clChenLiang/keyboard-trackpad-cross-axis-redesign/outputs/cross-axis-slider-v12-usability-audit/references/exploded-reference.jpg

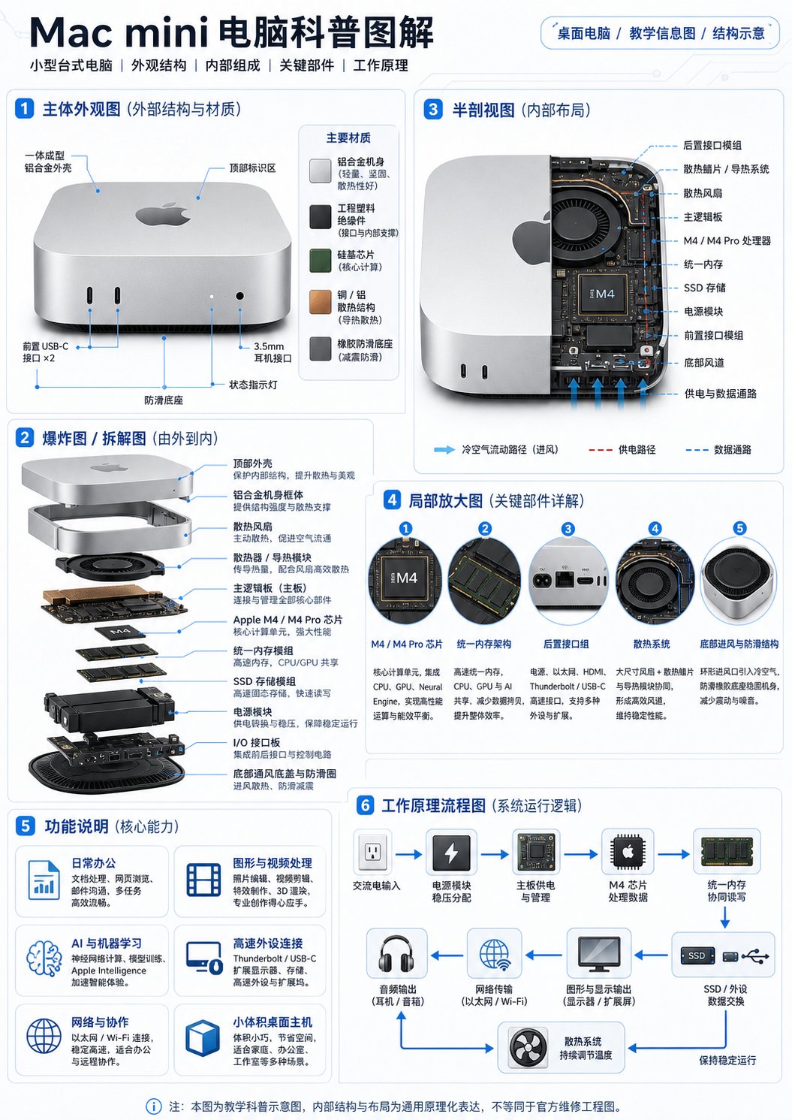
outputs/cross-axis-slider-v12-usability-audit/references/exploded-reference.jpg
