clChenLiang/keyboard-trackpad-cross-axis-redesign/docs/superpowers/specs/2026-07-15-v8-collision-free-linkage-design.md

# V8 全行程避碰联动设计

## 目标

保留 V7 已确认的低抬手端位和双侧对称驱动，消除 0%–100% 行程中的实体硬碰撞。旧版本文件保持不变，新模型写入 `cross-axis-slider-concept-v8-collision-free`。

## 结构决定

- 保留键盘 `+30 Y / -15 Z`、妙控板 `-115 Y / -43 Z` 的直线端位，以及由相对位移严格推导的 `+10.929488°` 滑槽。
- 每侧只保留一块蓝色长槽板和一个滚轮。红色驱动杆、蓝色槽板、妙控板固定导轨、键盘固定导轨由内到外分层，实体厚度之间至少保留 0.8 mm 横向净空。
- 交叉轴只从红色驱动杆延伸到蓝色槽板，不再向托盘内侧伸出；滚轮位于槽口内，轴肩不侵入托盘。
- 妙控板和键盘各自采用双滚轮直线导向；滚轮在真实镂空槽内运动，支座放在有效行程以外。
- 双侧压缩弹簧仍沿键盘运动轴布置，终态由实体限位芯确定。弹簧属于柔性件，碰撞验收只豁免其与自身座/芯的设计接触。
- 两个连续托盘保持独立，底板继续使用 308 × 280 mm 四窗口镂空形式。

## 验收

- 201 点运动学采样：槽中心线误差接近数值零、滚轮始终留在槽有效长度内、弹簧单调压缩。
- 21 点实体布尔碰撞采样：底板—运动件、固定件—运动件、键盘运动组—妙控板运动组均无正体积相交；仅允许清单中的轴—连接件和弹簧—座/芯装配关系。
- 输出键盘、50% 中间、妙控板三份 STEP，并在 CAD Explorer 中提供链接。
