clChenLiang/keyboard-trackpad-cross-axis-redesign/docs/superpowers/specs/2026-07-17-v13-under-100-slider-design.md

# V13 百元版交叉滑块联动支架设计规范

日期：2026-07-17  
状态：待用户书面规范确认  
新版本目录：`outputs/cross-axis-slider-v13-under-100/`

## 1. 目标与边界

V13 是独立新方案，不修改或覆盖 V12。单台成本口径为实际消耗的打印材料与五金，
不包含购买整卷耗材、运费、打印机折旧和失败重打，目标不超过人民币 100 元。

保留以下用户需求：

- 键盘托与妙控板托为两个独立、完整连续平面。
- 键盘位于下层主位，妙控板靠右对齐并停放在其上方或后方。
- 左手按下并向前下方推动键盘托，妙控板托进入右手区域并轻微下降。
- 松手自动回位。
- 左右双侧对称支承，不使用侧护罩、桌夹或掌托。
- 交叉点必须是真实滑动副，不允许用伸缩刚性杆掩盖运动矛盾。

V13 允许降低工业级寿命与恒力手感，但不得牺牲基本可动性、端位可靠性和输入表面完整性。

## 2. 降本决策

V13 删除：

- 604ZZ 导向轴承 8 个。
- AMPG 精密肩轴 12 根及其对应的 12 组垫片、螺母。
- MISUMI CFS0.2 恒力弹簧 2 只及卷筒、挡帽、端片固定结构。
- 与上述零件专用的导向偏心套和轴向堆叠空间。

V13 保留：

- MR84ZZ 交叉滚轮 4 个，每侧 2 个。
- 左右对称的红色键盘运动件与蓝色妙控板运动件。
- 蓝色长槽内两个滚轮接触相对槽壁的真实滑动交点。
- 可调端位和独立回位件。

## 3. 机构架构

### 3.1 直线导向

原 604ZZ 滚轮斜槽改为宽面打印滑块导向。每个托盘在左右两侧各设置一个长导向鞋，
导向鞋与固定侧框的浅 U 形导轨配合。单侧轨道负责定位，另一侧增加 0.6–1.0 mm
横向随动余量，继续采用“左侧基准、右侧随动”策略，避免双侧过约束。

导向鞋是独立可更换打印件。工作面粘贴 0.10–0.20 mm PTFE/UHMW 耐磨胶带；胶带
损坏时只更换导向鞋或胶带，不更换托盘滑架。导向鞋采用至少 12 mm 长的面接触，
不使用细长打印销承担直线导向载荷。

### 3.2 交叉滑动交点

每侧保留两个 MR84ZZ，安装在红色键盘滑架上，并置于蓝色妙控板滑架的长槽内。
两个滚轮分别接触长槽的相对壁，以承担正反向载荷并限制间隙。

轴承安装改为一体打印加强轴座：轴座根部外径不小于 8 mm，短轴颈只穿过 3 mm
宽的 MR84ZZ 内圈。使用普通 M3 低头螺钉和小垫片防止轴承轴向脱出。打印轴颈
不承担 12–20 mm 的细长悬臂载荷。

左侧第二个滚轮保留小范围偏心或椭圆调节座，用于消除明显间隙；右侧长槽适当放宽，
不进行双壁强预紧。

### 3.3 自动回位

每侧使用一根普通拉伸弹簧，沿键盘导向轨迹布置。固定端连接侧框，移动端连接键盘
滑架。弹簧在键盘默认端位保持最小预拉伸，确保松手后无空程回位。

拉簧目标参数：

- 两侧合计默认端回位力 3–5 N。
- 满行程两侧合计回位力不超过 8 N。
- 有效伸长覆盖键盘完整行程并保留至少 20% 行程余量。
- 两只弹簧来自同一规格和批次。

最终型号在参数化运动与力学窗口计算后确定；首个概念 STEP 只显示真实弹簧安装点与
包络，不把暂定商品型号写死为已验证件。

### 3.4 端位

取消轴承撞槽端的限位方式。默认端和按压端均由可更换 TPU 95A 缓冲块接触打印止挡。
缓冲块采用卡入式结构，不增加金属紧固件。两端均保留至少 2 mm 的交叉滚轮槽端余量。

## 4. 打印结构

- PETG-HF：底座、左右固定侧框、两托盘、四个运动滑架和可更换导向鞋。
- TPU 95A：设备垫、底脚和端位缓冲块。
- 底座继续开放式镂空，目标 PETG 总消耗 450–550 g。
- TPU 总消耗不超过 20 g。
- 托盘保持连续输入面，不在键盘或妙控板支承区域开材料孔。
- 所有运动副都位于托盘侧边，不跨越输入表面。

## 5. 目标五金清单与成本上限

| 项目 | 数量 | 目标小计 |
|---|---:|---:|
| MR84ZZ | 4 | ¥12–20 |
| 普通 M3 低头螺钉和小垫片 | 4 组 | ¥3–6 |
| 普通拉伸弹簧 | 2 | ¥8–15 |
| 托盘、侧框连接用 M3/M4 螺钉螺母 | 1 套 | ¥9–12 |
| PTFE/UHMW 耐磨胶带 | 实际用量 | ¥3–5 |
| PETG-HF | 450–550 g | ¥29–36 |
| TPU 95A | 不超过 20 g | ¥2–5 |
| **目标合计** |  | **¥66–99** |

采购门槛：MR84ZZ 单价超过 5 元或拉簧一对超过 15 元时，不得直接扩大总预算，必须
改用同尺寸替代供应商或进一步减材。

## 6. 参数化与输出

采用 STEP-first 的 build123d/Python，建立以下核心参数：

- 键盘与妙控板各自的 Y/Z 行程。
- 交叉长槽长度、宽度、方向与两个滚轮间距。
- 左右导向轨迹、右侧随动间隙和导向鞋长度。
- 拉簧固定点、移动点、预拉伸和全程长度。
- 两端 TPU 止挡位置与槽端安全余量。

第一阶段输出独立的 `keyboard_mode.step`、`mid_mode.step`、`trackpad_mode.step` 和
`master_assembly.step`。STEP 中按固定结构、键盘运动组、妙控板运动组、交叉滚轮、
回位件和缓冲件分别标记，便于 CAD Explorer 单独选择。

## 7. 验证门槛

概念 STEP 至少通过：

1. 401 个运动采样点的交叉长槽闭合关系。
2. 左右轨迹一致性和右侧随动余量检查。
3. 全行程无刚性零件碰撞。
4. 两端滚轮距离长槽端部至少 2 mm。
5. 拉簧长度、预拉力、最大拉力和行程余量计算。
6. 手部区域无侧护罩、连杆或弹簧侵入。
7. CAD 体积换算后的 PETG、TPU 用量和百元 BOM 复核。

在首件实物完成前，不宣称长期寿命、摩擦系数或最终手感已经验证。首件需要检查启动
摩擦、左右同步、导向鞋磨耗、回位连续性，并至少完成 100 次慢速循环。

## 8. 已接受的取舍

- 普通拉簧的力会随行程上升，不具备恒力弹簧的均匀手感。
- 打印导向鞋的摩擦和寿命不如滚珠轴承，需要定期更换耐磨胶带。
- 百元目标优先于工业标准件、免维护寿命和极低摩擦。
- 交叉滑动交点仍保留滚珠轴承，因为它是联动可靠性最敏感的位置。
