clChenLiang/keyboard-trackpad-cross-axis-redesign/outputs/cross-axis-slider-v12-usability-audit/CAD_BRIEF.md

# V12 CAD 交付摘要

- 坐标：X 左右，+Y 朝显示器，+Z 向上，单位 mm。
- 键盘托行程：`+30 Y / -17 Z`；妙控板托行程：`-115 Y / -40 Z`。
- 妙控板工作位托盘 Z=28；装上设备后，其操作面比默认键盘操作面高约 5 mm。
- 两托盘均保留 279.7 × 115.7 连续平面；妙控板靠右。
- 运动拓扑：左右固定直线槽＋左右交叉长槽。左侧定轨，右侧槽额外加宽 1.00 mm 作为随动侧，避免重复刚性约束。
- 回位：左右各一只 MISUMI CFS0.2，原装卷筒套入侧架 Ø7.8 一体轴柱，原装端片固定到侧框。
- 限位：两根 Ø3 导杆上的 TPU C 环承担端位；滚轮不撞槽端。
- 托盘筋宽 11；20 N 一阶梁筛查中心挠度 0.948 mm。
- STEP：`keyboard_mode.step`、`mid_mode.step`、`trackpad_mode.step`、`master_assembly.step`。
- 设备净空参考：`device_clearance_reference.step`；主查看文件仍隐藏设备包络。
- 滚轮查看：`roller_detail_assembled.step`、`roller_detail_exploded.step`。
- 制造文件：`printables/` 下分件 STEP/STL 与 6 张单材料 3MF。

已记录但未隐藏的包络偏差：当前完整金属紧固件总宽约 347.6，超过 310 mm 原目标；当前总高约 97.5，超过 85 mm 原目标。继续压低会令交叉槽、导向滚轮和固定框发生实体相交，因此本版优先保证真实闭合与低手部抬升。上述偏差仍需用户接受或在下一代重新布置 X 向层级。

强度结果是一阶筛查，不是 FEA。10,000 次寿命、45°C 蠕变、按压力和回位时间仍必须由首件实测。
