clChenLiang/keyboard-trackpad-cross-axis-redesign/outputs/cross-axis-slider-v12-usability-audit/FIRST_ARTICLE_CHECKLIST.md

# V12 首件打印与实体验收

数字验证已覆盖 401 个运动采样点和 101 个精确碰撞姿态，但首件循环仍是投入使用前的必做项。
实测数值统一填写到 `FIRST_ARTICLE_RESULTS.csv`，不要只勾选而不记录数据。

## 打印前

- [ ] 先打印 `printables/calibration_coupon.*`，确认 604ZZ、MR84ZZ、偏心套和 M4 热熔螺母配合。
- [ ] 在切片软件中确认六张 3MF 保持多对象结构；不要自动合并相交物体。
- [ ] PETG-HF 与 TPU 95A 分开打印；按 `PRINT_SETTINGS.md` 设置壁数、填充和支撑。
- [ ] 到货型号为 MISUMI CFS0.2；确认 0.2 的单位为 kgf，并记录两只弹簧实测力值。

## 空载装配

- [ ] 左右框固定后六脚同时着地，侧框无肉眼可见内八/外八。
- [ ] 12 个轴承外圈均能转动，螺母只夹紧内圈。
- [ ] 左侧交叉滚轮轻触长槽相对壁；右侧为随动侧，允许小间隙但不得敲击或夹死。
- [ ] 两根 Ø3 × 122 限位导杆到底；每只 CFS0.2 初始展开不少于 45 mm，原装端片和 TPU 挡帽已安装。
- [ ] 左右托盘连接均已刚性锁紧；右侧只通过加宽导槽随动，没有 TPU 轴向垫片。

## 空载循环

- [ ] 慢速完成 20 次全行程，左右端同步。
- [ ] 中间任意位置松手，能连续返回键盘端位。
- [ ] 两端由 TPU 环限位；轴承不撞槽端。
- [ ] 无钢带擦碰、跳卷、轴承拖滑、异响或明显偏磨。

## 带载循环

- [ ] 放入实际键盘与妙控板后完成 100 次慢速全行程。
- [ ] 实测启动力不超过 8 N（首件绝对上限 12 N），保持力目标 6–8 N；超出时先检查右侧过度预紧与 CFS 批次。
- [ ] 从 25%、50%、75% 行程分别松手，均能自动回到键盘端；记录空载回位时间，目标 0.4–0.7 s。
- [ ] 妙控板终态能到右手区，键盘托不妨碍手部抬升。
- [ ] 100 次后复查 M3 螺母、M4 螺钉、热熔螺母和 TPU 环，无松动或位移。
- [ ] 检查两侧所有可触及动态夹缝；任一处必须在全行程保持不大于 4 mm 或不小于 25 mm。无法满足时先增加固定侧护罩，再重新完成循环与碰撞验收。

任一项失败即停止使用，记录失败姿态、左右侧、接触位置和弹簧批次后再修改 CAD；不要靠增大偏心预紧掩盖几何干涉。

## 耐久与环境释放门槛

- [ ] 20 N 中央静载后测量托盘挠度；目标不超过 1.0 mm。
- [ ] 8 N 偏心按压时无卡滞。
- [ ] 12 N 斜向推力下底座滑移不超过 1.0 mm。
- [ ] 45°C 放置 24 h 后复测端点与按压力。
- [ ] 完成 10,000 次循环，期间每 1,000 次记录松动、磨损和端点重复性。
