clChenLiang/keyboard-trackpad-cross-axis-redesign/outputs/cross-axis-slider-v12-usability-audit/PROCUREMENT.md

# 外购件核对

## 恒力弹簧

- 型号：MISUMI `CFS0.2`，数量 2。
- 额定力：0.2 kgf = 1.961 N/侧；注意型号数字不是牛顿值。
- 最大行程：500 mm；本机构有效展开行程约 125 mm，另有 45 mm 初始展开量。
- 标称耐久：35,000 次；载荷公差 0/+15%。
- 小规格外形：D26、D1 8.2、W10、端片孔 d3.2、端片长18。
- 原装 PE 卷筒和带孔端片都必须保留；不要另购 608 轴承或打印替代卷轮。

官方产品页：<https://uk.misumi-ec.com/vona2/detail/110302307050/?HissuCode=CFS0.2>

官方目录：<https://us.misumi-ec.com/pdf/fa/2019/2019_US_2526.pdf>

## 到货检查

1. 包装型号必须为 `CFS0.2`，不是 `CFS2.0`。
2. 两只弹簧分别用推拉力计抽测；记录稳定段力值与批次。
3. 卷筒孔应能在 Ø7.8 试轴上自由转动，无明显径向摆动。
4. 原装端片 Ø3.2 孔不得扩孔；使用 M3 × 8 与热熔螺母固定。
5. 若任一尺寸或力值与上述不符，停止装配并重新计算回位窗口。

## 滚轮与肩轴

- 交叉槽滚轮：`MR84ZZ`，4 × 8 × 3 mm，数量 4。
- 固定导槽滚轮：`604ZZ`，4 × 12 × 4 mm，数量 8。
- MISUMI AMPG 超低头肩轴，肩部 Ø4、M3 × 0.5 × 4 螺纹、头部 Ø6 × 1.30 mm：
  - `STR402M4X20HUL`，20 mm 肩长，数量 4；
  - `STR402M4X16HUL`，16 mm 肩长，数量 4；
  - `STR402M4X12HUL`，12 mm 肩长，数量 4。

官方尺寸页：<https://us.c.misumi-ec.com/book/1AM1_USA_02/pdf/0143.pdf>

604ZZ：<https://uk.misumi-ec.com/vona2/detail/221000058378/?HissuCode=604ZZ>

MR84ZZ：<https://uk.misumi-ec.com/vona2/detail/221000528976/?HissuCode=MR84ZZ>
