clChenLiang/keyboard-trackpad-cross-axis-redesign/outputs/cross-axis-slider-v12-usability-audit/RELEASE_STATUS.md

# V12 发布状态

状态：**数字设计候选通过；尚未批准作为日常使用成品。**

## 已通过

- 401 点运动学与双边并行/随动检查。
- 101 点完整 BREP 碰撞和近间隙扫描，0 碰撞。
- 打印容差预算后的机构/设备最小净空均不小于 1.0 mm。
- 五金堆栈、连接界面、单实体、H2D 排盘、STL 封闭性和一阶强度筛查。

## 仍需实物关闭

- 校准片、热熔螺母和轴承/偏心套的真实配合。
- 20/100 次首件循环，启动力、保持力和自动回位时间。
- 20 N 挠度、8 N 偏心输入、12 N 底座防滑和 45°C/24 h。
- 10,000 次寿命与紧固件松动检查。
- 两侧交叉槽/连杆目前外露。投入日常使用前必须通过夹手风险实测；可触及动态间隙需做到不大于 4 mm 或不小于 25 mm，未满足时必须增加不随动的侧护罩，不能仅贴警示标签。

在上述项目完成并记录到 `FIRST_ARTICLE_RESULTS.csv` 前，本版只作为工程首件打印候选。
