clChenLiang/keyboard-trackpad-cross-axis-redesign/outputs/rack-pinion-swing-tray-main-v3/CAD_BRIEF.md

# 键盘托／妙控板托切换主体 V3 — 连接与检修物理化

本目录是独立 V3，不修改或覆盖 V1/V2。单位为 mm；X 左右、+Y 朝显示器、+Z 向上。

## 本轮模型

- 基线：完整连续键盘托、160.8 × 115.7 mm 妙控板目标托、齿条—26T 小齿轮—竖轴—偏心悬臂、四点平行斜导向及 V2 已验证的运动关系。
- 四个滑块：各增加一个可单独选中的托底连接耳；键盘托侧增加四个真实匹配孔和可单独选中的衬套，全部采用 M4 名义通孔并随键盘托作同一刚体平移。
- 四组固定导轨：各增加一组可单独选中的双安装脚和底座孔位接口；安装脚落在底座顶面，孔位以 M4 名义通孔表达。
- 固定圆筒：原一体式顶封板已开通为 Ø33 mm 检修口；增加可拆上盖、轴孔及两处前上方紧固孔接口。爆炸剖视中上盖上移，拆盖后检修路径真实贯通。
- 齿条：增加可单独选中的刚性过渡板，将齿条背脊与键盘托底面真实桥接。

## 参数与定位

- M4 名义通孔：4.5 mm。
- 连接耳厚度：4.0 mm；每个耳板一个通孔。
- 托盘衬套：外径 7.0 mm、托盘配孔 7.2 mm、内孔 4.5 mm；四件均为独立标签。
- 导轨安装脚：沿导轨行程两端布置，落地 Z = 底座顶面；每组两个通孔。
- 圆筒上盖：外径 38 mm、厚 3 mm；中心轴孔与两处 M3 名义孔接口。两紧固柱位于半径 14 mm、75°/105°，避开摆臂全行程。
- 所有运动件的位置只由归一化姿态 `t ∈ [0,1]` 派生，不引入新的运动自由度。

## 输出

- `keyboard_mode.step`
- `mid_mode.step`
- `trackpad_mode.step`
- `cylinder_section_exploded.step`

## 回归门槛

- 至少 11 个姿态检查新增件标签、正体积、刚体随动和关键不干涉。
- 保持 V2 四滑块、四导轨、完整键盘托、妙控板托、齿条、齿轮、竖轴、悬臂和圆筒标签。
- 四个 STEP 可重新读取并保留新增可选标签。

## 明确不做

不引入 A–P 卷筒方案；不定版弹簧、公差、强度/疲劳、BOM、STL/3MF、打印排盘、ZIP 或专利。
