clChenLiang/keyboard-trackpad-cross-axis-redesign/docs/superpowers/specs/2026-07-15-v9-force-closed-cross-slider-design.md

# V9 真实受力闭合交叉滑槽设计

## 目标

新建 `cross-axis-slider-concept-v9-force-closed`，保留 V1–V8。V9 必须满足真实力流：按压键盘托盘后，力通过连续键盘侧架、交叉轴和滚轮作用于连续妙控板槽架，并由妙控板导向副约束为目标运动。

## 拓扑选择

比较三种方案：

1. 固定摇臂加两条径向槽：在当前尺寸内数值搜索得到的最差输出传力投影约 0.14，低于直槽方案。
2. 齿条、同步带或钢索：传力方向更好，但偏离交叉滑槽语义且零件数增加。
3. 双侧直槽滚轮耦合：输出传力投影约 0.166，虽然行程放大导致输入力较大，但它是当前尺寸和少零件约束下最直接、最符合草图的方案。

采用方案 3。3.66 倍行程放大对应至少 3.66 倍理想输入力，这是虚功决定的物理代价，不把它包装成轻触机构。

## 真实刚体与运动副

- 每侧红色键盘侧架为连续实体：托盘连接桥、三角驱动臂、交叉轴根部、两根键盘导向轴根部、弹簧活动座互相重叠连接。
- 每侧蓝色妙控板侧架为连续实体：托盘连接桥、长槽板、两根妙控板导向轴根部互相重叠连接。
- 交叉滚轮外径等于名义槽宽，STEP 中表现为无穿透接触；轴与滚轮内孔同样名义接触。
- 两个托盘各由双滚轮直线导向抑制俯仰，滚轮轴必须与对应连续侧架连接。
- 压缩弹簧沿键盘运动方向布置，活动座属于红色侧架，固定座属于底座框架；两端名义接触。

## 运动与验收

- 键盘端位保持 `+30 Y / -15 Z`。
- 妙控板端位保持 `-115 Y / -43 Z`。
- 直槽角由相对位移推导，为 `+10.929488°`。
- 201 点运动学检查验证槽约束、单调运动和虚功比例。
- 0%、50%、100% 三姿态检查刚体连接图；键盘托到交叉轴、键盘托到两根导向轴、妙控板托到槽板及两根导向轴均必须连通。
- 21 点实体碰撞检查必须无非设计相交；名义接触与同一刚体内部融合不计为碰撞。
- 第一阶段只输出三份 STEP 和 CAD Explorer 链接，不做公差、摩擦、弹簧选型、强度或打印文件。
