clChenLiang/keyboard-trackpad-cross-axis-redesign/docs/superpowers/specs/2026-07-16-v12-exploded-infographic-design.md

# V12 键盘/妙控板切换支架拆解图设计规格

## 目标

制作一张竖版中文产品拆解信息图，视觉语言参考用户提供的 Mac mini 科普图：白色技术说明书背景、蓝色编号标题、清晰的三维爆炸结构、细引线标注和局部放大。图片用于解释当前 V12 CAD 结构，不替代装配图或制造图。

## 构图

- 画布：竖版，约 3:4；白色或极浅灰技术背景，留足四周安全边距。
- 顶部：标题“键盘 / 妙控板联动支架｜结构拆解图”，副标题“交叉长槽联动 · 双侧滚轮导向 · 恒力自动回位”。
- 中央主图：三分之四等轴测视角，沿 Z 向和少量左右方向分层展开，零件保持共同中心线和真实装配方向。
- 右下局部图：肩轴、偏心套、MR84ZZ/604ZZ、垫片和 M3 螺母堆栈放大。
- 底部：一条简短运动链说明，不做复杂流程面板。

## 爆炸层级（由上到下）

1. 蓝色妙控板托盘及 4 个 TPU 垫。
2. 红色键盘托盘及 4 个 TPU 垫。
3. 蓝色左右妙控板滑架，突出交叉长槽与 CFS 卷筒轴柱。
4. 红色左右键盘滑架，突出双交叉滚轮安装点。
5. MR84ZZ 交叉滚轮组和 604ZZ 直线导向滚轮组，肩轴/垫片/螺母沿轴向适度展开。
6. 左右深灰固定侧框，显示两组斜导槽、斜撑和回位固定座。
7. 左右 CFS0.2 恒力弹簧、钢带、TPU 挡帽、Ø3 导杆和四个 TPU 端位环。
8. 深灰开放式镂空底座及 6 个 TPU 防滑脚。

## 颜色和材质

- 键盘运动组：哑光工程红。
- 妙控板运动组：哑光工程蓝。
- 固定框与底座：深石墨灰。
- 轴承：暖金色金属外圈；肩轴、垫片、螺母：银色金属。
- CFS 钢带：浅黄铜/香槟金色；TPU：深黑或深灰。
- 保留轻柔环境阴影，但不使用强反射、黑色摄影棚或夸张霓虹灯。

## 中文标注

主标注限制为 8 项，避免信息拥挤：

1. 完整连续妙控板托盘
2. 完整连续键盘托盘
3. 妙控板长槽滑架
4. 键盘交叉滚轮滑架
5. 604ZZ 双侧斜槽导向
6. MR84ZZ 双滚轮滑动交点
7. MISUMI CFS0.2 恒力回位
8. 开放式镂空底座 / 六点防滑

局部放大标注：超低头肩轴、偏心调节套、轴承、平垫片、M3 螺母。

底部运动链原文：

“按下键盘托 → 交叉滚轮沿蓝色长槽滑动 → 妙控板托向右手区域前移并下降 → 松手后恒力弹簧自动回位”

## 准确性边界

- 当前 CAD 截图是主体与颜色参考；用户提供图片只作为版式与信息密度参考。
- 不添加侧护罩、桌夹、掌托、齿轮、电机或不存在的连杆。
- 两托盘必须独立，不合并成同一板件。
- 交叉自由度必须画成长槽内滚轮，不得画成固定中心铰链。
- 左右机构保持对称；允许为展示而增加爆炸间距，但不得改变零件连接顺序。
- 不使用 Apple 标志、产品商标、水印或虚构认证标识。
- 小字号若生成质量不足，可省略说明文字，但主标题、8 个组件名称和运动链应保持中文可读。

## 验收标准

- 一眼能分辨固定组、键盘组、妙控板组和回位组。
- 爆炸顺序与真实装配拓扑一致。
- 能看见真实长槽、双交叉滚轮和两侧导向结构。
- 主要中文没有错字、乱码或不完整字符。
- 无新增虚构组件、明显悬浮错位、穿插或重复托盘。
- 图片保存到 `outputs/cross-axis-slider-v12-usability-audit/exploded-infographic-v1.png`，不覆盖 CAD、STEP 或原始参考图。
