clChenLiang/keyboard-trackpad-cross-axis-redesign/outputs/cross-axis-slider-concept-v2-open-base/CAD_BRIEF.md

# Cross-axis slider concept v2 — open base brief

- Scope: preserve all v1 tray, guide, cross-axis pin, slot-link, and endpoint geometry.
- Versioning: v1 remains unchanged; v2 is generated in this separate directory.
- Base envelope: unchanged at 310 × 300 × 4 mm.
- Lightening pattern: four rounded 112 × 112 mm through-windows with 10 mm corner radii.
- Remaining load paths: approximately 32.5 mm solid side rails, 21 mm longitudinal center rib, 26 mm transverse center rib, and 25 mm front/rear borders.
- Nominal base-only material reduction: approximately 53.7% by volume versus the solid v1 base.
- Validation: the base must remain one connected positive-volume solid; assembly width and motion endpoints must remain unchanged; Explorer review must show that the side guide supports and return anchors remain over solid base strips.
- Phase boundary: no strength, deflection, print, tolerance, or full interference certification is claimed.
