clChenLiang/keyboard-trackpad-cross-axis-redesign/outputs/cross-axis-slider-concept-v6-symmetric-spring/CAD_BRIEF.md

# Cross-axis slider concept v6 — symmetric linkage and guide-axis springs

- Independent v6 output; v1-v5 remain unchanged.
- Base: compact 308 × 280 mm four-window open base.
- Keyboard travel: +30 Y / -15 Z.
- Trackpad travel: -115 Y / -7.400872 Z.
- Two active captured linkages: left datum stack and right stack with 0.7 mm total X float.
- Straight slot direction: -3.000° toward +Y, descending in the keyboard push direction.
- Keyboard guidance: elongated captured shoe on each side; right shoe has 0.8 mm less X thickness for assembly float.
- Return concept: a visible seven-turn compression spring lies in each extended keyboard guide slot ahead of the moving shoe. Spring length reduces from 43.541 mm to 10.000 mm over the 33.541 mm keyboard path while remaining above the base plane.
- The two former three-hole spring-anchor tabs are removed.
- Springs are concept envelopes, not selected catalog hardware.
- Phase boundary: no final interference, tolerance, spring-rate selection, friction, strength, manufacturing, STL/3MF, BOM, ZIP, or patent work is claimed.
