clChenLiang/keyboard-trackpad-cross-axis-redesign/outputs/cross-axis-slider-concept-v7-low-lift-stop/CAD_BRIEF.md

# Cross-axis slider concept v7 — low-lift terminal stop

- Independent v7 output; v1-v6 remain unchanged.
- Base: compact 308 × 280 mm four-window open base.
- Keyboard travel: +30 Y / -15 Z; final top surface Z=10.5 mm.
- Trackpad travel: -115 Y / -43 Z; final bottom/top surfaces Z=25.0/28.5 mm.
- Final working-surface height difference: 18.0 mm.
- Constraint-derived bilateral slot angle: +10.929488° toward +Y.
- Raise each crossover roller axis from 21 mm to 37 mm above the keyboard tray datum so the long slot remains above the base at the -43 mm endpoint.
- Preserve bilateral active linkage, left datum stack, right 0.7 mm axial-floating stack, and dual guide-slot springs.
- Add a 10 × 1.8 mm terminal stop core inside each spring. The stop cores, not coil bind, set the final pose.
- Raise the inherited keyboard side carriages, driver lower anchors, and shoe connectors so moving geometry clears the base top by at least 2 mm.
- Phase boundary: concept STEP only; no final interference, tolerance, friction, spring selection, strength, manufacturing, STL/3MF, BOM, ZIP, or patent work is claimed.
