clChenLiang/keyboard-trackpad-cross-axis-redesign/outputs/cross-axis-slider-concept-v8-collision-free/CAD_BRIEF.md

# Cross-axis slider concept V8 — collision-cleared layered linkage

- Independent V8 output; V1–V7 remain unchanged.
- Compact 308 × 280 mm four-window open base.
- Keyboard travel: +30 Y / -15 Z.
- Trackpad travel: -115 Y / -43 Z; final tray top Z = 28.5 mm.
- Constraint-derived slot angle: +10.929488°.
- Bilateral mirror layout with one blue slotted cheek and one crossover roller per side.
- Side stack from inside outward: red driver X=142, blue cheek X=146, trackpad guide X=150, keyboard guide X=153 mm.
- Crossover shaft ends outside the tray envelope and does not extend inward under either tray.
- Dual keyboard-axis compression springs and terminal stop cores are retained as concept geometry.
- Collision acceptance: no positive-volume rigid-body intersection across base/moving, fixed/moving, or keyboard/trackpad moving groups over the sampled stroke, apart from declared spring-seat/core contact.
- Concept STEP only; no final tolerance, friction, spring-rate, strength, fatigue, print, BOM, or manufacturing claim.
