clChenLiang/keyboard-trackpad-cross-axis-redesign/outputs/cross-axis-slider-concept-v9-force-closed/CAD_BRIEF.md

# Cross-axis slider concept V9 — force-closed moving bodies

- Independent V9 output; V1–V8 remain unchanged.
- Keyboard travel: +30 Y / -15 Z.
- Trackpad travel: -115 Y / -43 Z.
- Stroke amplification: 3.66048:1; ideal input force is at least 3.66048 times output-path resistance.
- Constraint-derived straight-slot angle: +10.929488°.
- Each red side carriage is a continuous solid connected to the keyboard tray, crossover shaft, both keyboard guide axles, and moving spring seat.
- Each blue side carriage is a continuous solid connected to the trackpad tray, real slot plate, and both trackpad guide axles.
- Nominal follower diameter equals slot width to show force-bearing contact without solid penetration.
- Dual rolling linear guides constrain pitch on both trays.
- Planar zig-zag compression spring is used as an explicit connected concept spring; final spring selection is outside this phase.
- Phase boundary: concept STEP only; no tolerance, friction, spring-rate, strength, fatigue, manufacturing, STL/3MF, BOM, or patent claim.
