clChenLiang/keyboard-trackpad-cross-axis-redesign/outputs/ap-flat-reel-floating-z-coupon-v1/render/exploded_front.png

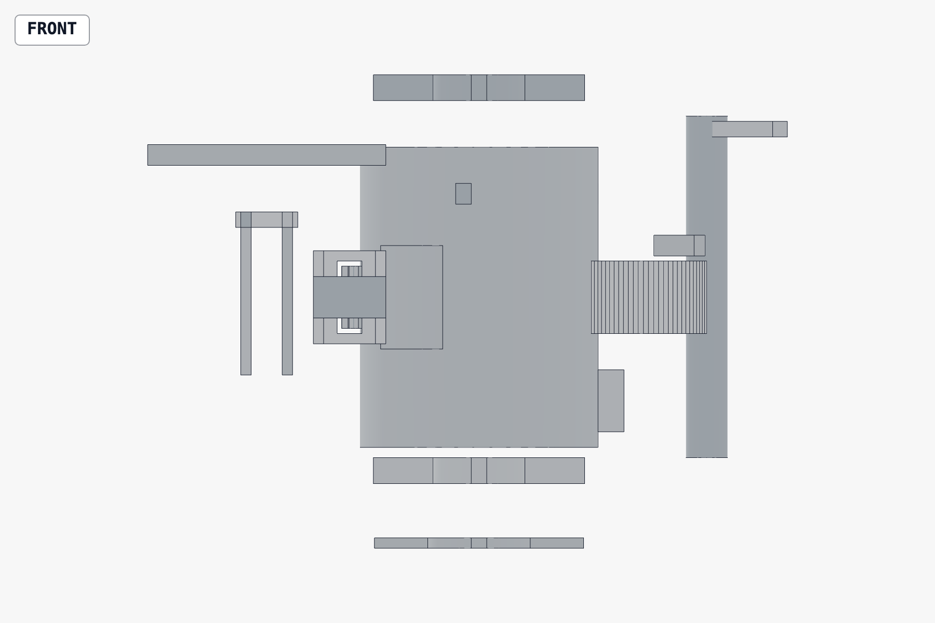
outputs/ap-flat-reel-floating-z-coupon-v1/render/exploded_front.png
