clChenLiang/keyboard-trackpad-cross-axis-redesign/outputs/ap-flat-reel-floating-z-coupon-v1/render/exploded_iso.png

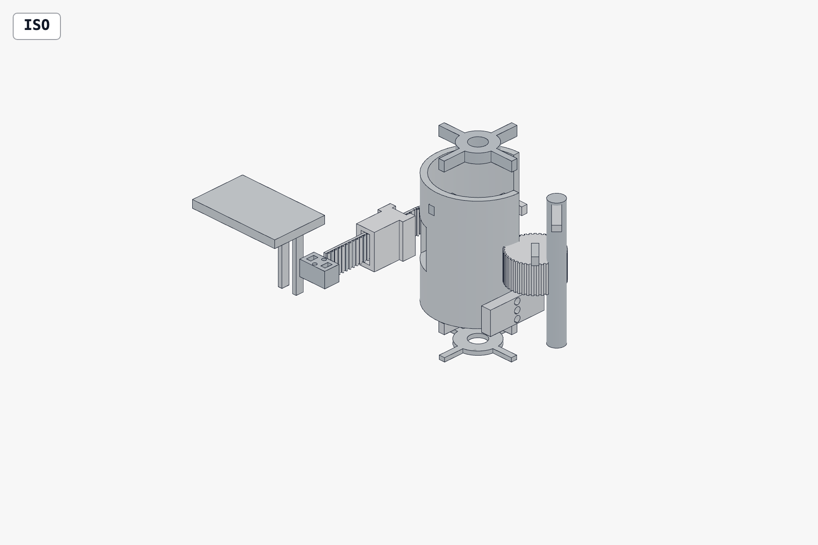
outputs/ap-flat-reel-floating-z-coupon-v1/render/exploded_iso.png
