clChenLiang/keyboard-trackpad-cross-axis-redesign/outputs/ap-flat-reel-floating-z-coupon-v1/render/stored_top.png

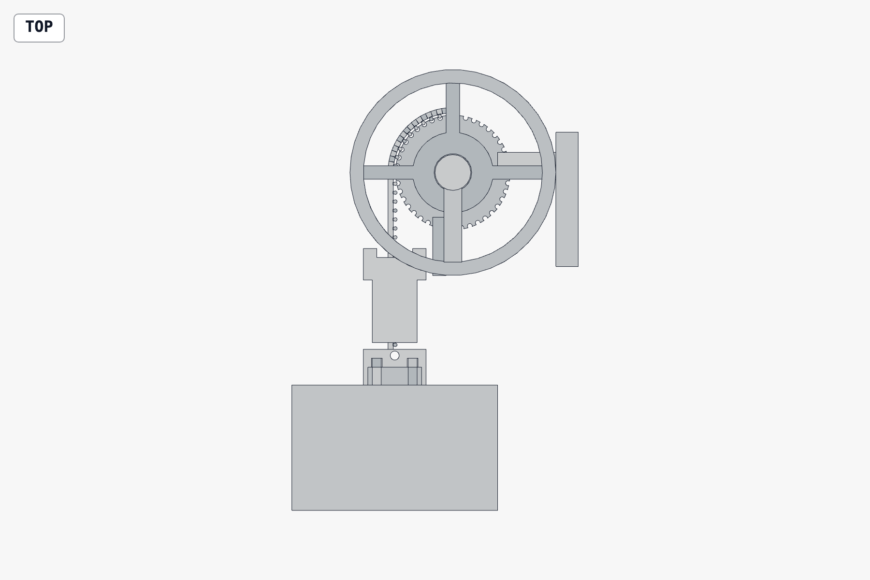
outputs/ap-flat-reel-floating-z-coupon-v1/render/stored_top.png
