clChenLiang/keyboard-trackpad-cross-axis-redesign/outputs/cross-axis-slider-v12-real-exploded/exploded-annotated.png

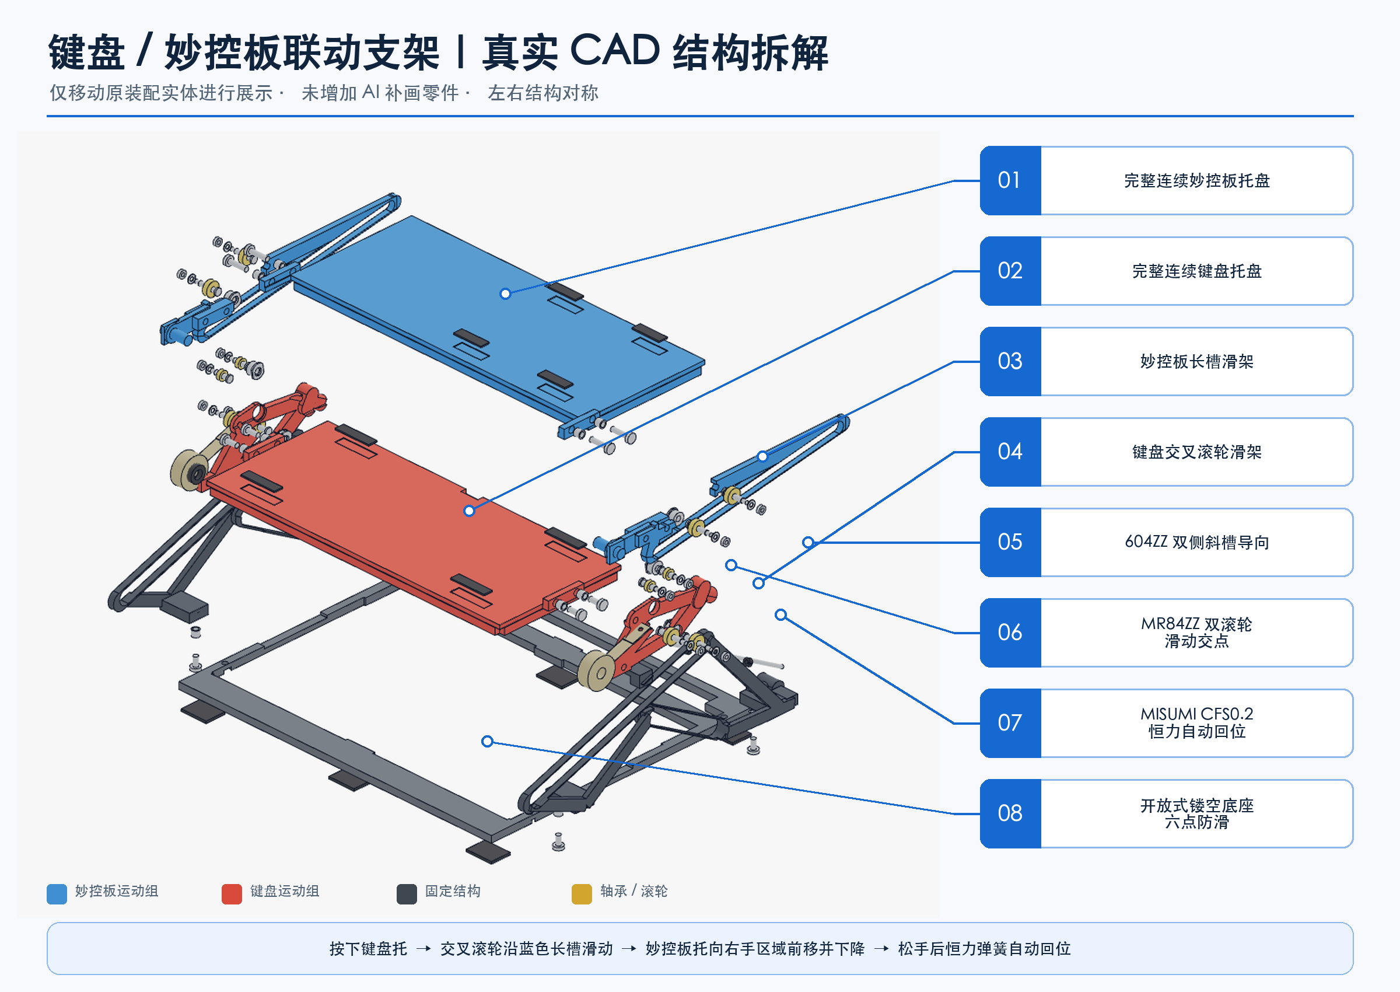
outputs/cross-axis-slider-v12-real-exploded/exploded-annotated.png
