clChenLiang/keyboard-trackpad-cross-axis-redesign/outputs/cross-axis-slider-v12-usability-audit/exploded-infographic-v1.png

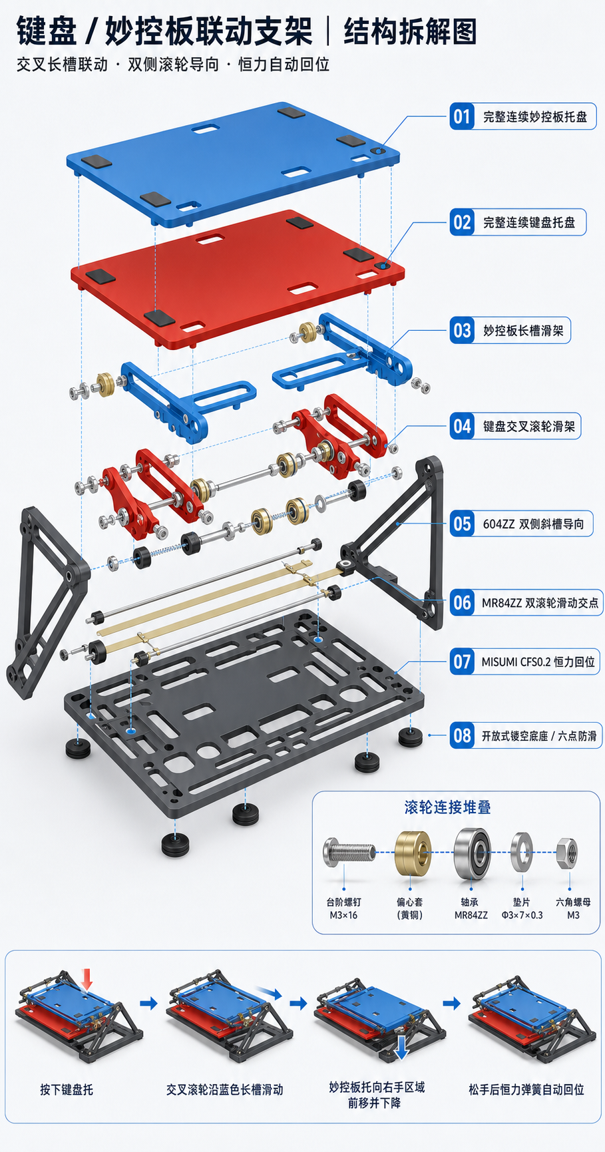
outputs/cross-axis-slider-v12-usability-audit/exploded-infographic-v1.png
