clChenLiang/keyboard-trackpad-cross-axis-redesign/outputs/cross-axis-slider-v12-usability-audit/screenshots/01_keyboard_mode.png

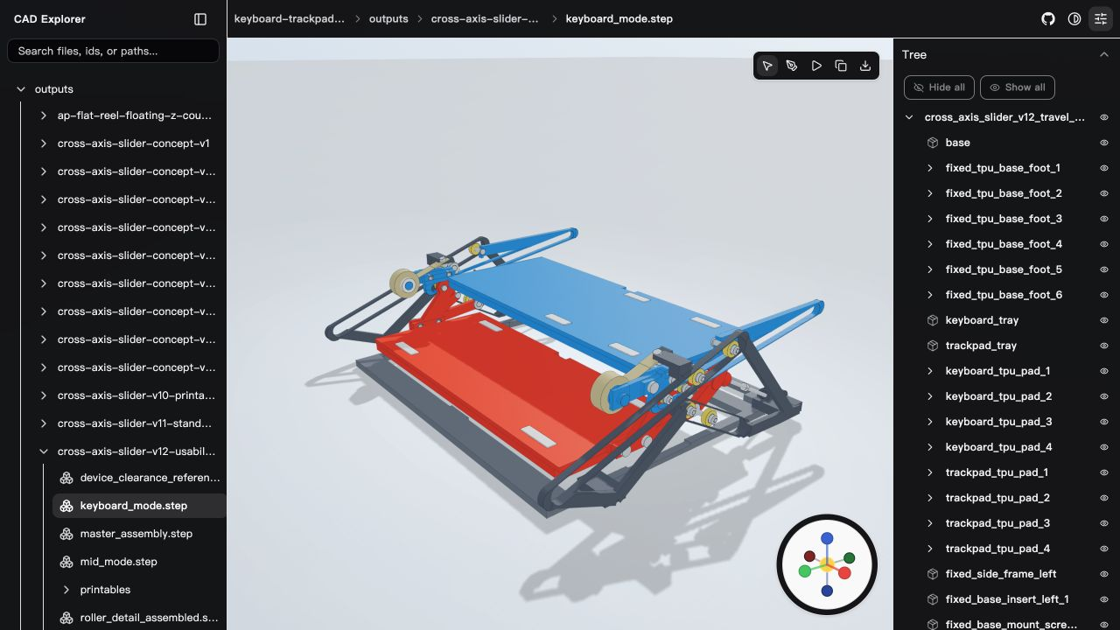
outputs/cross-axis-slider-v12-usability-audit/screenshots/01_keyboard_mode.png
