clChenLiang/keyboard-trackpad-cross-axis-redesign/outputs/cross-axis-slider-v12-usability-audit/screenshots/03_roller_detail_exploded.png

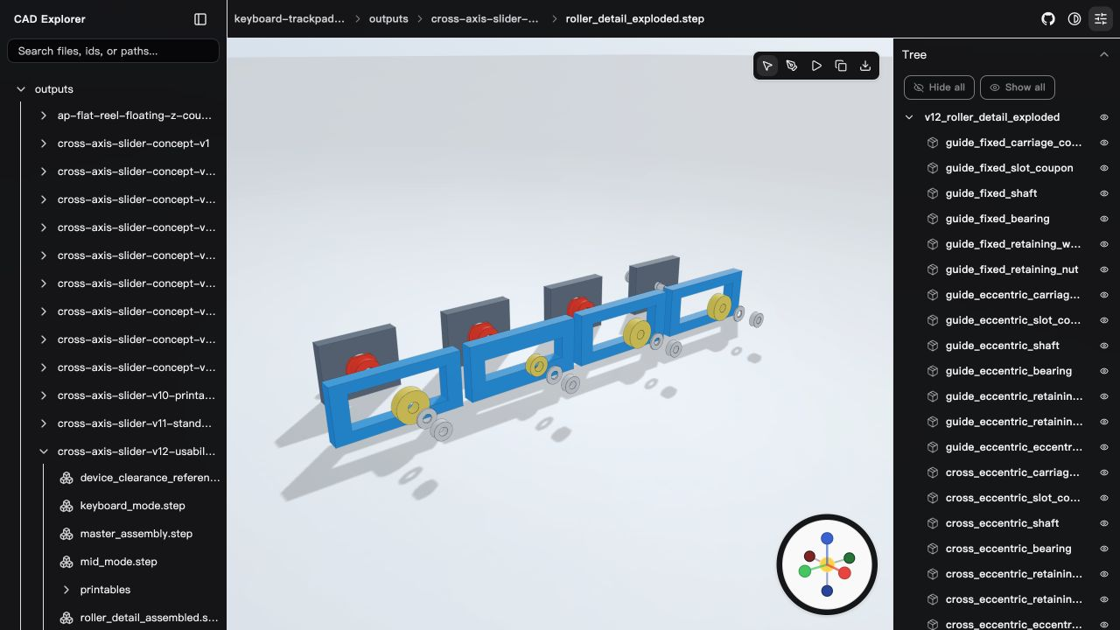
outputs/cross-axis-slider-v12-usability-audit/screenshots/03_roller_detail_exploded.png
