clChenLiang/keyboard-trackpad-cross-axis-redesign/outputs/rack-pinion-swing-tray-concept-v2-supported/keyboard_mode.png

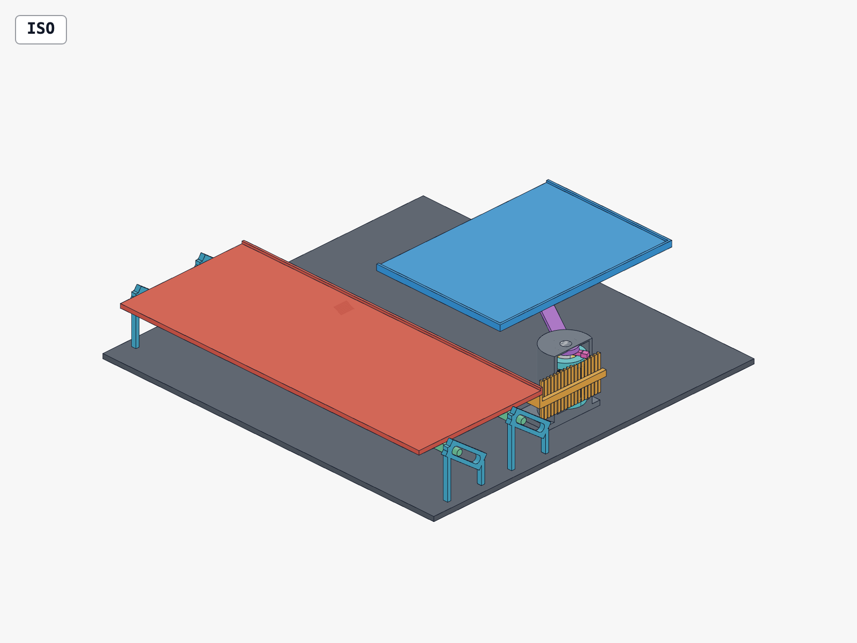
outputs/rack-pinion-swing-tray-concept-v2-supported/keyboard_mode.png
