clChenLiang/keyboard-trackpad-cross-axis-redesign/outputs/rack-pinion-swing-tray-main-v3-integrated-return-v1/render-review/cylinder_return_exploded_iso.png

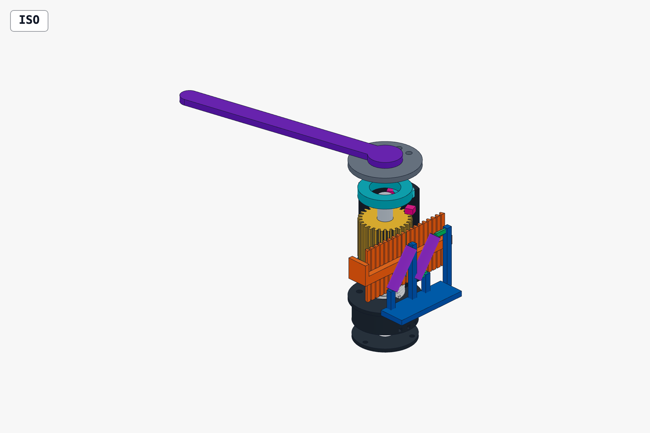
outputs/rack-pinion-swing-tray-main-v3-integrated-return-v1/render-review/cylinder_return_exploded_iso.png
