clChenLiang/keyboard-trackpad-cross-axis-redesign/outputs/rack-pinion-swing-tray-main-v3-integrated-return-v1/render-review/keyboard_iso.png

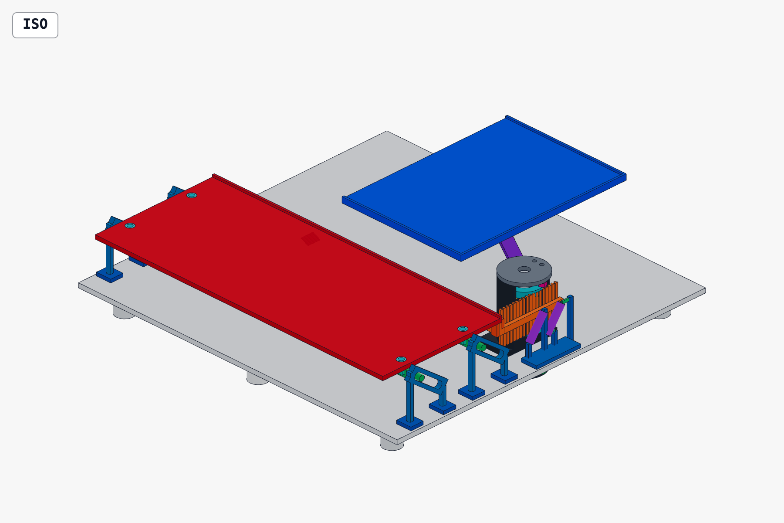
outputs/rack-pinion-swing-tray-main-v3-integrated-return-v1/render-review/keyboard_iso.png
