clChenLiang/keyboard-trackpad-cross-axis-redesign/outputs/rack-pinion-swing-tray-main-v3-open-frame-base-v1/render-review/base_interface_bottom.png

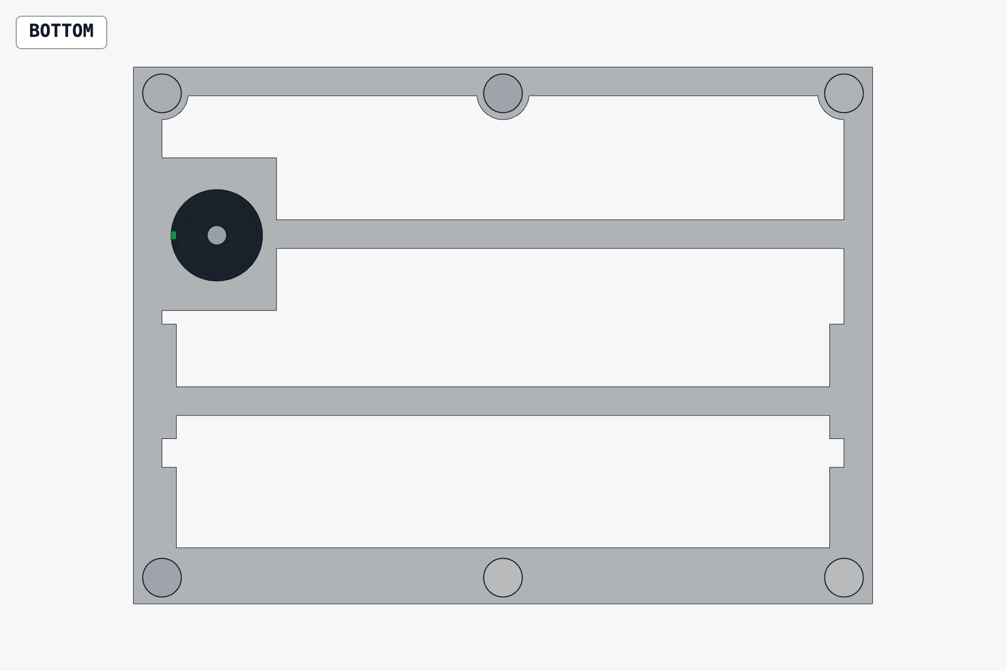
outputs/rack-pinion-swing-tray-main-v3-open-frame-base-v1/render-review/base_interface_bottom.png
