clChenLiang/keyboard-trackpad-cross-axis-redesign/outputs/rack-pinion-swing-tray-main-v3-open-frame-base-v1/render-review/keyboard_top.png

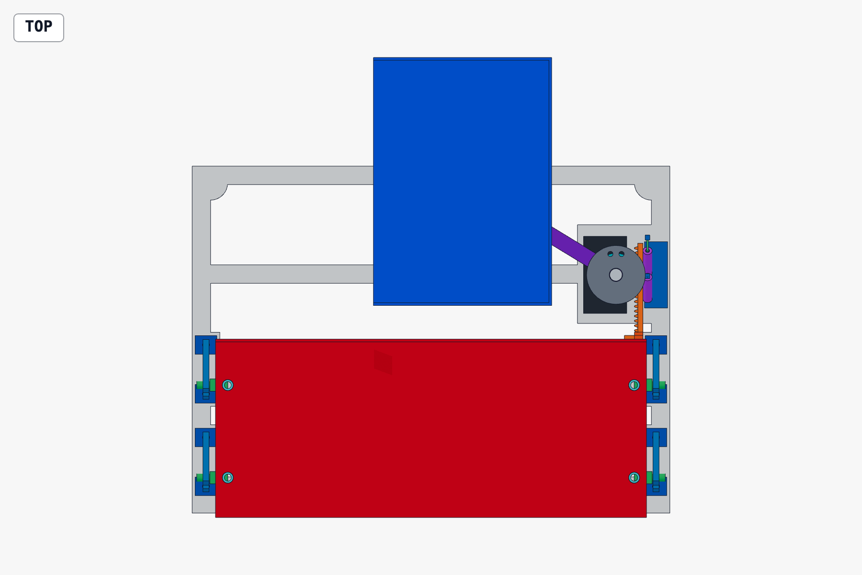
outputs/rack-pinion-swing-tray-main-v3-open-frame-base-v1/render-review/keyboard_top.png
