clChenLiang/keyboard-trackpad-cross-axis-redesign/outputs/rack-pinion-swing-tray-main-v3-optional-torsion-return-module-v1/render-review/torsion_return_exploded_iso.png

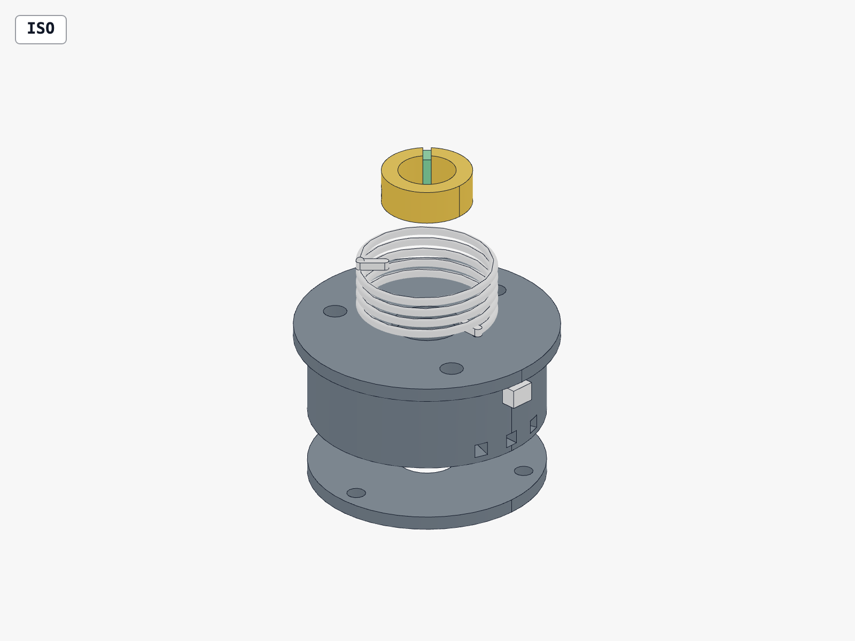
outputs/rack-pinion-swing-tray-main-v3-optional-torsion-return-module-v1/render-review/torsion_return_exploded_iso.png
