clChenLiang/keyboard-trackpad-cross-axis-redesign/outputs/rack-pinion-swing-tray-main-v3-optional-torsion-return-module-v1/render-review/v3_keyboard_optional_return_bottom.png

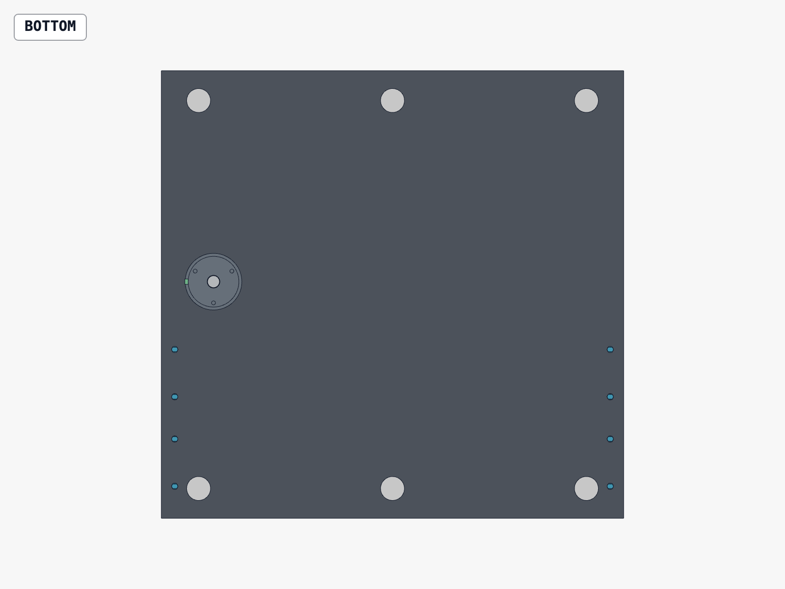
outputs/rack-pinion-swing-tray-main-v3-optional-torsion-return-module-v1/render-review/v3_keyboard_optional_return_bottom.png
