clChenLiang/keyboard-trackpad-cross-axis-redesign/outputs/rack-pinion-swing-tray-main-v3/render-review/cylinder_exploded_iso.png

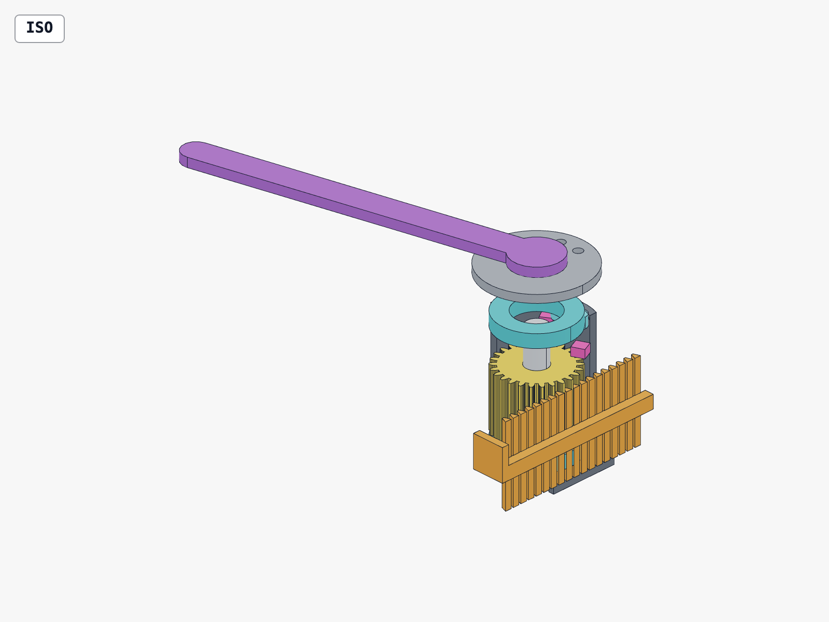
outputs/rack-pinion-swing-tray-main-v3/render-review/cylinder_exploded_iso.png
