clChenLiang/keyboard-trackpad-cross-axis-redesign/outputs/rack-pinion-swing-tray-main-v3/render-review/keyboard_bottom.png

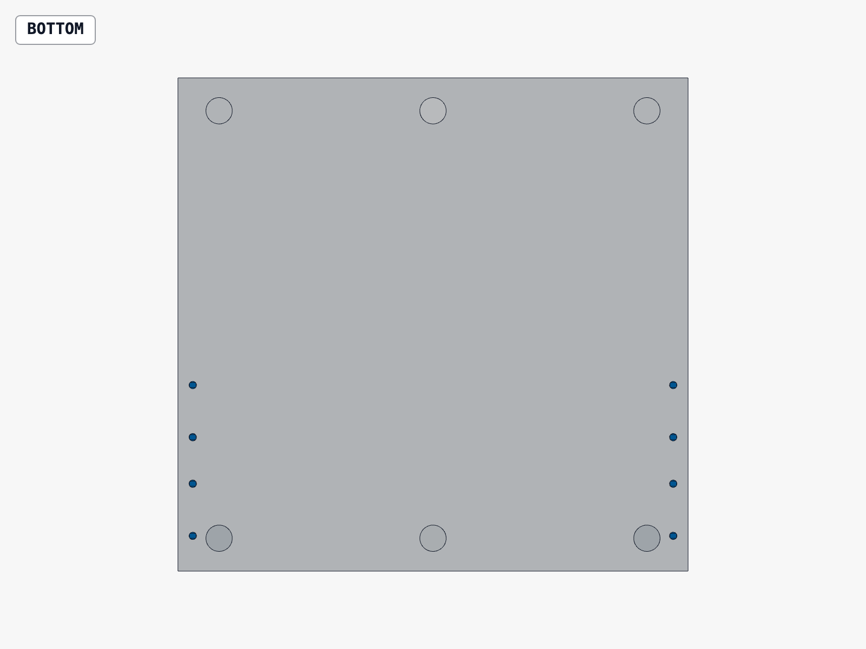
outputs/rack-pinion-swing-tray-main-v3/render-review/keyboard_bottom.png
