clChenLiang/keyboard-trackpad-cross-axis-redesign/outputs/rack-pinion-swing-tray-main-v4-low-profile-reel-cartridge-v1/render-review/keyboard_low_side.png

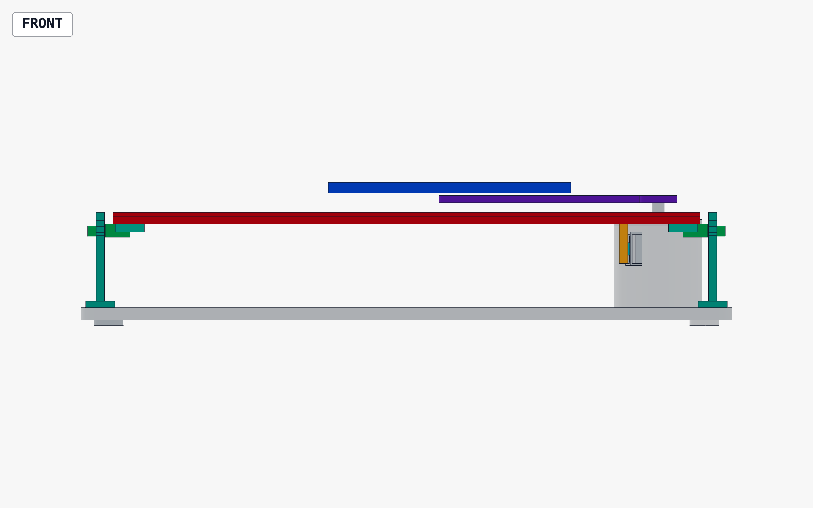
outputs/rack-pinion-swing-tray-main-v4-low-profile-reel-cartridge-v1/render-review/keyboard_low_side.png
