clChenLiang/keyboard-trackpad-cross-axis-redesign/outputs/cross-axis-slider-v12-usability-audit/BOM.md

# V12 可打印联动支架 BOM

单位均为 mm。肩轴必须让轴承只在 Ø4 光肩上转动，不得以全螺纹螺钉代替。

## 打印件

| 材料 | 零件 | 数量 |
|---|---|---:|
| PETG-HF | 开放式底座、左右固定侧框、键盘托、妙控板托 | 各 1 |
| PETG-HF | 键盘左右侧架、妙控板左右侧架 | 各 1 |
| PETG-HF | 交叉偏心套 | 2 |
| PETG-HF | 导向偏心套 | 4 |
| PETG-HF | 尺寸试片 | 1 |
| TPU 95A | 导杆端位缓冲环 | 4 |
| TPU 95A | CFS 卷筒挡帽 | 2 |
| TPU 95A | 键盘垫、妙控板垫 | 各 4 |
| TPU 95A | 底座防滑脚 | 6 |

对应 STEP/STL 位于 `printables/`。打印盘为 5 张 PETG-HF 与 1 张 TPU。

## 滚轮与紧固件

| 零件 | 数量 | 精确规格 | 用途 |
|---|---:|---|---|
| 604ZZ | 8 | 4 × 12 × 4，双面防尘 | 两托盘双侧导向 |
| MR84ZZ | 4 | 4 × 8 × 3，双面防尘 | 交叉长槽联动 |
| AMPG 超低头精密肩轴 `STR402M4X20HUL` | 4 | Ø4 光肩 20；M3×0.5 螺纹 4；头 Ø6 × 1.3 | 键盘导向 |
| AMPG 超低头精密肩轴 `STR402M4X16HUL` | 4 | Ø4 光肩 16；M3×0.5 螺纹 4；头 Ø6 × 1.3 | 妙控板导向 |
| AMPG 超低头精密肩轴 `STR402M4X12HUL` | 4 | Ø4 光肩 12；M3×0.5 螺纹 4；头 Ø6 × 1.3 | 交叉滚轮 |
| M3 平垫片 | 12 | 3.2 ID × 7 OD × 0.5 | 只压轴承内圈 |
| DIN 934 M3 螺母 | 12 | 厚 2.4，5.5 对边 | 肩轴保持 |
| 中强度可拆螺纹锁固剂 | 少量 | 适用于 M3 金属螺纹 | 防松 |

## 回位与结构连接

| 零件 | 数量 | 精确规格 | 用途 |
|---|---:|---|---|
| MISUMI CFS0.2 恒力弹簧 | 2 | 0.2 kgf（1.961 N）；最大行程 500；35,000 次；D26、D1 8.2、W10；带 PE 卷筒和带孔端片 | 左右对称自动回位 |
| M3 × 8 内六角螺钉 | 2 | 每侧 1 | 固定原装端片 |
| M3 热熔螺母 | 2 | OD 4.6 × 长 5.0；打印预孔从 Ø4.0 起标定 | 原装端片固定座 |
| TPU 卷筒挡帽 | 2 | 打印件；压在 Ø7.8 一体轴柱上 | 防止原装卷筒轴向脱出 |
| 不锈钢精密杆 | 2 | Ø3.0 × 122.0 | 仅承载独立 TPU 两端限位 |
| M4 热熔螺母 | 12 | OD 6.2 × 长 5.2；打印预孔从 Ø5.4 起标定 | 底座 4、托盘 8 |
| M4 × 8 内六角螺钉 | 4 |  | 底座到侧框 |
| M4 × 10 内六角螺钉 | 4 |  | 键盘托到侧架 |
| M4 × 16 内六角螺钉 | 4 |  | 妙控板托到侧架 |

## 关键限制

- CFS 型号中的 `0.2` 单位是 kgf，不是 N；不可误购 CFS2.0。
- 不再使用自制 PETG 卷轮、608ZZ 或独立打印夹板。CFS0.2 原装 PE 卷筒直接套在 Ø7.8 打印轴柱上，原装端片用一颗 M3 固定。
- 左侧是运动基准；右侧槽额外加宽 1.00 mm，装配时只消除明显晃动，不得把两侧同时强预紧。
- 左右 X 向肩轴堆栈完全镜像，不使用被 M4 螺钉压紧后无法滑动的 TPU“轴向浮动垫片”。
- 20/16/12 三种肩长由当前轴向层反推；替换长度会改变轴承内圈夹紧关系。
