clChenLiang/keyboard-trackpad-cross-axis-redesign/outputs/cross-axis-slider-v12-usability-audit/MATERIAL_AND_COST_ESTIMATE.md

# V12 打印材料与采购成本估算

估算日期：2026-07-16，币种：人民币。价格不含运费、打印机折旧和失败重打。

## 打印材料

当前 6 张打印盘包含 5 张 PETG-HF 和 1 张 TPU 95A。STL 网格均为闭合实体。

| 材料 | CAD 100% 实心上限 | 按当前墙数/填充推算 | 建议开打前余量 | 参考单价 | 实际消耗成本 |
|---|---:|---:|---:|---:|---:|
| PETG-HF | 824.6 g | 500–640 g | 至少 700 g | 约 ¥65/kg | ¥33–42 |
| TPU 95A/HF | 10.3 g | 12–15 g（含 brim/损耗） | 至少 20 g | 约 ¥118–300/kg | ¥2–5 |

PETG 的实心体积为 659.67 cm³，TPU 为 8.54 cm³。当前 3MF 只含排盘几何，未带
Bambu Studio 切片统计；500–640 g 是依据托盘/底座 30% gyroid、侧框/滑架 55%
gyroid、5–6 圈墙和 6 层顶底推算的区间，不是切片器精确值。

如果从零购买耗材：PETG-HF 买 1 kg 即可；TPU 实际只用十几克，但没有余料时仍需
买一整卷。按品牌和活动价，首次购料约 ¥183–365；若已有 TPU，购料约 ¥65。

## 外购五金

| 类别 | 型号/规格 | 数量 | 预算单价 | 小计 |
|---|---|---:|---:|---:|
| 恒力弹簧 | MISUMI CFS0.2 | 2 | ¥102 | ¥204 |
| 导向轴承 | 604ZZ，4×12×4 | 8 | ¥3–8 | ¥24–64 |
| 交叉轴承 | MR84ZZ，4×8×3 | 4 | ¥4–10 | ¥16–40 |
| 精密肩轴 | STR402M4X20HUL | 4 | 需进口询价；暂按 ¥50–100 | ¥200–400 |
| 精密肩轴 | STR402M4X16HUL | 4 | 需进口询价；暂按 ¥50–100 | ¥200–400 |
| 精密肩轴 | STR402M4X12HUL | 4 | 需进口询价；暂按 ¥50–100 | ¥200–400 |
| 平垫片 | M3，3.2×7×0.5 | 12 | 按小包装 | ¥5–10 |
| 螺母 | DIN 934 M3 | 12 | 按小包装 | ¥5–10 |
| 恒力弹簧固定 | M3×8 + M3 热熔螺母 | 各 2 | 按小包装 | ¥10–20 |
| 结构热熔螺母 | M4，OD 6.2×5.2 | 12 | 按小包装 | ¥12–25 |
| 底座螺钉 | M4×8 | 4 | 按小包装 | ¥5–10 |
| 键盘托螺钉 | M4×10 | 4 | 按小包装 | ¥5–10 |
| 妙控板托螺钉 | M4×16 | 4 | 按小包装 | ¥5–10 |
| 限位导杆 | 不锈钢 Ø3×122 | 2 | ¥10–20 | ¥20–40 |
| 防松 | 中强度可拆螺纹锁固剂 | 1 小瓶 | ¥15–30 | ¥15–30 |

五金预算：

- 严格采用指定 AMPG 精密肩轴：约 **¥926–1,673**。
- 若找到经尺寸和同轴度验证的国产等效肩轴，肩轴预算可降至约 ¥120–240，五金总价
  约 **¥446–713**；替代前必须复核 Ø4 光肩、三种肩长、M3×0.5×4 螺纹和超低头尺寸。

## 总预算

| 场景 | 材料消耗 + 五金 | 从零购买整卷耗材 + 五金 |
|---|---:|---:|
| 指定 AMPG 肩轴 | 约 ¥961–1,720 | 约 ¥1,109–2,038 |
| 经验证的国产等效肩轴 | 约 ¥481–760 | 约 ¥629–1,078 |

成本最高的不是打印塑料，而是 12 支进口精密肩轴和两只恒力弹簧。首件阶段建议先只
采购一套轴承、两只 CFS0.2 和国产样件肩轴做装配验证；肩轴不合格再切换 AMPG。

## 价格依据

- MISUMI 中国恒力弹簧目录：CFS0.2，1–4 个单价 ¥102。
- Bambu Lab 中国官方 TPU 95A HF 页面确认材料型号与打印要求；中国商城价格动态显示。
- 2025–2026 行业公开报价中，Bambu PETG-HF 约 ¥65/kg；第三方 TPU 95A 公开采购价约
  ¥118/kg。品牌 TPU 95A HF 可更高，因此购买预算采用 ¥118–300/kg。
- AMPG 当前公开目录确认三个肩轴型号和尺寸，但未公开中国成交价，表内为进口预算，
  最终应以供应商报价为准。
