clChenLiang/keyboard-trackpad-cross-axis-redesign/outputs/cross-axis-slider-v11-standard-hardware/roller_detail_assembled.step

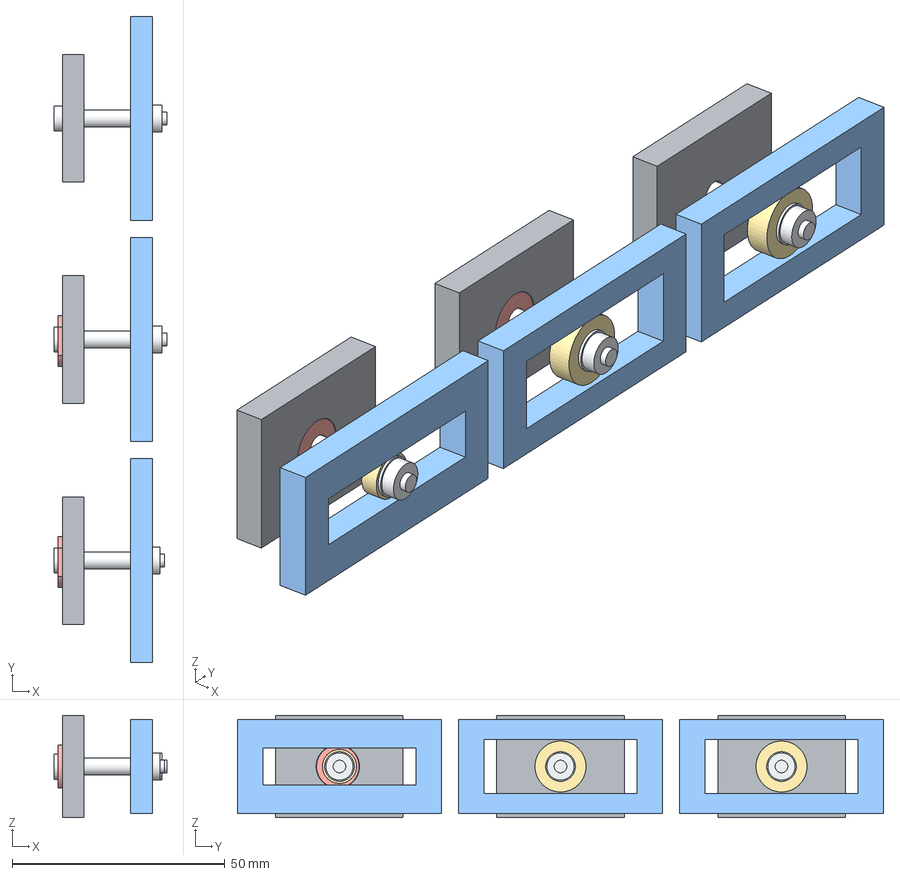
[picture p31: CAD file, 2026-07-18]
outputs/cross-axis-slider-v11-standard-hardware/roller_detail_assembled.step
26.5 x 152.0 x 24.0 mm
guide_fixed_carriage_coupon
guide_fixed_slot_coupon
guide_fixed_shaft
guide_fixed_bearing
guide_fixed_retaining_washer
guide_fixed_retaining_nut
guide_eccentric_carriage_coupon
guide_eccentric_slot_coupon
guide_eccentric_shaft
guide_eccentric_bearing
guide_eccentric_retaining_washer
guide_eccentric_retaining_nut
guide_eccentric_eccentric_bushing
cross_eccentric_carriage_coupon
cross_eccentric_slot_coupon
cross_eccentric_shaft
cross_eccentric_bearing
cross_eccentric_retaining_washer
cross_eccentric_retaining_nut
cross_eccentric_eccentric_bushing
