clChenLiang/keyboard-trackpad-cross-axis-redesign/outputs/cross-axis-slider-v12-usability-audit/roller_detail_assembled.step

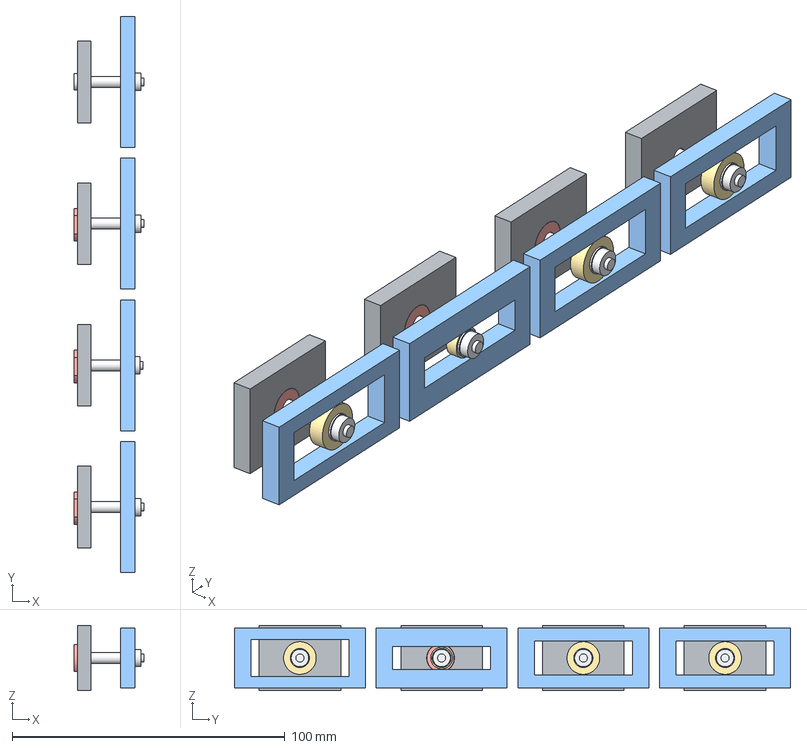
[picture p32: CAD file, 2026-07-18]
outputs/cross-axis-slider-v12-usability-audit/roller_detail_assembled.step
25.8 x 204.0 x 24.0 mm
guide_fixed_carriage_coupon
guide_fixed_slot_coupon
guide_fixed_shaft
guide_fixed_bearing
guide_fixed_retaining_washer
guide_fixed_retaining_nut
guide_eccentric_carriage_coupon
guide_eccentric_slot_coupon
guide_eccentric_shaft
guide_eccentric_bearing
guide_eccentric_retaining_washer
guide_eccentric_retaining_nut
guide_eccentric_eccentric_bushing
cross_eccentric_carriage_coupon
cross_eccentric_slot_coupon
cross_eccentric_shaft
cross_eccentric_bearing
cross_eccentric_retaining_washer
cross_eccentric_retaining_nut
cross_eccentric_eccentric_bushing
right_follower_carriage_coupon
right_follower_slot_coupon
right_follower_shaft
right_follower_bearing
right_follower_retaining_washer
right_follower_retaining_nut
right_follower_eccentric_bushing
