clChenLiang/keyboard-trackpad-cross-axis-redesign/outputs/cross-axis-slider-v10-printable-preloaded/printables/carriages_plate.step

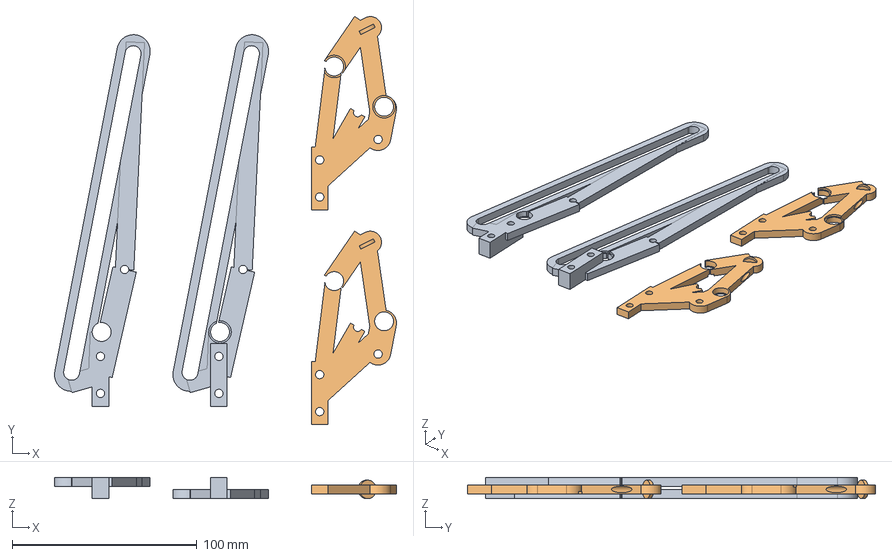
[picture p37: CAD file, 2026-07-18]
outputs/cross-axis-slider-v10-printable-preloaded/printables/carriages_plate.step
184.9 x 220.6 x 11.5 mm
trackpad_carriage_left
trackpad_carriage_right
keyboard_carriage_left
keyboard_carriage_right
