clChenLiang/keyboard-trackpad-cross-axis-redesign/outputs/cross-axis-slider-v12-usability-audit/printables/side_frame_left.step

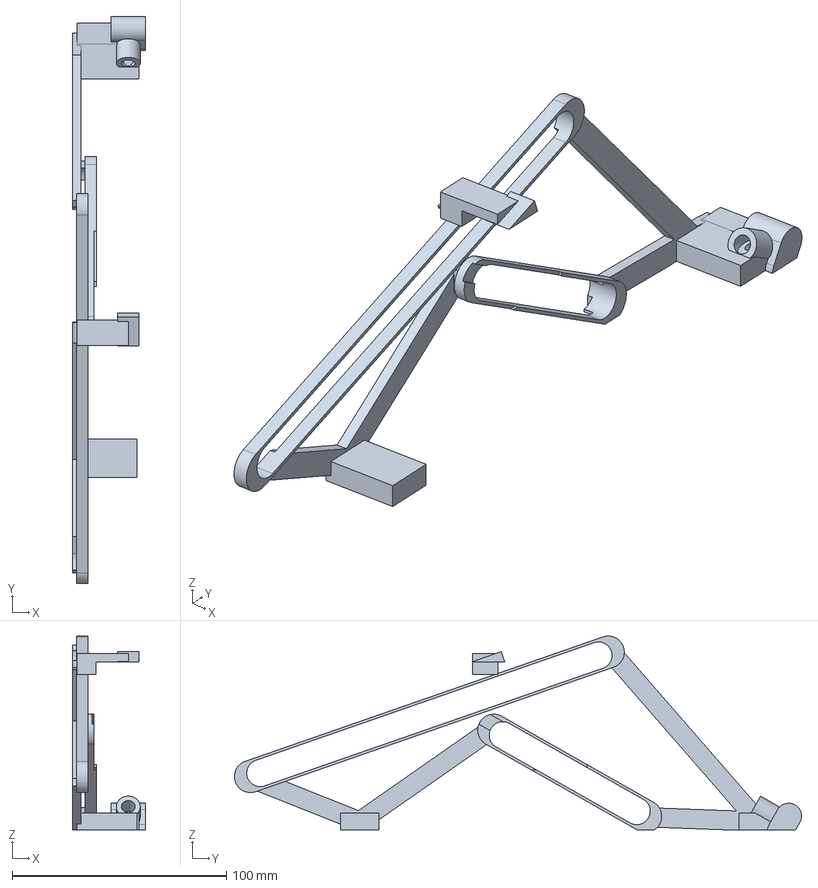
[picture p40: CAD file, 2026-07-18]
outputs/cross-axis-slider-v12-usability-audit/printables/side_frame_left.step
34.0 x 264.7 x 90.5 mm
