clChenLiang/keyboard-trackpad-cross-axis-redesign/outputs/rack-pinion-swing-tray-concept-v1/trackpad_mode.step

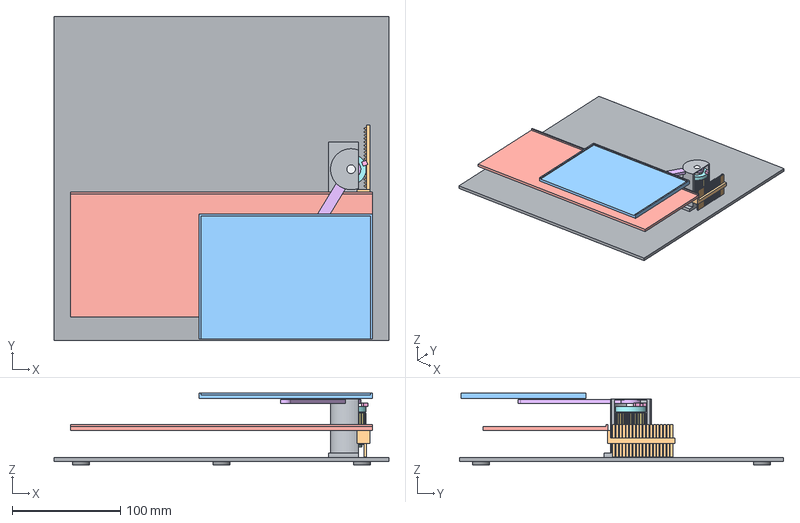
[picture p41: CAD file, 2026-07-18]
outputs/rack-pinion-swing-tray-concept-v1/trackpad_mode.step
310.0 x 300.0 x 66.6 mm
fixed_protective_cylinder
lower_axial_thrust_interface
lower_radial_bearing_seat
module_1_26t_pinion
upper_radial_bearing_seat
eccentric_horizontal_swing_arm
keyboard_tray_continuous
keyboard_right_straight_rack
magic_trackpad_small_tray
