clChenLiang/keyboard-trackpad-cross-axis-redesign/outputs/rack-pinion-swing-tray-concept-v2-supported/mid_mode.step

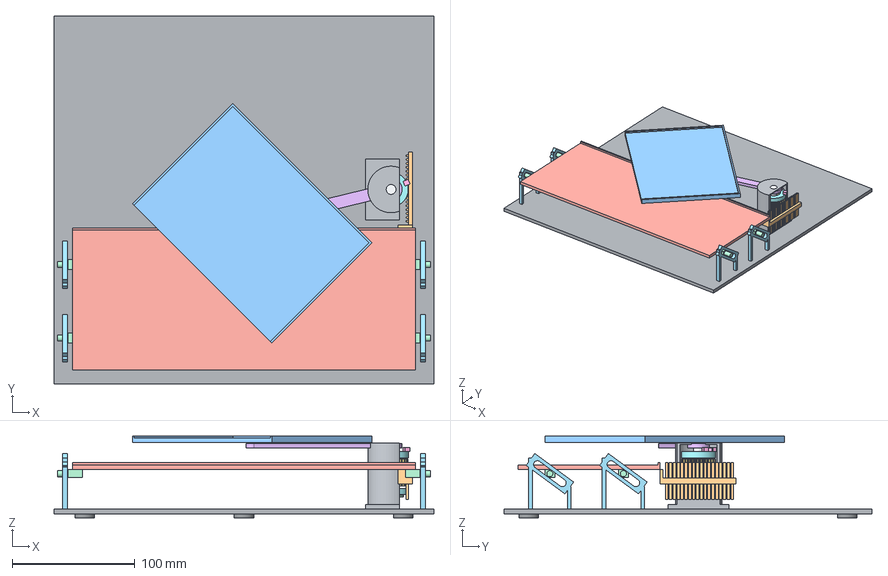
[picture p42: CAD file, 2026-07-18]
outputs/rack-pinion-swing-tray-concept-v2-supported/mid_mode.step
310.0 x 300.0 x 66.6 mm
fixed_protective_cylinder
lower_axial_thrust_interface
lower_radial_bearing_seat
module_1_26t_pinion
upper_radial_bearing_seat
eccentric_horizontal_swing_arm
keyboard_tray_continuous
keyboard_right_straight_rack
magic_trackpad_small_tray
fixed_keyboard_guide_left_front
fixed_keyboard_guide_right_front
fixed_keyboard_guide_left_rear
fixed_keyboard_guide_right_rear
keyboard_carriage_left_front
keyboard_carriage_right_front
keyboard_carriage_left_rear
keyboard_carriage_right_rear
