clChenLiang/keyboard-trackpad-cross-axis-redesign/outputs/rack-pinion-swing-tray-main-v3-open-frame-base-v1/keyboard_mode.step

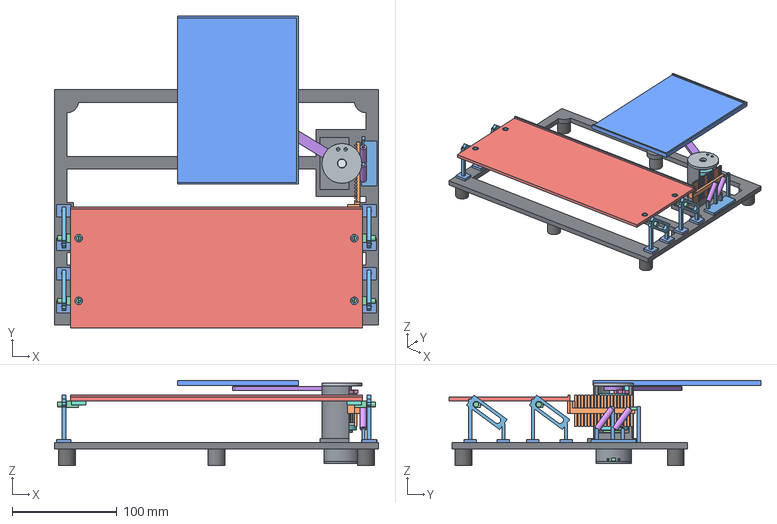
[picture p44: CAD file, 2026-07-18]
outputs/rack-pinion-swing-tray-main-v3-open-frame-base-v1/keyboard_mode.step
310.0 x 298.3 x 81.6 mm
module_1_26t_pinion
