clChenLiang/keyboard-trackpad-cross-axis-redesign/outputs/rack-pinion-swing-tray-main-v3-optional-torsion-return-module-v1/torsion_return_module.step

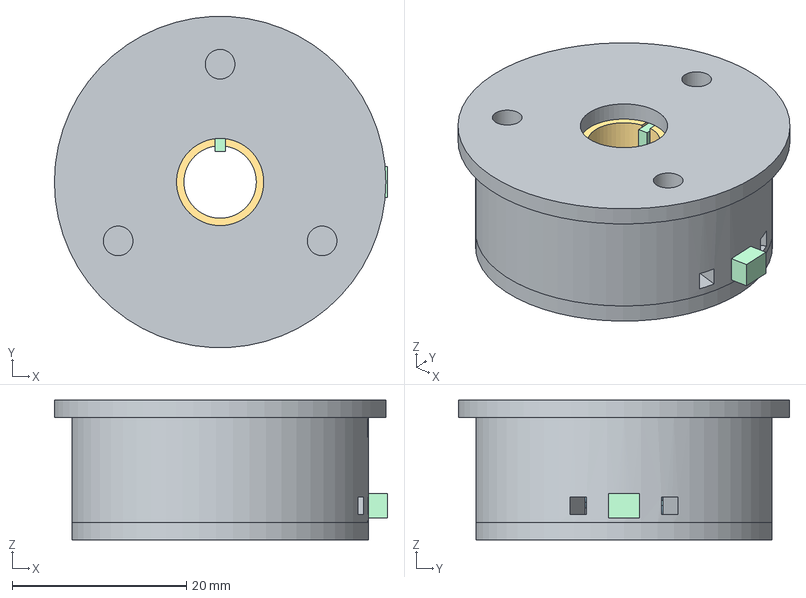
[picture p45: CAD file, 2026-07-18]
outputs/rack-pinion-swing-tray-main-v3-optional-torsion-return-module-v1/torsion_return_module.step
38.2 x 37.9 x 16.0 mm
torsion_fixed_mounting_cup
torsion_removable_bottom_cover
torsion_rotating_shaft_clamp
