clChenLiang/keyboard-trackpad-cross-axis-redesign/outputs/ap-flat-reel-floating-z-coupon-v1/stored_90deg.step

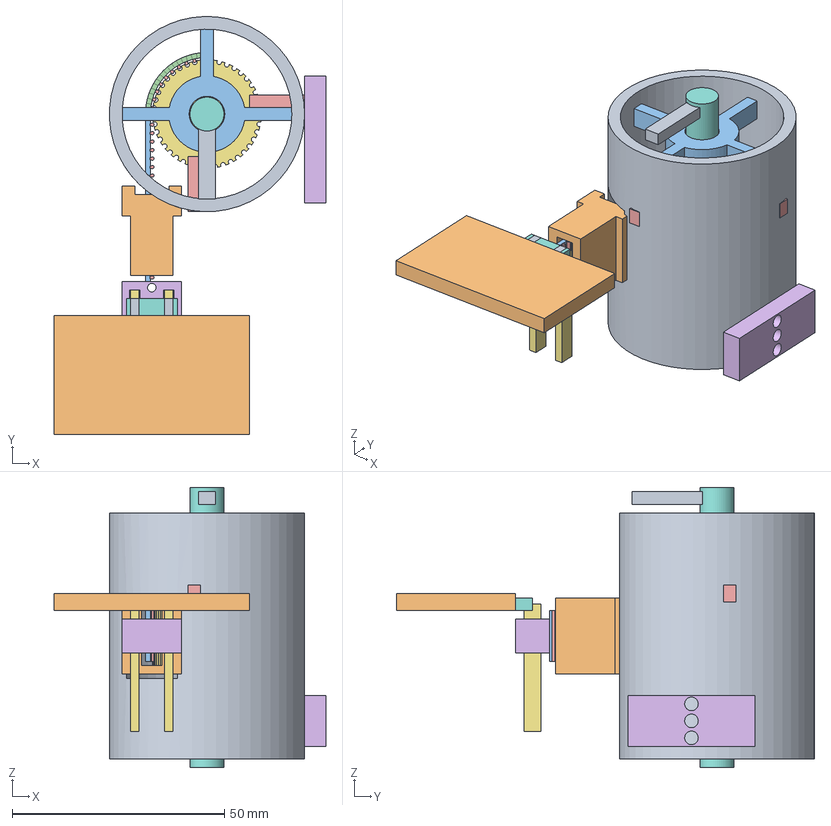
[picture p46: CAD file, 2026-07-18]
outputs/ap-flat-reel-floating-z-coupon-v1/stored_90deg.step
64.0 x 98.5 x 66.0 mm
protective_housing
closed_entry_guide
upper_bearing_seat
lower_bearing_seat
lower_thrust_interface
hard_stop_0deg
hard_stop_90deg
spring_anchor_interface_uncommitted
reel_drum_41T_pitch_dia_26p10
belt_end_clamp_slider
