clChenLiang/keyboard-trackpad-cross-axis-redesign/outputs/cross-axis-slider-v10-printable-preloaded/printables/keyboard_tray.step

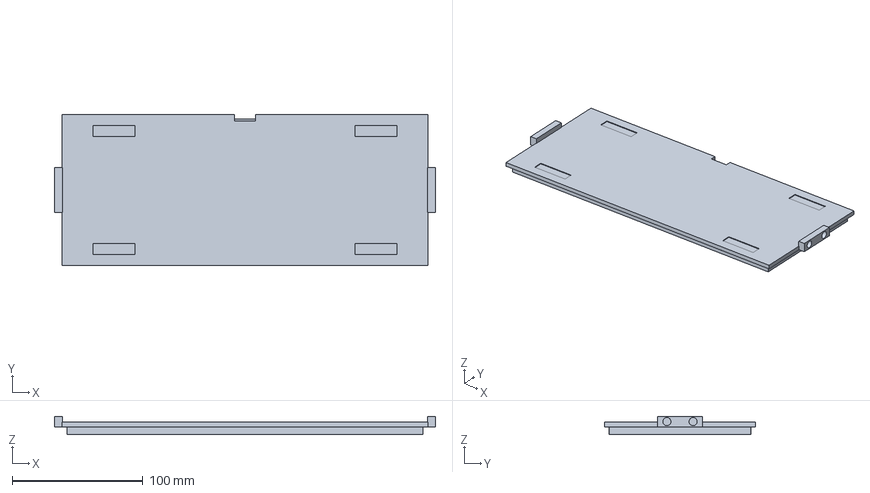
[picture p47: CAD file, 2026-07-18]
outputs/cross-axis-slider-v10-printable-preloaded/printables/keyboard_tray.step
291.0 x 115.7 x 14.0 mm
