clChenLiang/keyboard-trackpad-cross-axis-redesign/outputs/cross-axis-slider-v11-standard-hardware/mid_mode.step

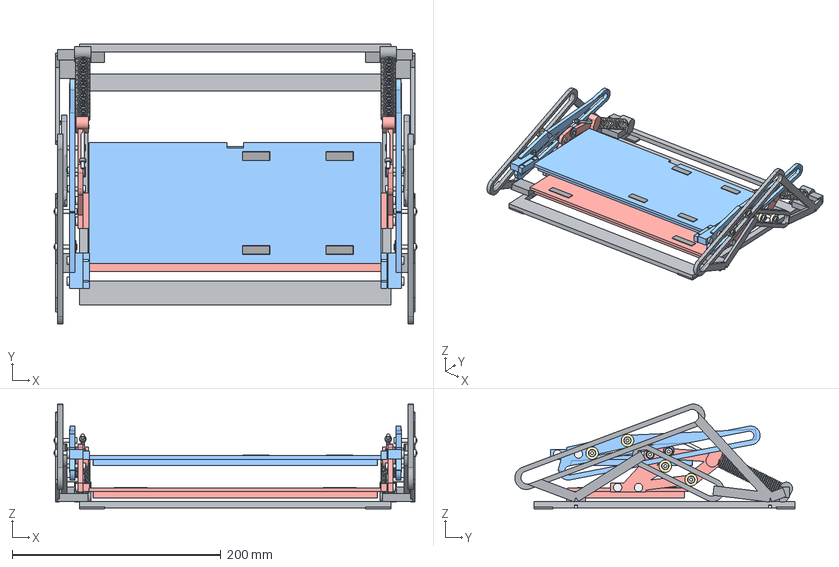
[picture p48: CAD file, 2026-07-18]
outputs/cross-axis-slider-v11-standard-hardware/mid_mode.step
347.6 x 268.5 x 100.4 mm
base
keyboard_tray
trackpad_tray
fixed_side_frame_left
fixed_base_insert_left_1
fixed_base_mount_screw_left_1
fixed_base_insert_left_2
fixed_base_mount_screw_left_2
keyboard_carriage_left
trackpad_carriage_left
keyboard_guide_bearing_left_1
keyboard_guide_shaft_left_1
keyboard_guide_retaining_washer_left_1
keyboard_guide_retaining_nut_left_1
keyboard_guide_bearing_left_2
keyboard_guide_shaft_left_2
keyboard_guide_retaining_washer_left_2
keyboard_guide_retaining_nut_left_2
keyboard_guide_eccentric_bushing_left
trackpad_guide_bearing_left_1
trackpad_guide_shaft_left_1
trackpad_guide_retaining_washer_left_1
trackpad_guide_retaining_nut_left_1
trackpad_guide_bearing_left_2
trackpad_guide_shaft_left_2
trackpad_guide_retaining_washer_left_2
trackpad_guide_retaining_nut_left_2
trackpad_guide_eccentric_bushing_left
cross_bearing_left_1
cross_shaft_left_1
cross_retaining_washer_left_1
cross_retaining_nut_left_1
cross_bearing_left_2
cross_shaft_left_2
cross_retaining_washer_left_2
cross_retaining_nut_left_2
cross_eccentric_bushing_left
fixed_stop_collar_left_return
fixed_stop_collar_left_pressed
keyboard_tray_insert_left_1
keyboard_tray_mount_screw_left_1
keyboard_tray_insert_left_2
keyboard_tray_mount_screw_left_2
trackpad_tray_insert_left_1
trackpad_tray_mount_screw_left_1
trackpad_tray_insert_left_2
trackpad_tray_mount_screw_left_2
fixed_side_frame_right
fixed_base_insert_right_1
fixed_base_mount_screw_right_1
fixed_base_insert_right_2
fixed_base_mount_screw_right_2
keyboard_carriage_right
trackpad_carriage_right
keyboard_guide_bearing_right_1
keyboard_guide_shaft_right_1
keyboard_guide_retaining_washer_right_1
keyboard_guide_retaining_nut_right_1
keyboard_guide_bearing_right_2
keyboard_guide_shaft_right_2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
