clChenLiang/keyboard-trackpad-cross-axis-redesign/outputs/cross-axis-slider-v11-standard-hardware/printables/frames_plate.step

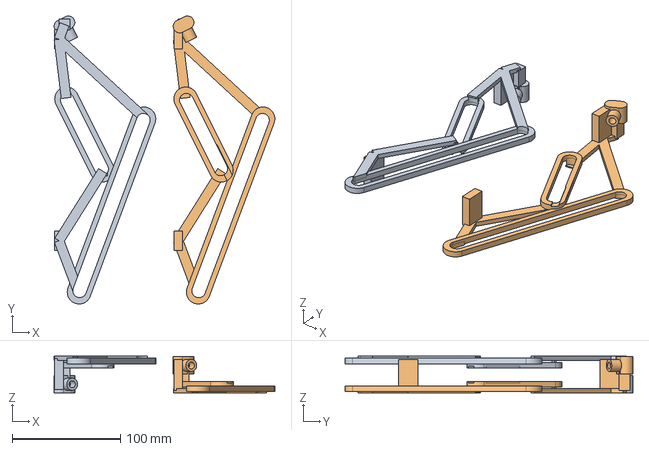
[picture p49: CAD file, 2026-07-18]
outputs/cross-axis-slider-v11-standard-hardware/printables/frames_plate.step
203.9 x 266.0 x 34.0 mm
side_frame_left
side_frame_right
