clChenLiang/keyboard-trackpad-cross-axis-redesign/outputs/cross-axis-slider-v12-usability-audit/printables/petg_small_parts_plate.step

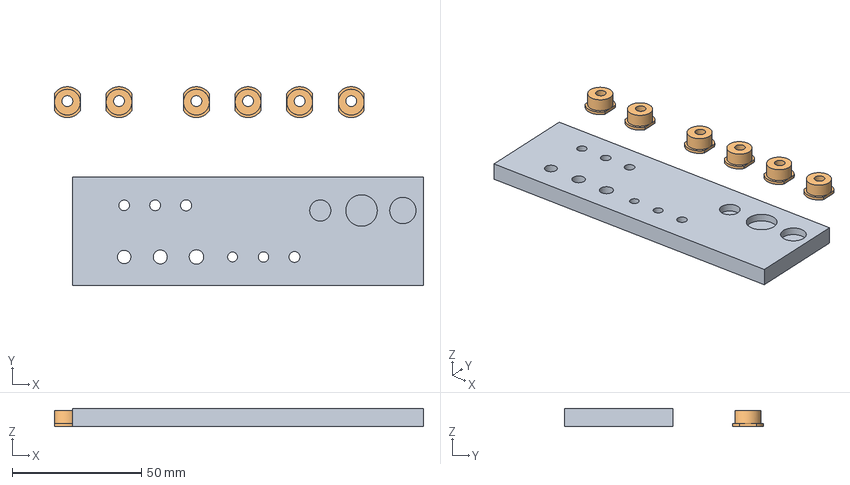
[picture p50: CAD file, 2026-07-18]
outputs/cross-axis-slider-v12-usability-audit/printables/petg_small_parts_plate.step
143.0 x 77.0 x 7.00 mm
calibration_coupon
cross_eccentric_bushing_1
cross_eccentric_bushing_2
guide_eccentric_bushing_1
guide_eccentric_bushing_2
guide_eccentric_bushing_3
guide_eccentric_bushing_4
