clChenLiang/keyboard-trackpad-cross-axis-redesign/outputs/rack-pinion-swing-tray-main-v3-open-frame-base-v1/trackpad_mode.step

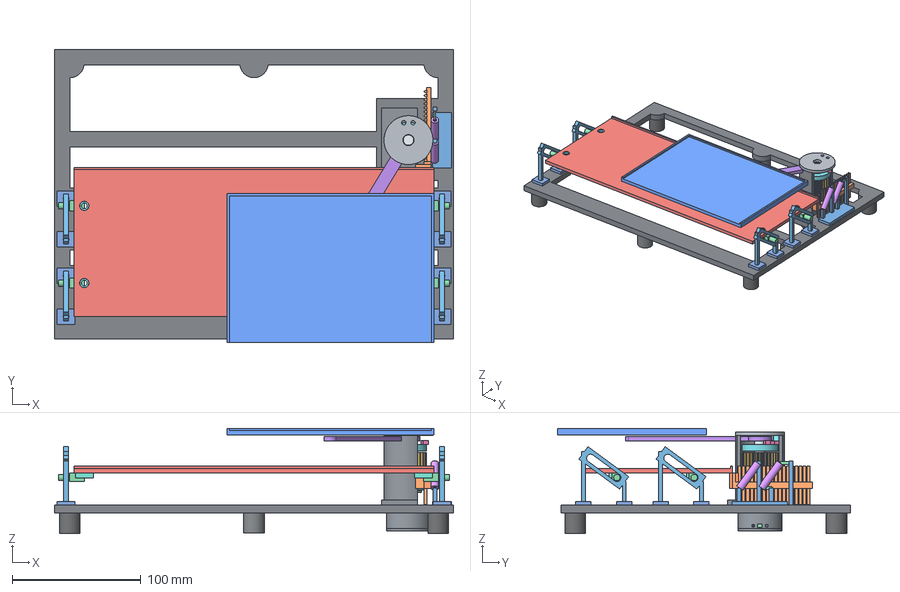
[picture p51: CAD file, 2026-07-18]
outputs/rack-pinion-swing-tray-main-v3-open-frame-base-v1/trackpad_mode.step
310.0 x 227.8 x 81.6 mm
module_1_26t_pinion
