clChenLiang/keyboard-trackpad-cross-axis-redesign/outputs/rack-pinion-swing-tray-main-v3-optional-torsion-return-module-v1/torsion_return_exploded.step

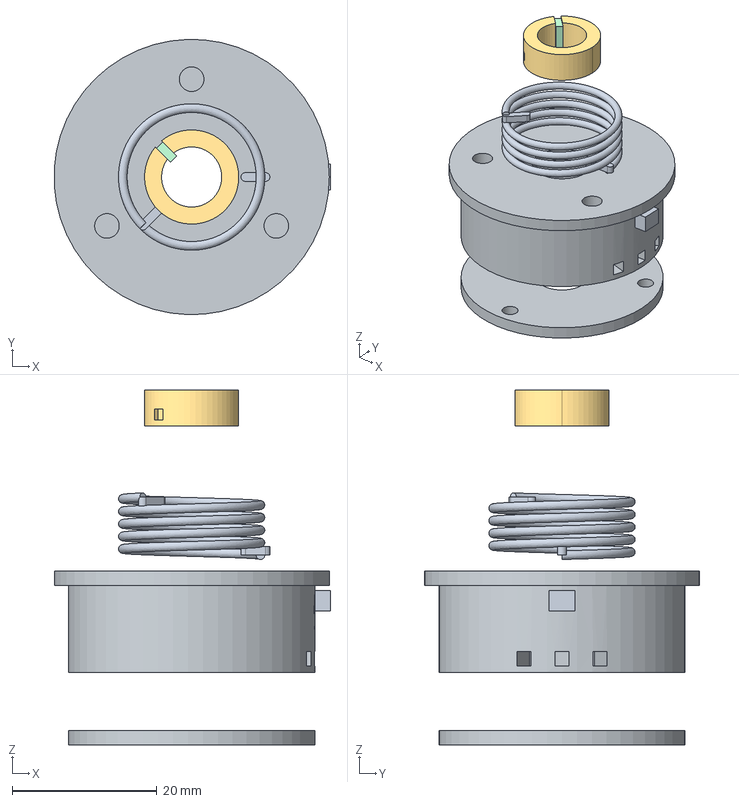
[picture p52: CAD file, 2026-07-18]
outputs/rack-pinion-swing-tray-main-v3-optional-torsion-return-module-v1/torsion_return_exploded.step
38.2 x 38.0 x 49.0 mm
torsion_fixed_mounting_cup
torsion_removable_bottom_cover_exploded
torsion_rotating_shaft_clamp_exploded
