clChenLiang/keyboard-trackpad-cross-axis-redesign/outputs/rack-pinion-swing-tray-main-v4-low-profile-reel-cartridge-v1/trackpad_mode.step

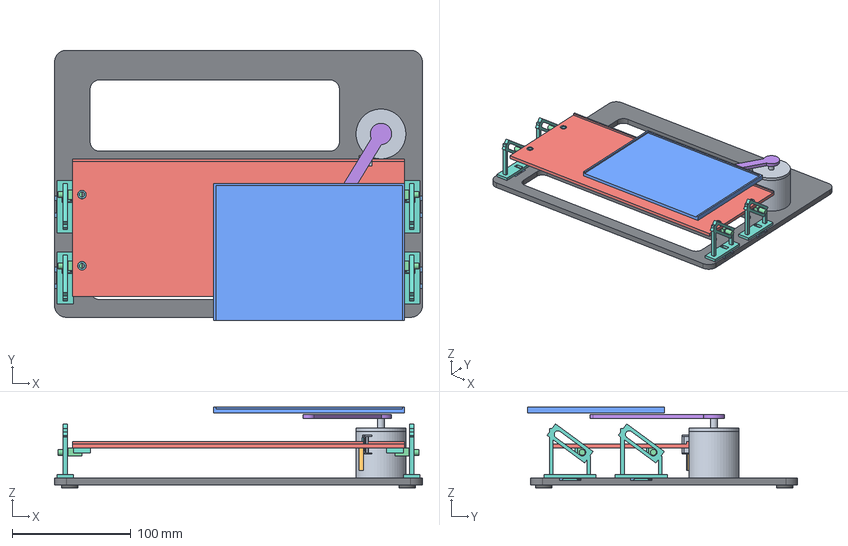
[picture p53: CAD file, 2026-07-20]
outputs/rack-pinion-swing-tray-main-v4-low-profile-reel-cartridge-v1/trackpad_mode.step
310.0 x 227.8 x 68.1 mm
above_base_return_spring
