clChenLiang/keyboard-trackpad-cross-axis-redesign/outputs/cross-axis-slider-v10-printable-preloaded/printables/trackpad_carriage_left.step

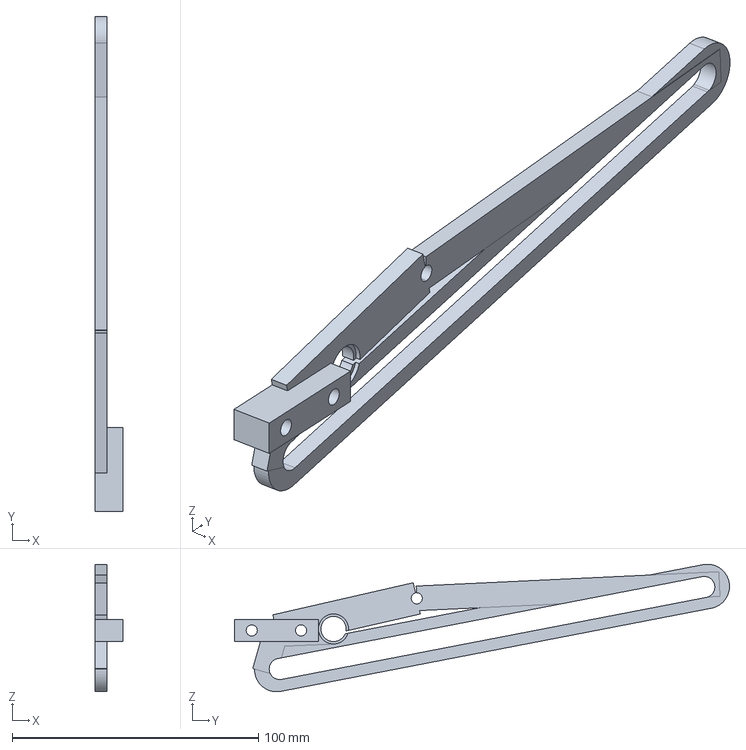
[picture p56: CAD file, 2026-07-18]
outputs/cross-axis-slider-v10-printable-preloaded/printables/trackpad_carriage_left.step
11.5 x 200.9 x 51.7 mm
