clChenLiang/keyboard-trackpad-cross-axis-redesign/outputs/cross-axis-slider-v11-standard-hardware/printables/calibration_coupon.step

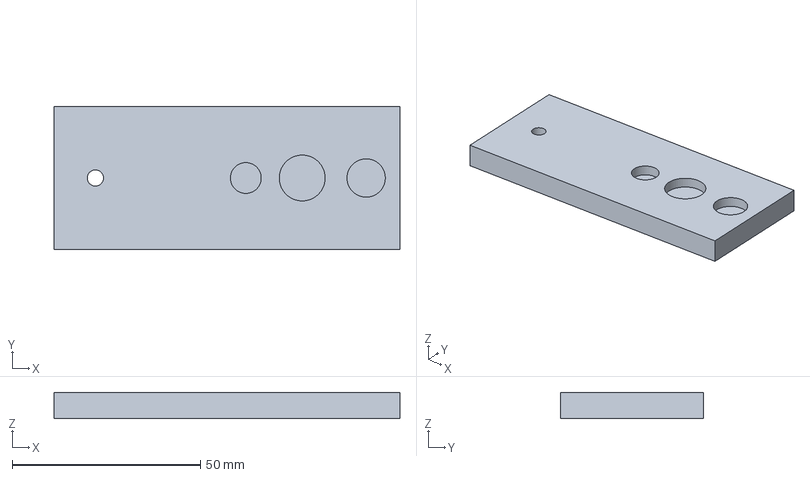
[picture p57: CAD file, 2026-07-18]
outputs/cross-axis-slider-v11-standard-hardware/printables/calibration_coupon.step
92.0 x 38.0 x 7.00 mm
