clChenLiang/keyboard-trackpad-cross-axis-redesign/outputs/cross-axis-slider-v12-usability-audit/printables/trackpad_carriage_left.step

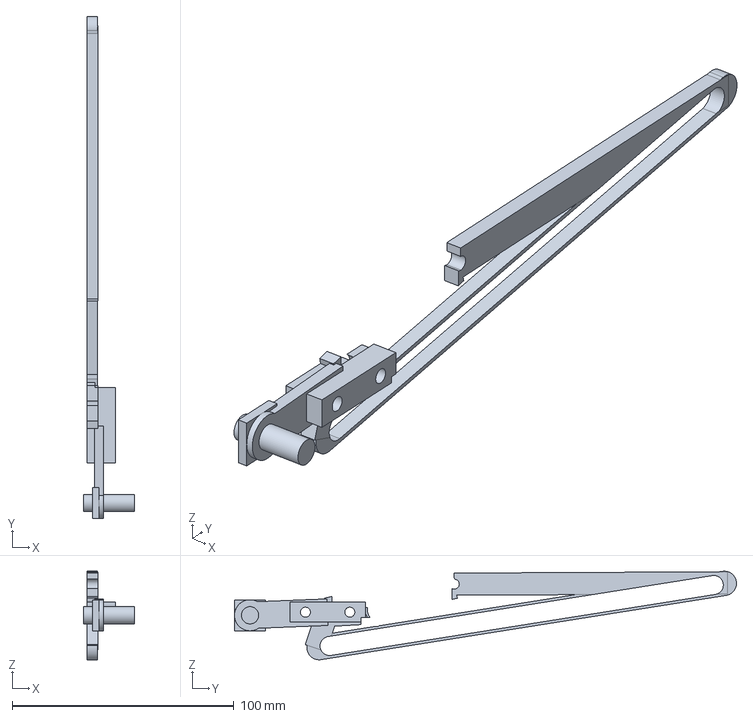
[picture p59: CAD file, 2026-07-18]
outputs/cross-axis-slider-v12-usability-audit/printables/trackpad_carriage_left.step
23.0 x 226.4 x 40.0 mm
