clChenLiang/keyboard-trackpad-cross-axis-redesign/outputs/rack-pinion-swing-tray-concept-v1/cylinder_section_exploded.step

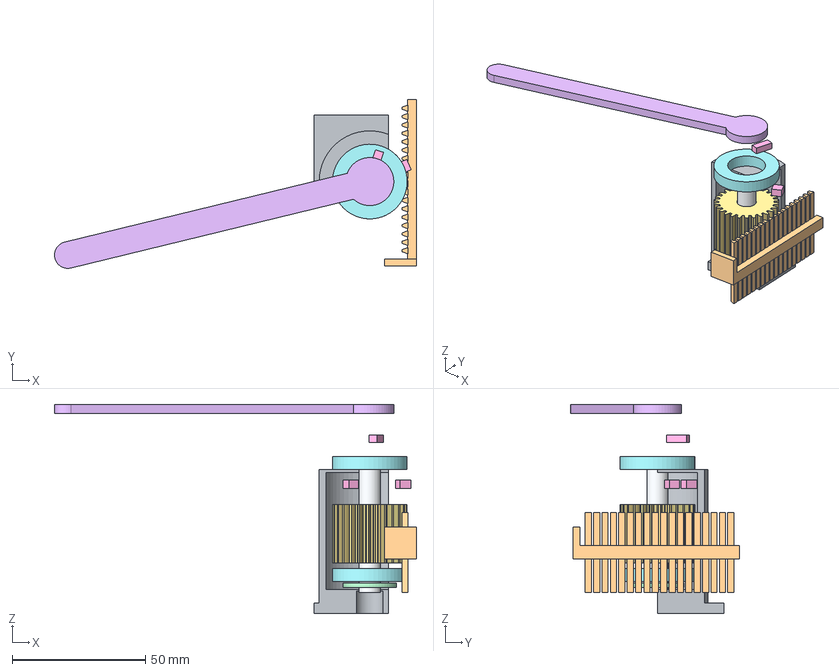
[picture p60: CAD file, 2026-07-18]
outputs/rack-pinion-swing-tray-concept-v1/cylinder_section_exploded.step
135.7 x 63.3 x 78.5 mm
fixed_protective_cylinder
keyboard_right_straight_rack
lower_axial_thrust_interface
lower_radial_bearing_seat
module_1_26t_pinion
upper_radial_bearing_seat_exploded
eccentric_horizontal_swing_arm
