clChenLiang/keyboard-trackpad-cross-axis-redesign/outputs/rack-pinion-swing-tray-main-v3-integrated-return-v1/cylinder_return_section_exploded.step

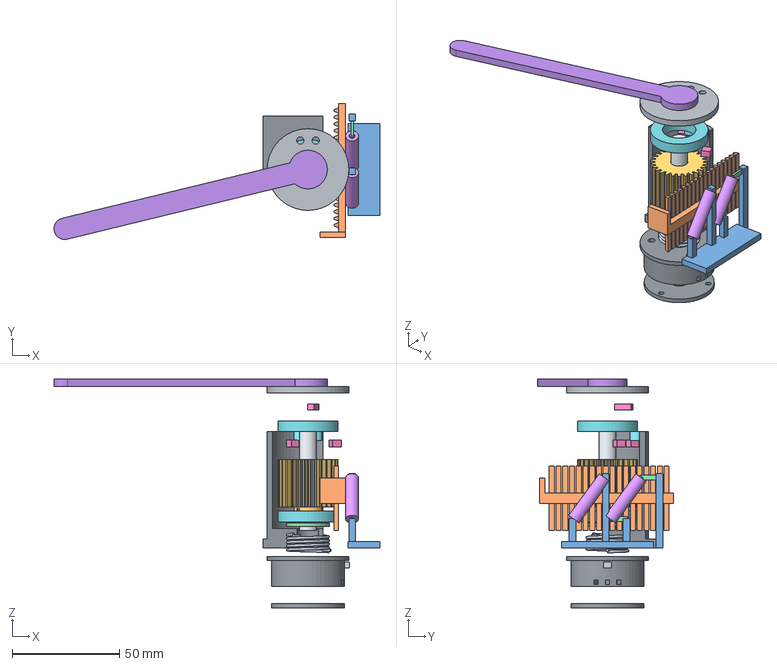
[picture p61: CAD file, 2026-07-18]
outputs/rack-pinion-swing-tray-main-v3-integrated-return-v1/cylinder_return_section_exploded.step
151.7 x 63.3 x 106.5 mm
module_1_26t_pinion
