clChenLiang/keyboard-trackpad-cross-axis-redesign/outputs/rack-pinion-swing-tray-main-v4-low-profile-reel-cartridge-v1/mid_mode.step

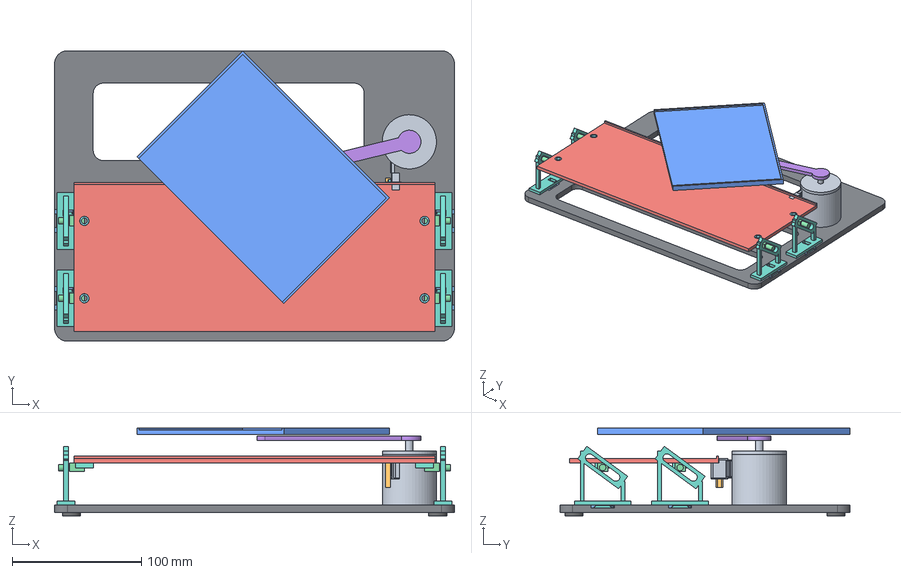
[picture p63: CAD file, 2026-07-20]
outputs/rack-pinion-swing-tray-main-v4-low-profile-reel-cartridge-v1/mid_mode.step
310.0 x 225.0 x 68.1 mm
above_base_return_spring
