clChenLiang/keyboard-trackpad-cross-axis-redesign/outputs/ap-flat-reel-floating-z-coupon-v1/cylinder_section_exploded.step

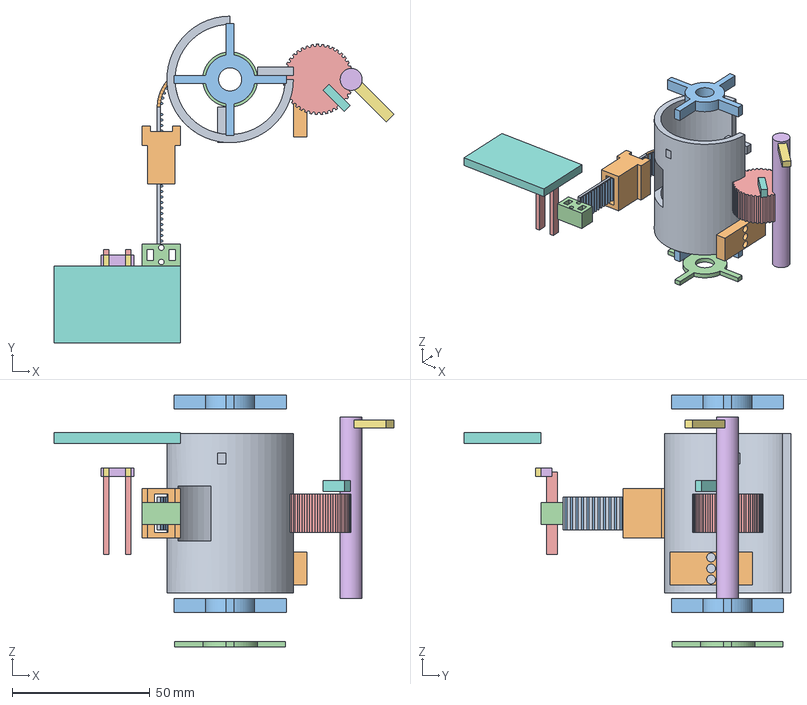
[picture p64: CAD file, 2026-07-18]
outputs/ap-flat-reel-floating-z-coupon-v1/cylinder_section_exploded.step
123.6 x 118.8 x 91.5 mm
protective_housing_section
closed_entry_guide_exploded
upper_bearing_seat_exploded
lower_bearing_seat_exploded
lower_thrust_interface_exploded
reel_drum_pitch_dia_26_exploded
belt_end_clamp_slider_exploded
spring_anchor_interface_uncommitted
