clChenLiang/keyboard-trackpad-cross-axis-redesign/outputs/cross-axis-slider-v10-printable-preloaded/printables/trackpad_tpu_pad.step

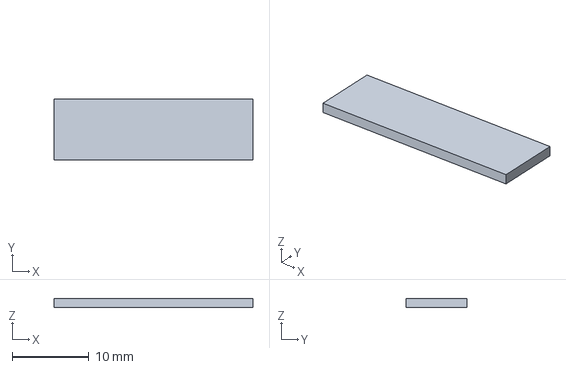
[picture p65: CAD file, 2026-07-18]
outputs/cross-axis-slider-v10-printable-preloaded/printables/trackpad_tpu_pad.step
26.0 x 8.00 x 1.20 mm
