clChenLiang/keyboard-trackpad-cross-axis-redesign/outputs/cross-axis-slider-v11-standard-hardware/printables/trackpad_carriage_right.step

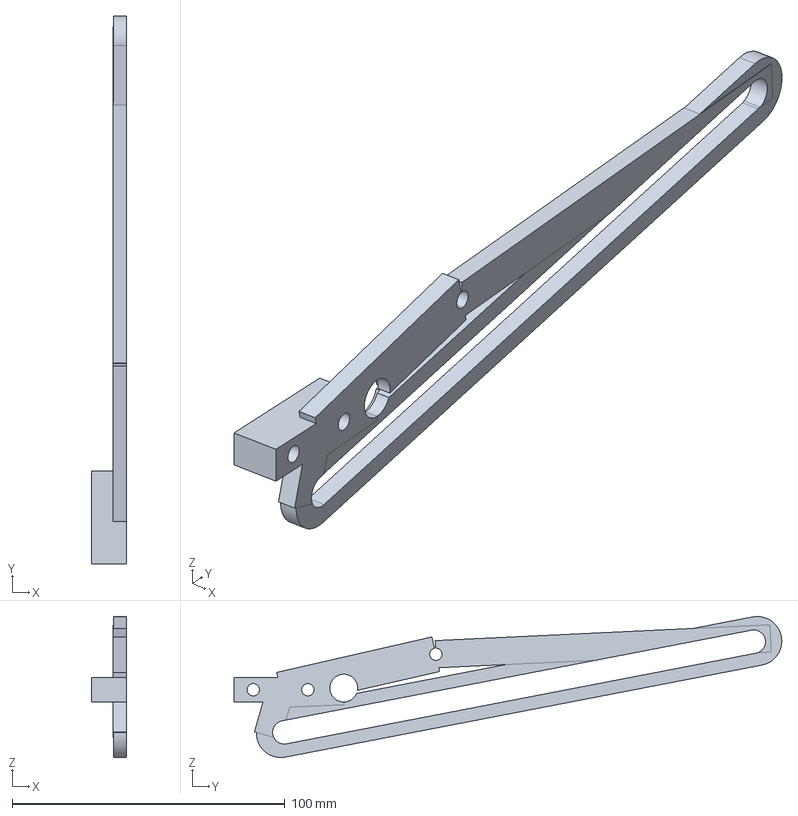
[picture p66: CAD file, 2026-07-18]
outputs/cross-axis-slider-v11-standard-hardware/printables/trackpad_carriage_right.step
13.0 x 200.9 x 51.7 mm
