clChenLiang/keyboard-trackpad-cross-axis-redesign/outputs/cross-axis-slider-v12-usability-audit/printables/base_plate.step

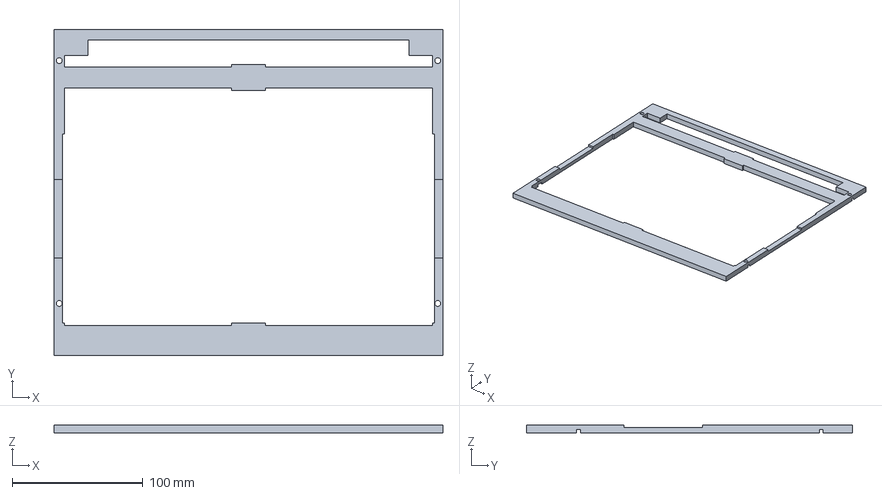
[picture p67: CAD file, 2026-07-18]
outputs/cross-axis-slider-v12-usability-audit/printables/base_plate.step
298.0 x 250.0 x 6.00 mm
