clChenLiang/keyboard-trackpad-cross-axis-redesign/outputs/rack-pinion-swing-tray-main-v3-open-frame-base-v1/base_and_return_interface.step

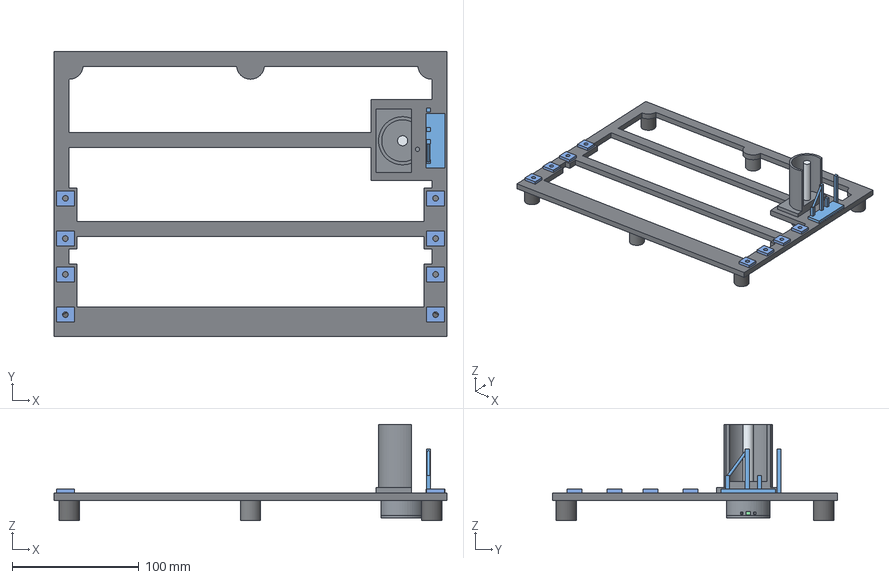
[picture p69: CAD file, 2026-07-18]
outputs/rack-pinion-swing-tray-main-v3-open-frame-base-v1/base_and_return_interface.step
310.0 x 225.0 x 76.0 mm
