clChenLiang/keyboard-trackpad-cross-axis-redesign/outputs/rack-pinion-swing-tray-main-v4-low-profile-reel-cartridge-v1/keyboard_mode.step

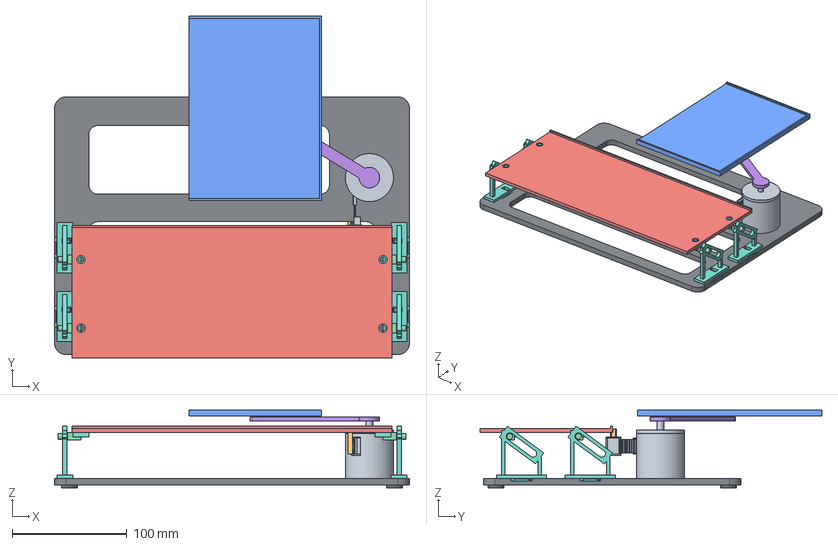
[picture p71: CAD file, 2026-07-20]
outputs/rack-pinion-swing-tray-main-v4-low-profile-reel-cartridge-v1/keyboard_mode.step
310.0 x 298.3 x 68.1 mm
above_base_return_spring
