clChenLiang/keyboard-trackpad-cross-axis-redesign/outputs/cross-axis-slider-v10-printable-preloaded/printables/base.step

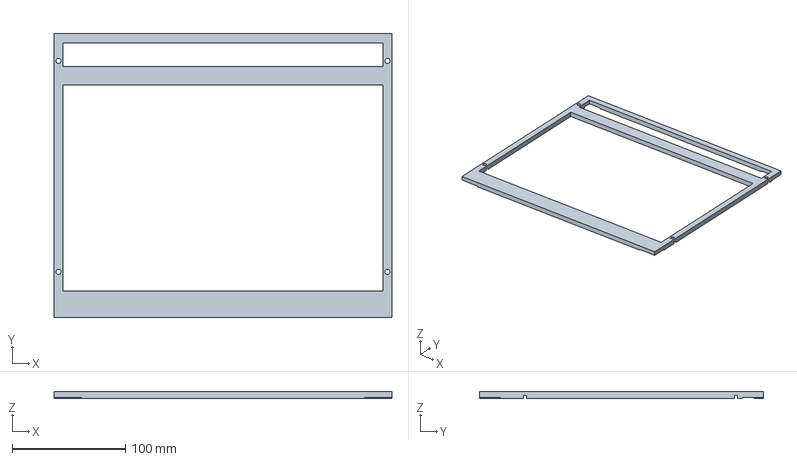
[picture p72: CAD file, 2026-07-18]
outputs/cross-axis-slider-v10-printable-preloaded/printables/base.step
298.0 x 250.0 x 6.00 mm
