clChenLiang/keyboard-trackpad-cross-axis-redesign/outputs/cross-axis-slider-v11-standard-hardware/printables/keyboard_tpu_pad.step

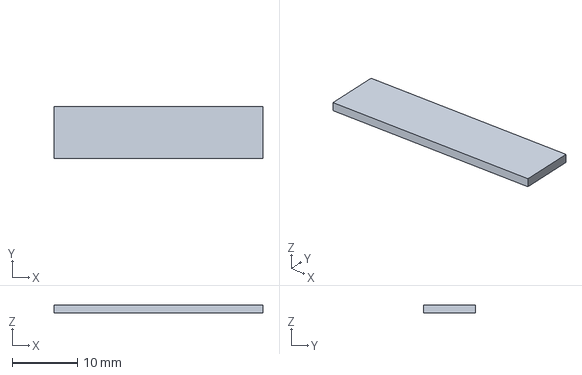
[picture p73: CAD file, 2026-07-18]
outputs/cross-axis-slider-v11-standard-hardware/printables/keyboard_tpu_pad.step
32.0 x 8.00 x 1.20 mm
