clChenLiang/keyboard-trackpad-cross-axis-redesign/outputs/cross-axis-slider-v12-usability-audit/printables/keyboard_carriage_left.step

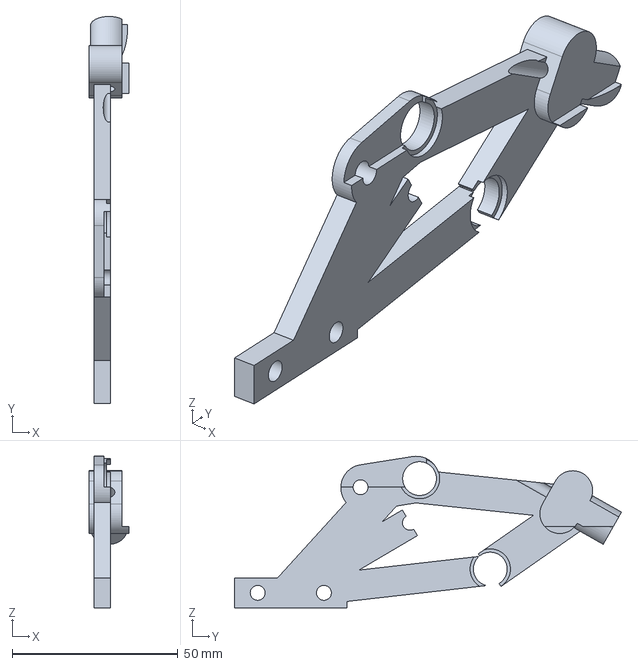
[picture p75: CAD file, 2026-07-18]
outputs/cross-axis-slider-v12-usability-audit/printables/keyboard_carriage_left.step
12.0 x 116.9 x 45.7 mm
