clChenLiang/keyboard-trackpad-cross-axis-redesign/outputs/rack-pinion-swing-tray-main-v4-low-profile-reel-cartridge-v1/reel_cartridge_section_exploded.step

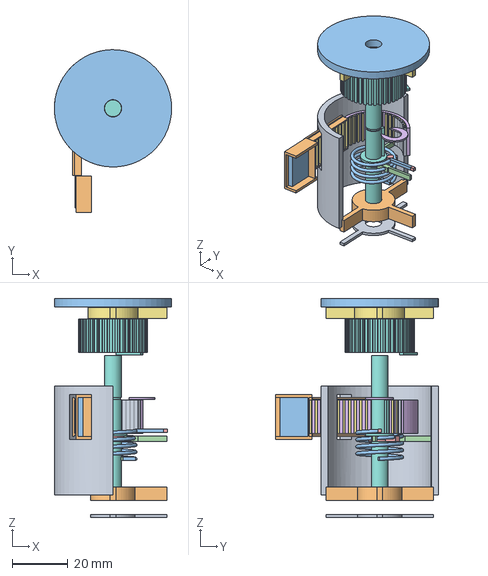
[picture p76: CAD file, 2026-07-20]
outputs/rack-pinion-swing-tray-main-v4-low-profile-reel-cartridge-v1/reel_cartridge_section_exploded.step
42.0 x 58.2 x 78.4 mm
above_base_return_spring
