clChenLiang/keyboard-trackpad-cross-axis-redesign/outputs/cross-axis-slider-v10-printable-preloaded/printables/tpu_stop_collar.step

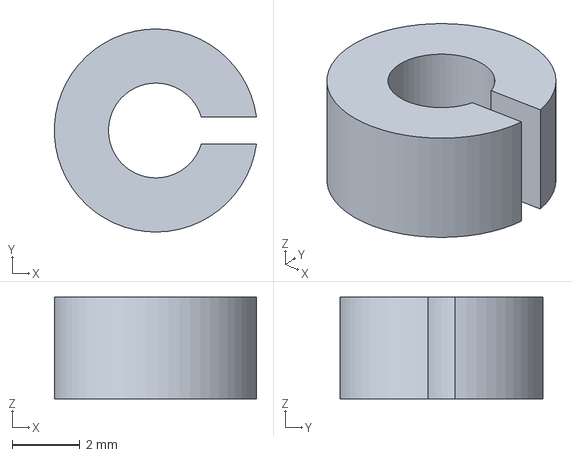
[picture p77: CAD file, 2026-07-18]
outputs/cross-axis-slider-v10-printable-preloaded/printables/tpu_stop_collar.step
5.97 x 6.00 x 3.00 mm
