clChenLiang/keyboard-trackpad-cross-axis-redesign/outputs/cross-axis-slider-v11-standard-hardware/printables/trays_plate.step

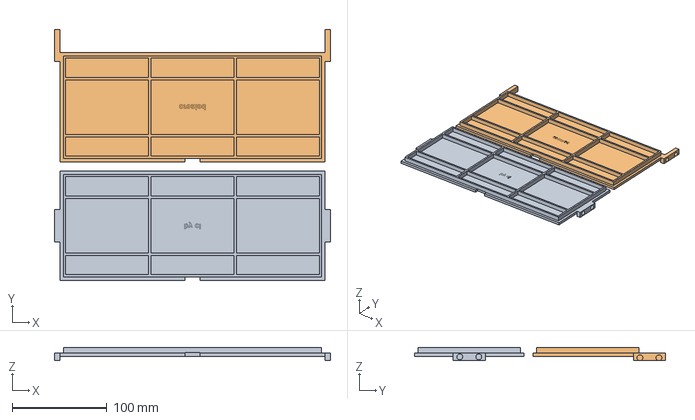
[picture p78: CAD file, 2026-07-18]
outputs/cross-axis-slider-v11-standard-hardware/printables/trays_plate.step
291.0 x 264.8 x 14.0 mm
keyboard_tray
trackpad_tray
