clChenLiang/keyboard-trackpad-cross-axis-redesign/outputs/cross-axis-slider-v12-usability-audit/printables/carriages_plate.step

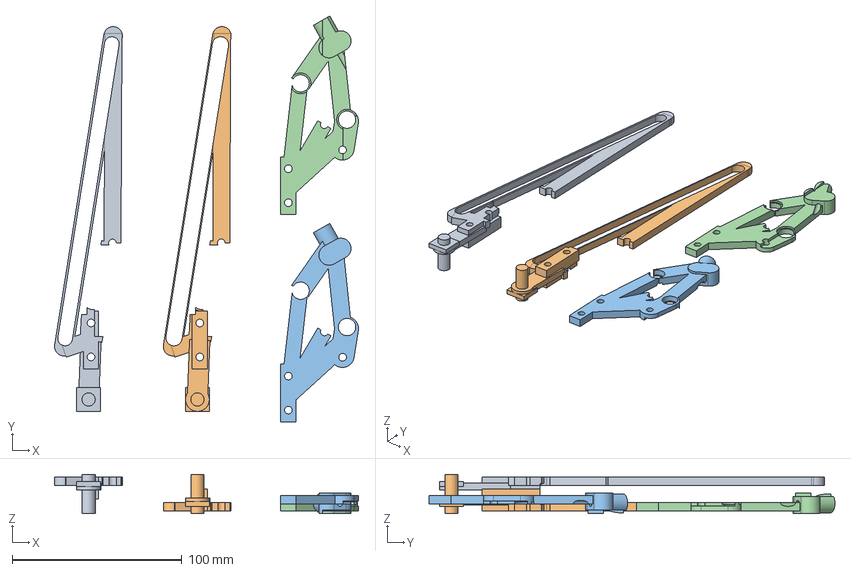
[picture p79: CAD file, 2026-07-18]
outputs/cross-axis-slider-v12-usability-audit/printables/carriages_plate.step
178.9 x 238.9 x 23.0 mm
trackpad_carriage_left
trackpad_carriage_right
keyboard_carriage_left
keyboard_carriage_right
