clChenLiang/keyboard-trackpad-cross-axis-redesign/outputs/cross-axis-slider-v10-printable-preloaded/printables/guide_eccentric_bushing.step

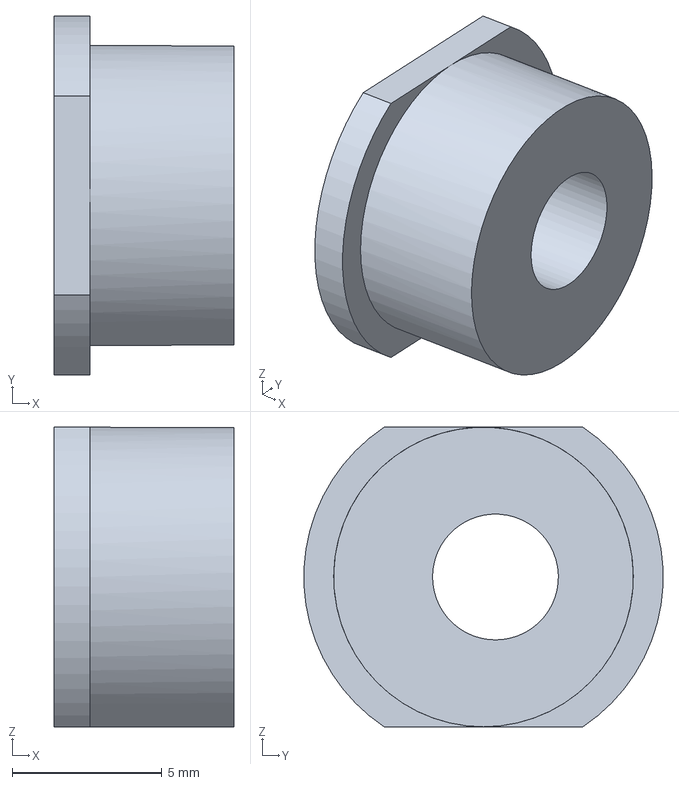
[picture p80: CAD file, 2026-07-18]
outputs/cross-axis-slider-v10-printable-preloaded/printables/guide_eccentric_bushing.step
6.00 x 12.0 x 10.0 mm
