clChenLiang/keyboard-trackpad-cross-axis-redesign/outputs/cross-axis-slider-v11-standard-hardware/printables/carriages_plate.step

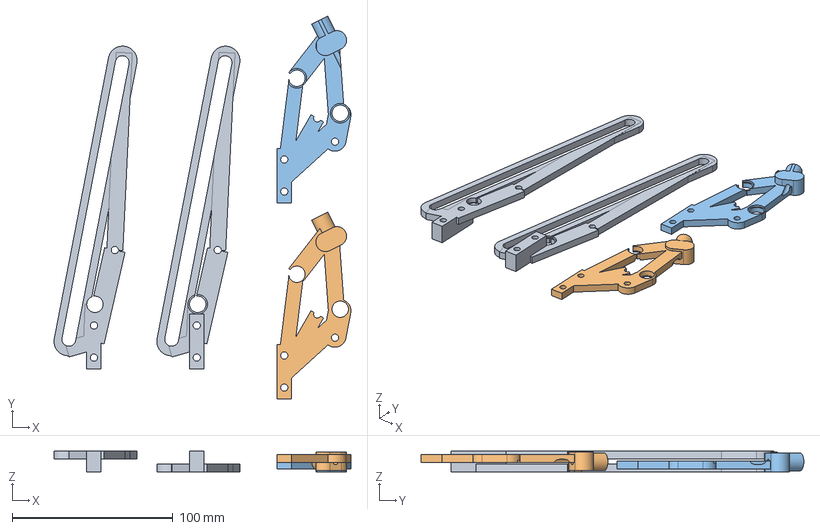
[picture p81: CAD file, 2026-07-18]
outputs/cross-axis-slider-v11-standard-hardware/printables/carriages_plate.step
184.9 x 238.2 x 13.0 mm
trackpad_carriage_left
trackpad_carriage_right
keyboard_carriage_left
keyboard_carriage_right
