clChenLiang/keyboard-trackpad-cross-axis-redesign/outputs/cross-axis-slider-v12-usability-audit/printables/tpu_base_foot.step

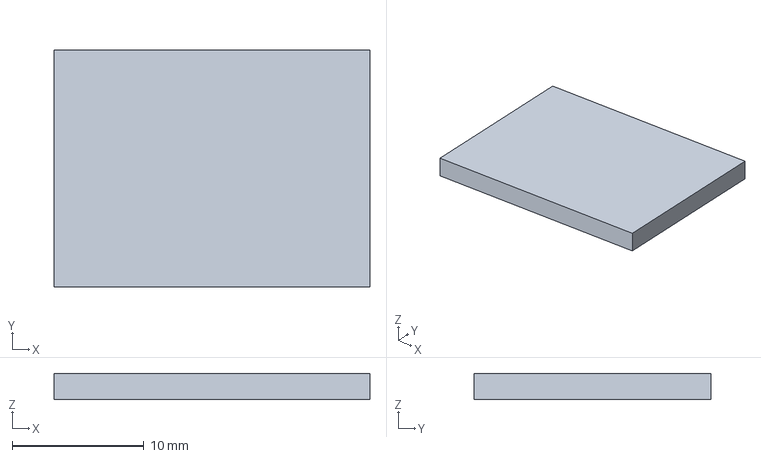
[picture p82: CAD file, 2026-07-18]
outputs/cross-axis-slider-v12-usability-audit/printables/tpu_base_foot.step
24.0 x 18.0 x 2.00 mm
