clChenLiang/keyboard-trackpad-cross-axis-redesign/outputs/cross-axis-slider-v10-printable-preloaded/printables/side_frame_left.step

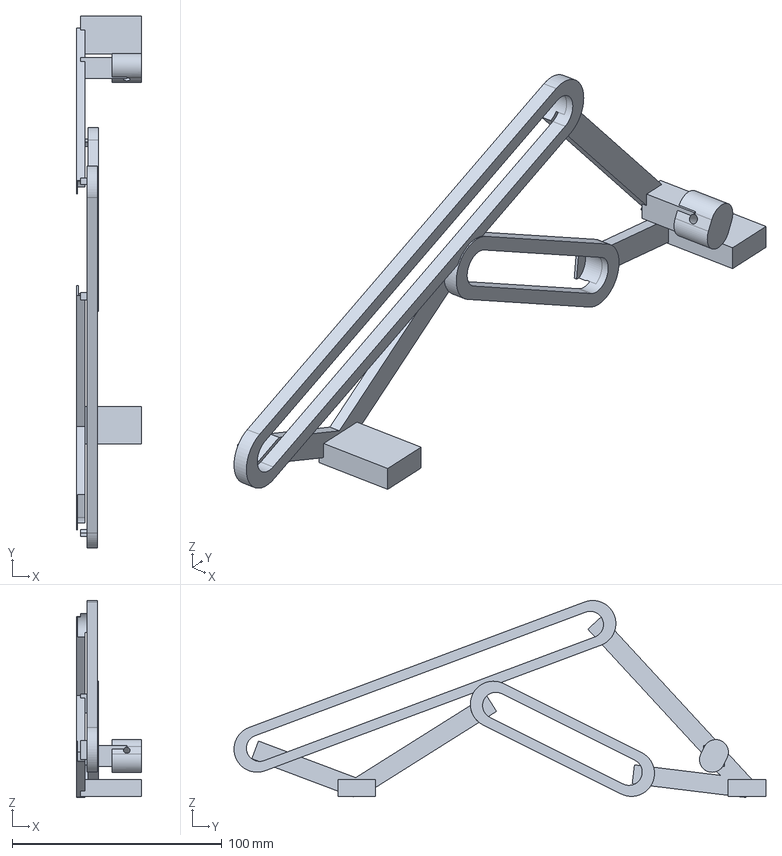
[picture p84: CAD file, 2026-07-18]
outputs/cross-axis-slider-v10-printable-preloaded/printables/side_frame_left.step
31.0 x 253.5 x 93.9 mm
