clChenLiang/keyboard-trackpad-cross-axis-redesign/outputs/cross-axis-slider-v11-standard-hardware/printables/tpu_parts_plate.step

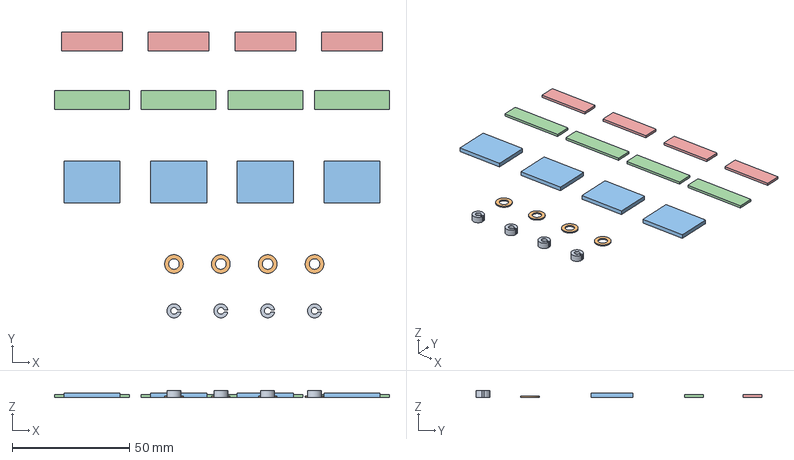
[picture p85: CAD file, 2026-07-18]
outputs/cross-axis-slider-v11-standard-hardware/printables/tpu_parts_plate.step
143.0 x 122.0 x 3.00 mm
tpu_stop_collar_1
right_float_washer_1
tpu_stop_collar_2
right_float_washer_2
tpu_stop_collar_3
right_float_washer_3
tpu_stop_collar_4
right_float_washer_4
