clChenLiang/keyboard-trackpad-cross-axis-redesign/outputs/cross-axis-slider-v10-printable-preloaded/printables/trackpad_tray.step

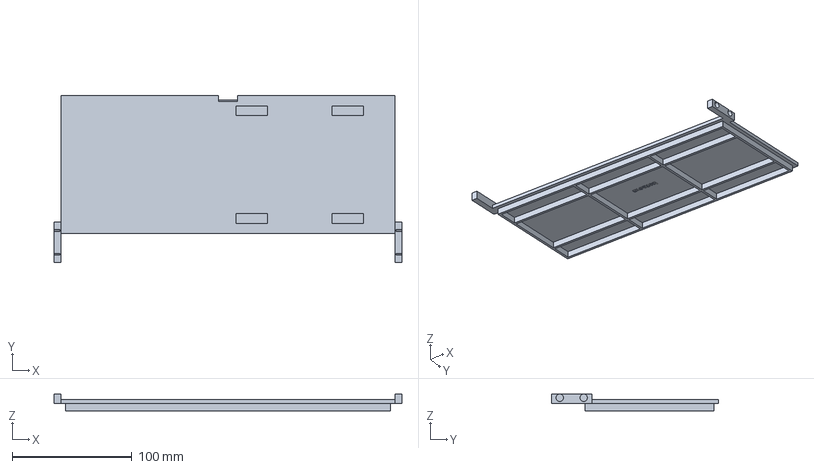
[picture p86: CAD file, 2026-07-18]
outputs/cross-axis-slider-v10-printable-preloaded/printables/trackpad_tray.step
291.0 x 139.8 x 14.0 mm
