clChenLiang/keyboard-trackpad-cross-axis-redesign/outputs/cross-axis-slider-v12-usability-audit/printables/trays_plate.step

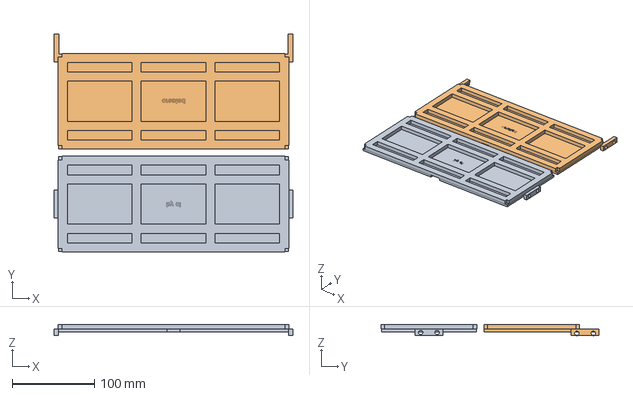
[picture p87: CAD file, 2026-07-18]
outputs/cross-axis-slider-v12-usability-audit/printables/trays_plate.step
291.0 x 265.5 x 14.0 mm
keyboard_tray
trackpad_tray
