clChenLiang/keyboard-trackpad-cross-axis-redesign/outputs/cross-axis-slider-v10-printable-preloaded/printables/keyboard_carriage_right.step

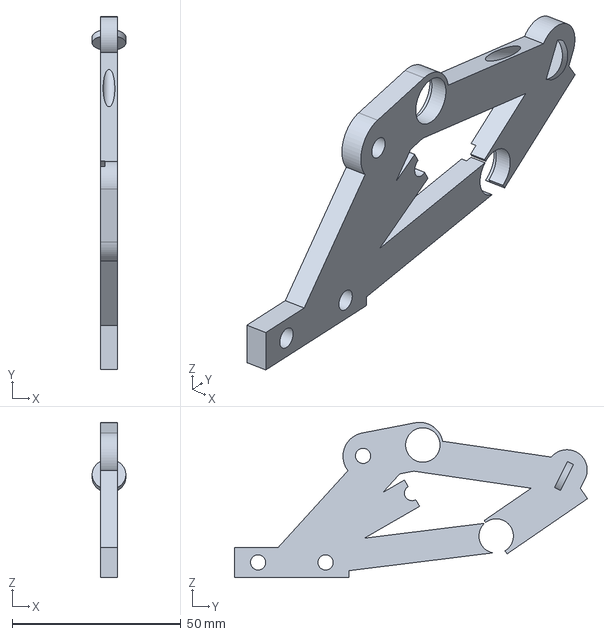
[picture p88: CAD file, 2026-07-18]
outputs/cross-axis-slider-v10-printable-preloaded/printables/keyboard_carriage_right.step
9.98 x 104.6 x 46.0 mm
