clChenLiang/keyboard-trackpad-cross-axis-redesign/outputs/cross-axis-slider-v12-usability-audit/printables/keyboard_tray.step

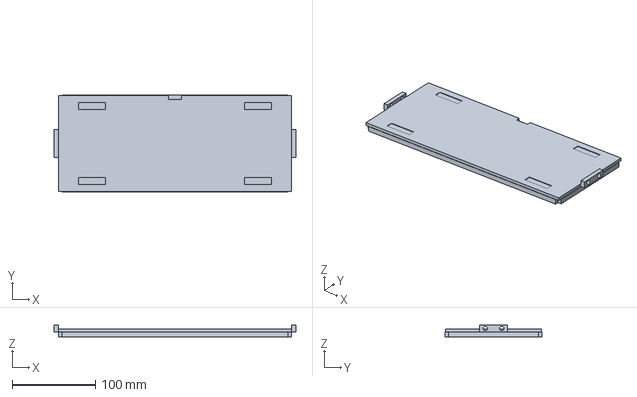
[picture p89: CAD file, 2026-07-18]
outputs/cross-axis-slider-v12-usability-audit/printables/keyboard_tray.step
291.0 x 116.7 x 14.0 mm
