clChenLiang/keyboard-trackpad-cross-axis-redesign/outputs/cross-axis-slider-v11-standard-hardware/printables/petg_small_parts_plate.step

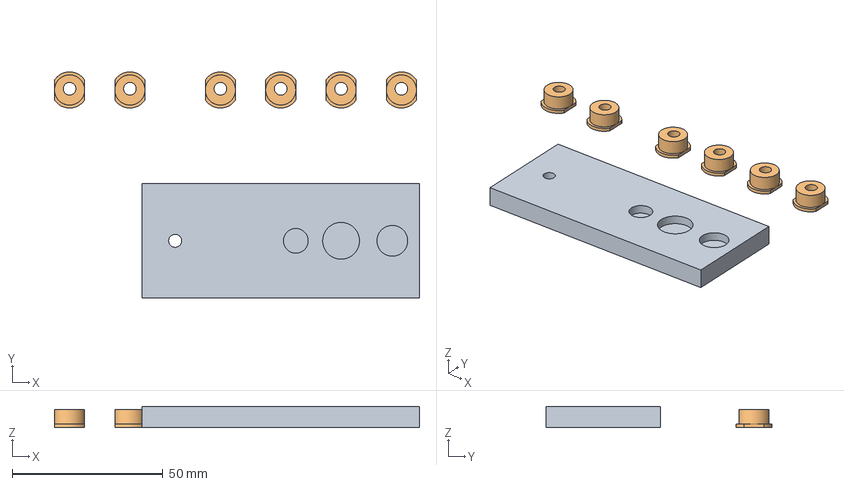
[picture p90: CAD file, 2026-07-18]
outputs/cross-axis-slider-v11-standard-hardware/printables/petg_small_parts_plate.step
121.0 x 75.0 x 7.00 mm
calibration_coupon
cross_eccentric_bushing_1
cross_eccentric_bushing_2
guide_eccentric_bushing_1
guide_eccentric_bushing_2
guide_eccentric_bushing_3
guide_eccentric_bushing_4
