clChenLiang/keyboard-trackpad-cross-axis-redesign/outputs/cross-axis-slider-v11-standard-hardware/printables/keyboard_carriage_right.step

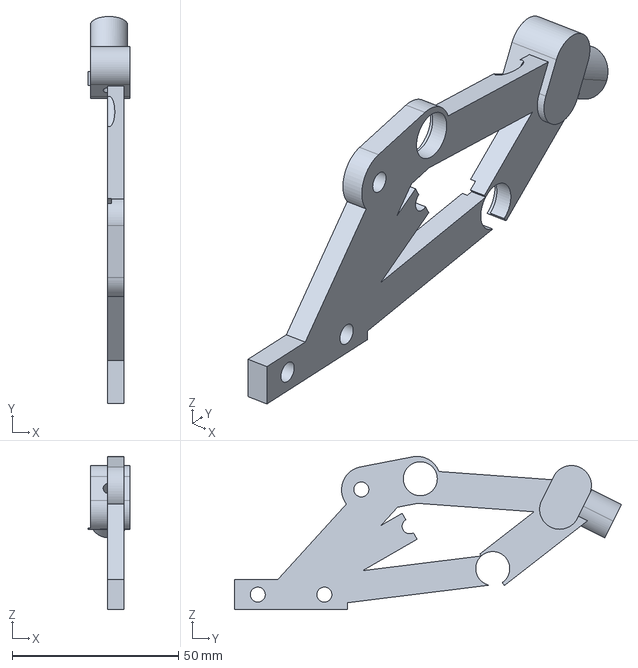
[picture p91: CAD file, 2026-07-18]
outputs/cross-axis-slider-v11-standard-hardware/printables/keyboard_carriage_right.step
12.5 x 116.2 x 46.0 mm
