clChenLiang/keyboard-trackpad-cross-axis-redesign/outputs/cross-axis-slider-v12-usability-audit/printables/tpu_spool_retainer.step

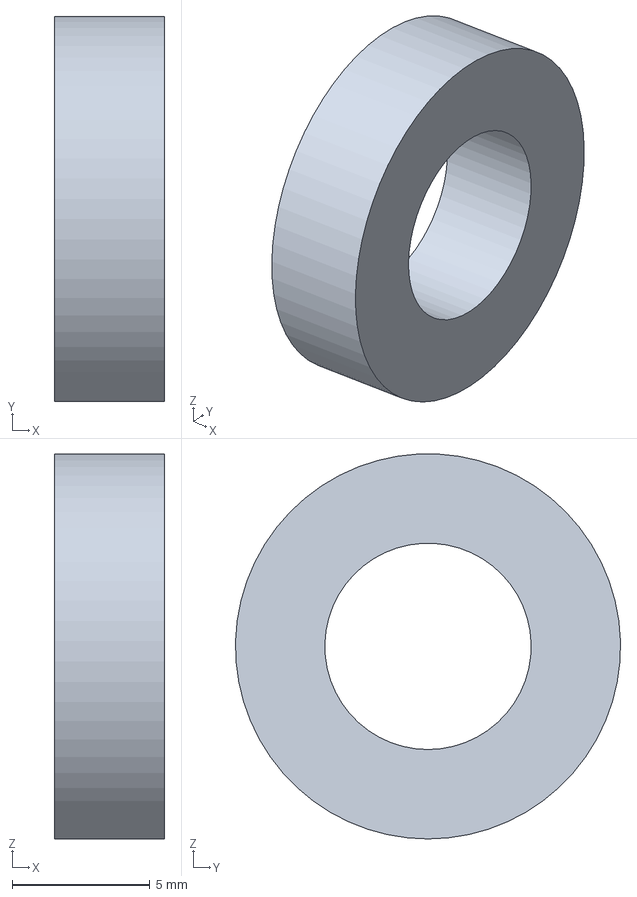
[picture p92: CAD file, 2026-07-18]
outputs/cross-axis-slider-v12-usability-audit/printables/tpu_spool_retainer.step
4.00 x 14.0 x 14.0 mm
