clChenLiang/keyboard-trackpad-cross-axis-redesign/outputs/cross-axis-slider-v10-printable-preloaded/printables/frames_plate.step

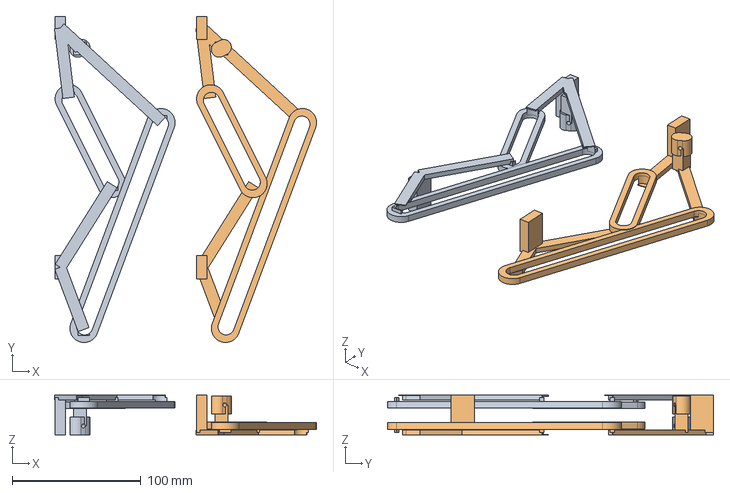
[picture p93: CAD file, 2026-07-18]
outputs/cross-axis-slider-v10-printable-preloaded/printables/frames_plate.step
203.9 x 253.5 x 31.0 mm
side_frame_left
side_frame_right
