clChenLiang/keyboard-trackpad-cross-axis-redesign/outputs/cross-axis-slider-v12-usability-audit/printables/frames_plate.step

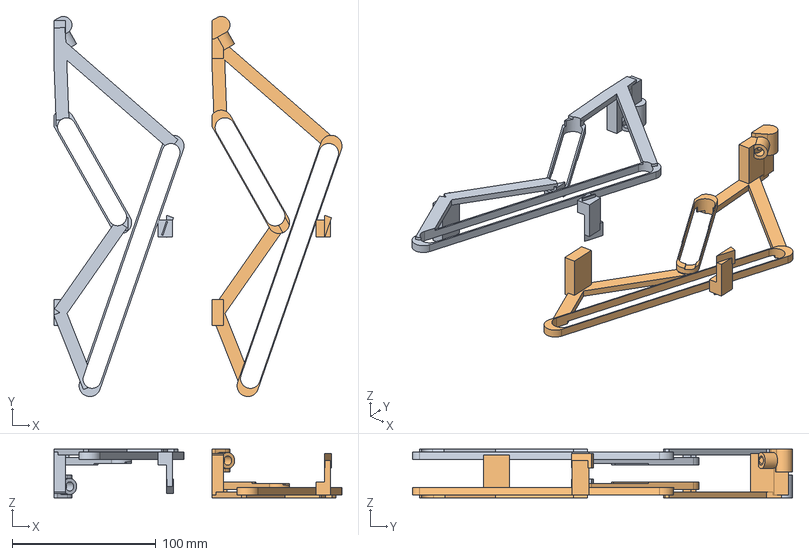
[picture p94: CAD file, 2026-07-18]
outputs/cross-axis-slider-v12-usability-audit/printables/frames_plate.step
200.5 x 264.7 x 34.0 mm
side_frame_left
side_frame_right
