clChenLiang/keyboard-trackpad-cross-axis-redesign/outputs/cross-axis-slider-v12-usability-audit/printables/cross_eccentric_bushing.step

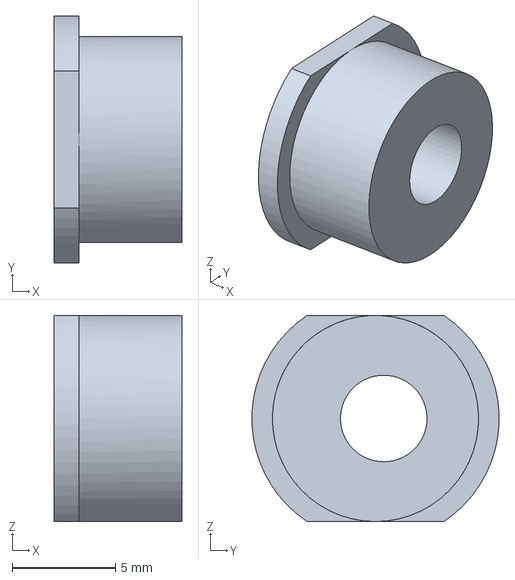
[picture p95: CAD file, 2026-07-18]
outputs/cross-axis-slider-v12-usability-audit/printables/cross_eccentric_bushing.step
6.20 x 12.0 x 10.0 mm
