clChenLiang/keyboard-trackpad-cross-axis-redesign/outputs/cross-axis-slider-v12-usability-audit/printables/side_frame_right.step

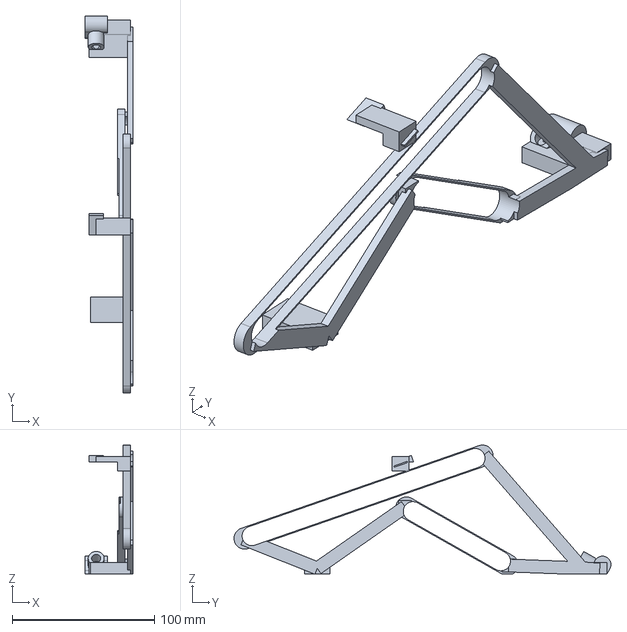
[picture p96: CAD file, 2026-07-18]
outputs/cross-axis-slider-v12-usability-audit/printables/side_frame_right.step
34.0 x 264.7 x 90.5 mm
