clChenLiang/keyboard-trackpad-cross-axis-redesign/outputs/cross-axis-slider-v11-standard-hardware/printables/side_frame_right.step

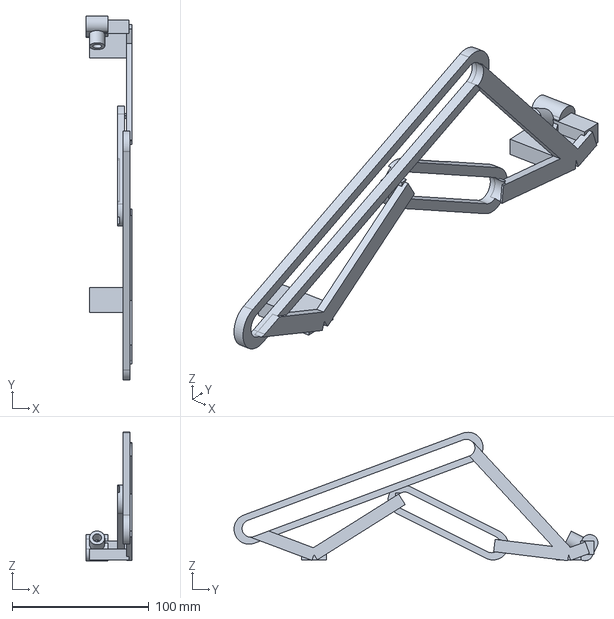
[picture p97: CAD file, 2026-07-18]
outputs/cross-axis-slider-v11-standard-hardware/printables/side_frame_right.step
33.4 x 266.0 x 93.9 mm
