clChenLiang/keyboard-trackpad-cross-axis-redesign/outputs/cross-axis-slider-v12-usability-audit/printables/calibration_coupon.step

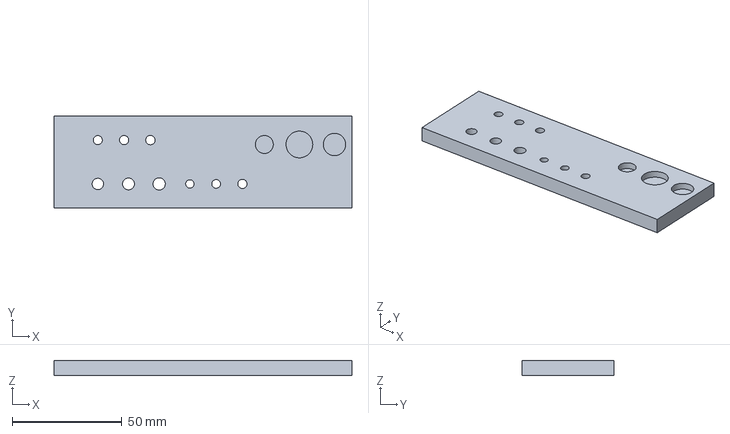
[picture p98: CAD file, 2026-07-18]
outputs/cross-axis-slider-v12-usability-audit/printables/calibration_coupon.step
136.0 x 42.0 x 7.00 mm
