clChenLiang/keyboard-trackpad-cross-axis-redesign/outputs/cross-axis-slider-v11-standard-hardware/printables/side_frame_left.step

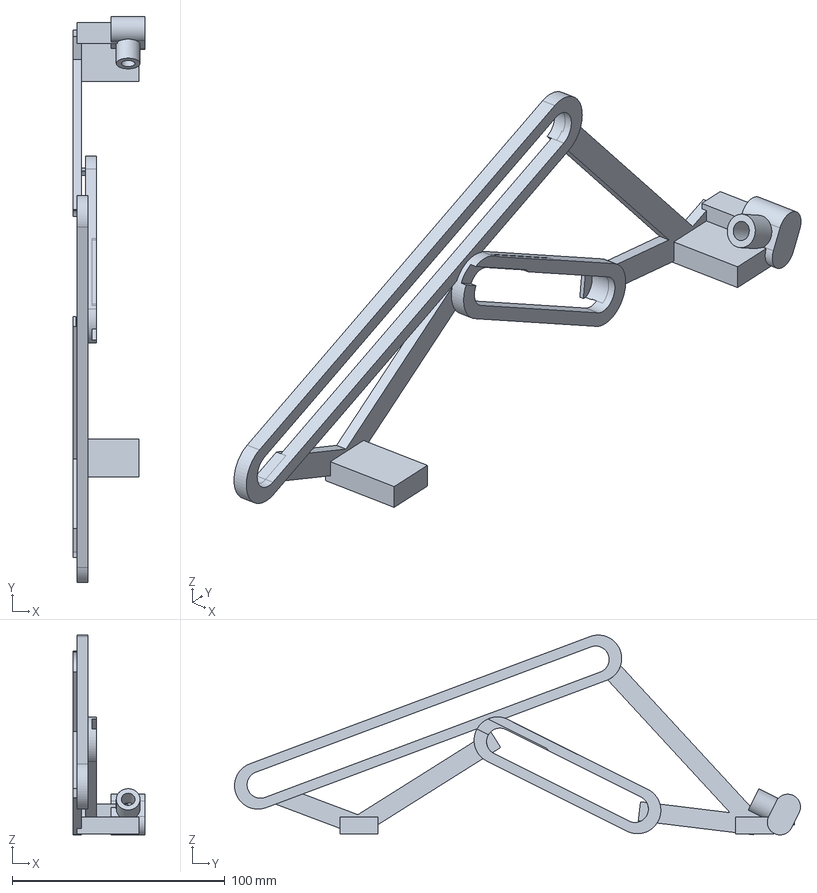
[picture p99: CAD file, 2026-07-18]
outputs/cross-axis-slider-v11-standard-hardware/printables/side_frame_left.step
34.0 x 266.0 x 93.9 mm
