clChenLiang/keyboard-trackpad-cross-axis-redesign/outputs/cross-axis-slider-v12-usability-audit/printables/tpu_parts_plate.step

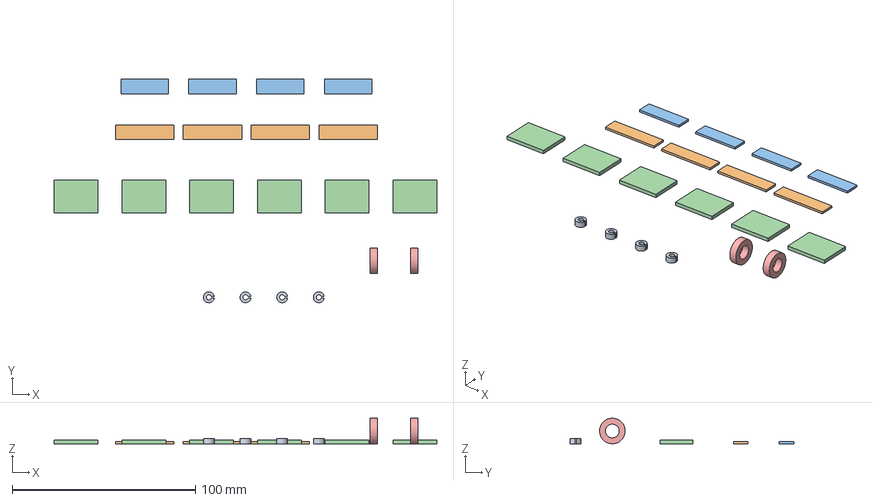
[picture p100: CAD file, 2026-07-18]
outputs/cross-axis-slider-v12-usability-audit/printables/tpu_parts_plate.step
209.0 x 122.0 x 14.0 mm
tpu_stop_collar_1
tpu_stop_collar_2
tpu_stop_collar_3
tpu_stop_collar_4
tpu_spool_retainer_1
tpu_spool_retainer_2
