clChenLiang/keyboard-trackpad-cross-axis-redesign/(list of files, cad)

Other CAD files:
outputs/cross-axis-slider-v10-printable-preloaded/roller_detail_assembled.step
outputs/rack-pinion-swing-tray-main-v3/keyboard_mode.step
outputs/cross-axis-slider-v10-printable-preloaded/keyboard_mode.step
outputs/rack-pinion-swing-tray-concept-v1/mid_mode.step
outputs/rack-pinion-swing-tray-concept-v2-supported/trackpad_mode.step
outputs/rack-pinion-swing-tray-main-v3-integrated-return-v1/trackpad_mode.step
outputs/rack-pinion-swing-tray-main-v3/mid_mode.step
outputs/rack-pinion-swing-tray-concept-v2-supported/keyboard_mode.step
outputs/rack-pinion-swing-tray-main-v3-optional-torsion-return-module-v1/v3_trackpad_mode_with_optional_return.step
outputs/rack-pinion-swing-tray-main-v3/trackpad_mode.step
outputs/cross-axis-slider-v11-standard-hardware/trackpad_mode.step
outputs/rack-pinion-swing-tray-concept-v1/keyboard_mode.step
outputs/rack-pinion-swing-tray-concept-v2-supported/cylinder_section_exploded.step
outputs/rack-pinion-swing-tray-main-v3-integrated-return-v1/mid_mode.step
outputs/rack-pinion-swing-tray-main-v3-optional-torsion-return-module-v1/v3_keyboard_mode_with_optional_return.step
outputs/cross-axis-slider-v10-printable-preloaded/trackpad_mode.step
outputs/cross-axis-slider-v11-standard-hardware/roller_detail_exploded.step
outputs/cross-axis-slider-v11-standard-hardware/keyboard_mode.step
outputs/cross-axis-slider-v12-usability-audit/keyboard_mode.step
outputs/cross-axis-slider-v12-usability-audit/printables/trackpad_carriage_right.step
outputs/cross-axis-slider-v11-standard-hardware/printables/trackpad_carriage_left.step
outputs/cross-axis-slider-v10-printable-preloaded/printables/trackpad_carriage_right.step
outputs/cross-axis-slider-v11-standard-hardware/printables/keyboard_tray.step
outputs/cross-axis-slider-v12-usability-audit/printables/keyboard_carriage_right.step
outputs/cross-axis-slider-v11-standard-hardware/printables/trackpad_tray.step
outputs/cross-axis-slider-v10-printable-preloaded/printables/trays_plate.step
outputs/cross-axis-slider-v11-standard-hardware/printables/cross_eccentric_bushing.step
outputs/cross-axis-slider-v12-usability-audit/printables/keyboard_tpu_pad.step
outputs/cross-axis-slider-v10-printable-preloaded/printables/base_plate.step
outputs/cross-axis-slider-v12-usability-audit/printables/trackpad_tray.step
outputs/cross-axis-slider-v10-printable-preloaded/printables/side_frame_right.step
outputs/cross-axis-slider-v11-standard-hardware/printables/base_plate.step
outputs/cross-axis-slider-v12-usability-audit/printables/trackpad_tpu_pad.step
outputs/cross-axis-slider-v11-standard-hardware/printables/base.step
outputs/cross-axis-slider-v10-printable-preloaded/printables/tpu_base_foot.step
outputs/cross-axis-slider-v11-standard-hardware/printables/trackpad_tpu_pad.step
outputs/cross-axis-slider-v11-standard-hardware/printables/keyboard_carriage_left.step
outputs/cross-axis-slider-v12-usability-audit/printables/guide_eccentric_bushing.step
outputs/cross-axis-slider-v10-printable-preloaded/printables/keyboard_carriage_left.step
outputs/cross-axis-slider-v11-standard-hardware/printables/guide_eccentric_bushing.step
outputs/cross-axis-slider-v10-printable-preloaded/printables/petg_small_parts_plate.step
outputs/cross-axis-slider-v11-standard-hardware/printables/tpu_base_foot.step
outputs/cross-axis-slider-v12-usability-audit/printables/base.step
outputs/cross-axis-slider-v10-printable-preloaded/printables/tpu_parts_plate.step
outputs/cross-axis-slider-v10-printable-preloaded/printables/calibration_coupon.step
outputs/cross-axis-slider-v10-printable-preloaded/printables/keyboard_tpu_pad.step
outputs/cross-axis-slider-v11-standard-hardware/printables/tpu_stop_collar.step
outputs/cross-axis-slider-v12-usability-audit/printables/tpu_stop_collar.step
outputs/cross-axis-slider-concept-v1/keyboard_mode.step
outputs/cross-axis-slider-concept-v1/mid_mode.step
outputs/cross-axis-slider-concept-v1/trackpad_mode.step
outputs/cross-axis-slider-concept-v2-open-base/keyboard_mode.step
outputs/cross-axis-slider-concept-v2-open-base/mid_mode.step
outputs/cross-axis-slider-concept-v2-open-base/trackpad_mode.step
outputs/cross-axis-slider-concept-v3-compact-base/keyboard_mode.step
outputs/cross-axis-slider-concept-v3-compact-base/mid_mode.step
outputs/cross-axis-slider-concept-v3-compact-base/trackpad_mode.step
outputs/cross-axis-slider-concept-v4-captured-slider-link/keyboard_mode.step
outputs/cross-axis-slider-concept-v4-captured-slider-link/mid_mode.step
outputs/cross-axis-slider-concept-v4-captured-slider-link/trackpad_mode.step
outputs/cross-axis-slider-concept-v5-downhill-slot/keyboard_mode.step
outputs/cross-axis-slider-concept-v5-downhill-slot/mid_mode.step
outputs/cross-axis-slider-concept-v5-downhill-slot/trackpad_mode.step
outputs/cross-axis-slider-concept-v6-symmetric-spring/keyboard_mode.step
outputs/cross-axis-slider-concept-v6-symmetric-spring/mid_mode.step
outputs/cross-axis-slider-concept-v6-symmetric-spring/trackpad_mode.step
outputs/cross-axis-slider-concept-v7-low-lift-stop/keyboard_mode.step
outputs/cross-axis-slider-concept-v7-low-lift-stop/mid_mode.step
outputs/cross-axis-slider-concept-v7-low-lift-stop/trackpad_mode.step
outputs/cross-axis-slider-concept-v8-collision-free/keyboard_mode.step
outputs/cross-axis-slider-concept-v8-collision-free/mid_mode.step
outputs/cross-axis-slider-concept-v8-collision-free/trackpad_mode.step
outputs/cross-axis-slider-concept-v9-force-closed/keyboard_mode.step
outputs/cross-axis-slider-concept-v9-force-closed/mid_mode.step
outputs/cross-axis-slider-concept-v9-force-closed/trackpad_mode.step
outputs/cross-axis-slider-v10-printable-preloaded/printables/base.stl
outputs/cross-axis-slider-v10-printable-preloaded/printables/base_plate.3mf
outputs/cross-axis-slider-v10-printable-preloaded/printables/calibration_coupon.stl
outputs/cross-axis-slider-v10-printable-preloaded/printables/carriages_plate.3mf
outputs/cross-axis-slider-v10-printable-preloaded/printables/cross_eccentric_bushing.stl
outputs/cross-axis-slider-v10-printable-preloaded/printables/frames_plate.3mf
outputs/cross-axis-slider-v10-printable-preloaded/printables/guide_eccentric_bushing.stl
outputs/cross-axis-slider-v10-printable-preloaded/printables/keyboard_carriage_left.stl
outputs/cross-axis-slider-v10-printable-preloaded/printables/keyboard_carriage_right.stl
outputs/cross-axis-slider-v10-printable-preloaded/printables/keyboard_tpu_pad.stl
outputs/cross-axis-slider-v10-printable-preloaded/printables/keyboard_tray.stl
outputs/cross-axis-slider-v10-printable-preloaded/printables/petg_small_parts_plate.3mf
outputs/cross-axis-slider-v10-printable-preloaded/printables/right_float_washer.step
outputs/cross-axis-slider-v10-printable-preloaded/printables/right_float_washer.stl
outputs/cross-axis-slider-v10-printable-preloaded/printables/side_frame_left.stl
outputs/cross-axis-slider-v10-printable-preloaded/printables/side_frame_right.stl
outputs/cross-axis-slider-v10-printable-preloaded/printables/tpu_base_foot.stl
outputs/cross-axis-slider-v10-printable-preloaded/printables/tpu_parts_plate.3mf
outputs/cross-axis-slider-v10-printable-preloaded/printables/tpu_stop_collar.stl
outputs/cross-axis-slider-v10-printable-preloaded/printables/trackpad_carriage_left.stl
outputs/cross-axis-slider-v10-printable-preloaded/printables/trackpad_carriage_right.stl
outputs/cross-axis-slider-v10-printable-preloaded/printables/trackpad_tpu_pad.stl
outputs/cross-axis-slider-v10-printable-preloaded/printables/trackpad_tray.stl
outputs/cross-axis-slider-v10-printable-preloaded/printables/trays_plate.3mf
outputs/cross-axis-slider-v11-standard-hardware/printables/base.stl
outputs/cross-axis-slider-v11-standard-hardware/printables/base_plate.3mf
outputs/cross-axis-slider-v11-standard-hardware/printables/calibration_coupon.stl
outputs/cross-axis-slider-v11-standard-hardware/printables/carriages_plate.3mf
outputs/cross-axis-slider-v11-standard-hardware/printables/cross_eccentric_bushing.stl
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
