clChenLiang/keyboard-trackpad-cross-axis-redesign/outputs/cross-axis-slider-v12-usability-audit/ASSEMBLY.md

# V12 装配与调试

先完成尺寸试片。正式装配过程中不要让轴承外圈被螺母轴向夹紧。

## 1. 打印后处理

1. 清除导槽、螺孔和偏心法兰凹槽毛刺，不打磨导槽工作壁。
2. 用 3.0 mm 钻头手动清理两个限位导杆盲孔；孔底保留材料。
3. 热压 12 个 M4 热熔螺母：底座侧框接口 4 个、两托盘侧耳 8 个。
4. 在左右 CFS 固定座各热压 1 个 M3、OD 4.6 × 5.0 热熔螺母。
5. 检查每个偏心套能旋转；12 mm 调整法兰应外露，6 mm 肩轴头应完整落入法兰中央沉孔，不得骑在法兰上。

## 2. 固定框与底座

1. 将六个 TPU 脚压入底座底面完整支撑口袋；每侧前、中、后各一个。
2. 左右侧框落在底座两侧定位面上。
3. 从底部装入 4 个 M4 × 8 螺钉，先对角轻锁，再对角拧紧。
4. 确认两侧导槽互相平行，底座六脚同时接触桌面。

## 3. 先组装左右交叉移动模块

交叉滚轮必须在移动模块尚未放入固定侧框时装配；装入固定框后，斜撑会部分遮挡交叉滚轮螺母的轴向套筒空间。

每侧使用两个 MR84ZZ，分别接触交叉长槽的相对壁：

1. 将同侧键盘侧架与妙控板侧架平放在桌面，使两者处于同一键盘端位。
2. 使用 Ø4 × 12 mm 工作肩、M3 × 4 螺纹、Ø6 × 2 低头肩轴。
3. 按“肩轴头 → 键盘侧架/偏心套 → MR84ZZ → M3 平垫 → M3 螺母”装配。
4. 将两个 MR84ZZ 都置入妙控板侧架的蓝色长槽，再轻锁螺母。
5. 左侧交叉偏心轮调到刚好消除晃动后退回约 5°。右侧长槽比左侧宽 1.00 mm，只调到消除明显敲击声，不得强压到双壁同时预紧。
6. 左右移动模块必须停在同一端位，再进入下一步。

## 4. 将移动模块装入直线导向

每条槽装两个 604ZZ：编号 1 为固定轮，编号 2 为偏心轮。

1. 将左右完整移动模块分别放到固定侧框内，使四个侧架与对应导槽对齐。
2. 固定轮堆栈：肩轴头 → 侧架固定孔 → 604ZZ → M3 平垫 → M3 螺母。
3. 偏心轮堆栈：肩轴头 → 嵌入式偏心套 → 604ZZ → M3 平垫 → M3 螺母。
4. 螺母只消除轴向窜动，轴承外圈必须能自由转动。
5. 直线导向螺母均从固定框外侧操作；暂不调偏心预紧。

肩轴对应：键盘导向 20 mm，妙控板导向 16 mm。两者均为 Ø4 光肩、M3 × 4 螺纹、Ø6 × 2 低头规格。

## 5. CFS 回位件与端位

1. 两根 Ø3 × 122 导杆分别穿过键盘侧架隧道，插入固定侧框盲孔至底；导杆不再承载压缩弹簧，只承载独立端位环。
2. 每侧把一只 CFS0.2 原装 PE 卷筒套到妙控板侧架 Ø7.8 一体轴柱上。钢带展开方向必须与蓝色妙控板轨迹一致，不得反卷。
3. 至少先展开 45 mm，再把原装带孔端片贴到固定座，用一颗 M3 × 8 固定。不要在钢带上另打孔，也不要添加打印夹板。
4. 压入 TPU 卷筒挡帽；卷筒应能自由转动，挡帽只限制轴向脱出，不夹紧卷筒端面。
5. 从径向开口将两个 TPU C 形缓冲环卡到每根 Ø3 导杆：回位端一个、按压端一个。
6. 缓冲环位置以 STEP 端位为基准；滚轮不得承担撞击槽端的限位功能。

## 6. 托盘

1. 左右两侧均直接贴合：键盘托每侧用 2 个 M4 × 10，妙控板托每侧用 2 个 M4 × 16。
2. 四组托盘螺钉正常锁紧；防卡自由度来自右侧加宽随动槽，不来自松动的托盘连接。
3. 装入 8 个设备 TPU 垫，最后放置键盘和妙控板。

## 7. 偏心预紧

1. 所有偏心套先置于最松位置。
2. 先调整左侧定位槽，使固定轮和偏心轮轻触相对壁。再调整右侧随动槽，仅消除可感知松旷，必须保留自由随动。
3. 每次只转小角度；出现滚动阻力明显增加时退回约 5–10°。
4. 保持法兰角度，锁紧 M3 螺母，并使用少量可拆中强度螺纹锁固剂。
5. 若交叉槽在带载循环后仍需重调，应拆下托盘和该侧直线导向滚轮，将完整移动模块取出后再调；不要在斜撑后方强行套工具。

## 8. 手动验收

未放设备时先做 20 次慢速全行程：

- 两侧同步，无先后卡住或扭转。
- 所有轴承外圈实际滚动，不在槽壁上拖滑。
- 两端由 TPU 环接触，轴承距离槽端仍有余量。
- 松手能连续回到键盘端位；两只 CFS 卷筒转动顺畅，钢带不擦侧架、不跳卷。

放入设备后再做 100 次慢速循环。若出现异响、偏磨、松脱或一侧先到端，停止使用并重新调偏心与右侧浮动连接。参数化验证不能替代这一步实体循环测试。
