clChenLiang/keyboard-trackpad-cross-axis-redesign/outputs/cross-axis-slider-v12-usability-audit/PRINT_SETTINGS.md

# H2D 打印设置基线

这些是首件起始参数，不替代材料标定。H2D 单喷嘴有效尺寸按 325 × 320 × 325；六张单材料排盘均已在该范围内。

## PETG-HF 结构件

- 喷嘴：0.4 mm 硬化钢；层高 0.20 mm。
- 墙线：侧框、侧架 6 圈；底座、托盘 5 圈。
- 顶/底层：6 层。
- 填充：侧框、侧架 55% gyroid；底座、托盘 30% gyroid。
- 采用材料厂商 PETG-HF 预设，先做流量动态校准和压力提前校准。
- 外墙速度不高于 80 mm/s；小孔/小轮廓不高于 35 mm/s。
- 侧框、侧架按 3MF 中姿态侧放；托盘以连续输入面朝下，肋条向上。
- 正常不启用支撑。切片预览若在偏心法兰盲槽出现孤立桥接，只允许“仅接触热床”局部支撑。

## TPU 95A

- 0.4 mm 喷嘴，0.20 mm 层高，3–4 圈墙线，100% 填充。
- 使用独立 TPU 预设；最大体积流量从 3 mm³/s 起步。
- TPU 全部位于独立的 `tpu_parts_plate.3mf`，不与 PETG 混盘。

## 首件尺寸门槛

先打印 `calibration_coupon`：

1. 分别试 Ø4.10 / 4.20 / 4.30 肩轴孔，选择可自由穿过且无明显晃动的最小值。
2. M4 热熔预孔试 Ø5.20 / 5.40 / 5.60；M3 试 Ø3.80 / 4.00 / 4.20。插入件必须能热压到位且冷却后不可手扭转。
3. 604ZZ、MR84ZZ 与偏心套接口不得靠暴力压入。
4. 固定盲孔用 3.0 mm 钻头或铰刀清理；不要扩大偏心套外圆定位孔。
5. 若试片不合格，先调整 `PRINT_HOLE_COMPENSATION`、热熔预孔参数或 `PRINT_SLOT_COMPENSATION` 并重新生成，不要直接打磨全部正式零件。

## 切片前检查

- 所有对象均贴床且没有自动缩放。
- `petg_small_parts_plate` 使用 PETG-HF，`tpu_parts_plate` 使用 TPU 95A。
- 肩轴、轴承、CFS0.2、M3/M4 紧固件和金属导杆不在打印盘内，它们属于外购件。
- 托盘顶面朝下；不要让切片器自动翻转。
- 托盘 11 mm 宽加强筋必须完整生成；不得为了缩短打印时间把筋宽在切片器中负补偿。
