clChenLiang/keyboard-trackpad-cross-axis-redesign/docs/superpowers/specs/2026-07-15-v10-printable-preloaded-roller-design.md

# V10 可打印预紧滚轮联动支架设计

## 1. 目标与边界

V10 在独立目录 `outputs/cross-axis-slider-v10-printable-preloaded` 中实现，不修改 V1–V9。最终交付必须是可拆装、可在拓竹 H2D 上打印、运动学闭合且没有已知实体碰撞的工程样机设计，而不是只展示三个姿态的概念模型。

V10 保留以下已确认的人机目标：

- 键盘默认位；左手把键盘托向显示器方向、向下推动。
- 妙控板托同步向使用者方向、向下移动，进入右手区域。
- 键盘端位位移为 `+30 Y / -15 Z`；妙控板端位位移为 `-115 Y / -43 Z`。
- 两个托盘保持水平，左右双边支撑，妙控板靠右放置。
- 松手后由两侧对称压缩弹簧自动回到键盘模式。
- 支撑和运动件位于托盘外侧，不跨过输入表面。

## 2. 选择的机构

采用双侧直线导向与双侧交叉槽耦合。V9 的单滚轮名义零间隙只适合展示：实际打印槽必须留间隙，而按下与回位时槽壁受力方向相反，会产生回程空行程。V10 因此在每条运动槽内使用一对沿槽方向错开的滚轮：固定滚轮贴一侧槽壁，偏心滚轮贴另一侧槽壁。

偏心套提供可装配调节，不依靠打印尺寸恰好等于轴承外径。调节后，两个滚轮同时接触相对槽壁，但不得使轴承产生明显径向卡紧。该拓扑保留真实的滑动交点，并能双向传力。

### 2.1 交叉耦合

- 每侧使用两个 `MR84ZZ` 轴承，名义尺寸 `4 × 8 × 3 mm`。
- 两轴承中心沿交叉槽方向相距 `18 mm`，避免实体重叠。
- 蓝色交叉槽名义宽度 `8.6 mm`，槽板厚度 `4.8 mm`。
- 固定轴承中心相对槽中心偏向第一槽壁 `0.30 mm`。
- 第二轴承安装于偏心量 `0.40 mm` 的打印偏心套中，可覆盖槽宽与打印误差。
- 槽端在完整行程之外保留至少 `5 mm` 的滚轮中心余量；硬限位不得由轴承撞槽端承担。

### 2.2 托盘直线导向

- 键盘托与妙控板托各有左右两条固定直槽导轨。
- 每条导轨使用两个 `604ZZ` 轴承，名义尺寸 `4 × 12 × 4 mm`。
- 两轴承中心沿导轨方向相距：键盘 `28 mm`，妙控板 `36 mm`。
- 导槽名义宽度 `12.6 mm`，导轨板厚度 `5.2 mm`。
- 每对轴承采用一个固定孔和一个 `0.40 mm` 偏心套，对置贴合两侧槽壁。
- 左侧为装配基准；右侧轴承组在 X 方向保留 `0.6 mm` 总浮动量，防止左右导轨因打印误差互相打架。

## 3. 刚体与连接

### 3.1 固定结构

底座为镂空框架。初始外形参数取 `298 × 250 mm`，厚度 `6 mm`，四个防滑脚中心形成支撑多边形。最终尺寸由静态倾覆检查决定：装入两台设备和全部打印件后，键盘模式与妙控板模式的总重心投影必须距离支撑多边形边界至少 `15 mm`；不满足时只增加底座前后脚跨度，不隐藏该失败。

每侧的键盘导轨、妙控板导轨、三角加强筋和底部安装脚合并成一个连续侧框。侧框通过两个定位榫插入底座，并由每侧两颗 M4 螺钉锁紧。定位榫承担剪切载荷，螺钉只负责夹紧。不得再使用 V9 中按矩形边界估算高度的独立细支撑柱。

### 3.2 移动结构

每个托盘左右各连接一个连续侧架。侧架包含托盘连接榫、导向轴承安装孔、交叉滚轮安装孔或交叉槽，并在同一实体内形成连续力路。

托盘与侧架采用打印定位榫加 M4 紧固件连接。左侧圆孔定位，右侧 X 向长孔释放装配误差。所有紧固件均可从底部或外侧操作，不拆设备即可维护。

### 3.3 托盘

- 外形保持 `279.7 × 115.7 mm`。
- 连续上表面名义厚度 `3.5 mm`。
- 底面加入 `3.0 mm` 深、`2.4 mm` 厚的周边梁和十字浅筋；筋不得侵入运动件包络。
- 键盘槽按 `278.9 × 114.9 × 10.9 mm` 包络，每侧名义间隙 `0.4 mm`。
- 妙控板槽宽 `160.8 mm`，靠右对齐。
- 设备只接触可更换 TPU 垫，不直接接触碳纤维填充材料。
- 保留充电线缺口。
- 背面浅凹文字分别为 `by cl` 与 `created`，深 `0.25 mm`、字高 `8 mm`、最小笔画 `1.2 mm`。

## 4. 回位与端位

两根压缩弹簧沿键盘运动方向对称布置，并套在导杆上防止屈曲。当前唯一规格为自由长 `82 mm`、安装长 `49 mm`、外径 `8 mm`、线径 `0.55 mm`、刚度约 `0.19 N/mm`。最大压缩行程为键盘路径 `33.54 mm`；终态长度约 `15.46 mm`，相对 `8 mm` 压并长度保留约 `7.46 mm` 余量。

弹簧最终规格不凭视觉选择，而由生成模型的质量属性计算：

- 在最不利摩擦假设下，起始回位力必须比两托盘沿路径的重力分量和摩擦力之和高至少 `2 N`。
- 用户端最大持续按压力目标不超过 `20 N`。
- 两侧弹簧额定力差异按 `±10%` 检查，机构仍应回位且不楔死。

键盘模式和妙控板模式均使用独立 TPU 缓冲块作为硬限位。轴承到槽端在任何姿态均保持至少 `2 mm` 实体间隙。

## 5. 打印与装配设计

不采用 print-in-place 活动关节。所有滚轮、偏心套、侧框、侧架、托盘和底座均为独立零件：

- 底座和托盘以大平面贴床打印。
- 左右侧框以 X 厚度方向贴床打印，使导槽轮廓位于层内，避免长槽桥接。
- 移动侧架以侧面贴床打印。
- 偏心套、垫片和端盖成组打印，并提供尺寸试片。
- 结构件默认按 PETG-HF 参数设计；需要更高刚度时可换 PAHT-CF，但设备接触区仍必须使用 TPU 隔离。
- 所有压入孔、滑动孔和偏心套尺寸由打印试片校正；源文件保留独立补偿参数，不把切片机补偿写死进几何逻辑。

## 6. 五金基线

- `MR84ZZ 4 × 8 × 3 mm`：4 个。
- `604ZZ 4 × 12 × 4 mm`：8 个。
- 键盘导向肩轴：`Ø4 × 20.5 mm` 工作肩、`M3 × 3.4 mm` 螺纹端，4 个。
- 妙控板导向肩轴：`Ø4 × 14.5 mm` 工作肩、`M3 × 3.4 mm` 螺纹端，4 个。
- 交叉滚轮肩轴：`Ø4 × 10.5 mm` 工作肩、`M3 × 3.4 mm` 螺纹端，4 个。
- `3.2 ID × 7 OD × 0.5 mm` 内圈垫片与 DIN 934 M3 螺母：各 12 个；螺母使用可拆中强度螺纹锁固剂，轴承只在光肩上转动。
- 每个滚轮轴向堆栈均按“肩轴头—移动侧架/嵌入式偏心法兰—轴承—内圈垫片—M3 螺母”闭合；固定侧框切出贯穿整个轴端与工具区的随动通道。
- 侧框和托盘连接 M4 紧固件：数量由连接细化确定，但不得用轴承肩轴兼作结构夹紧螺钉。
- 压缩弹簧：2 个，按第 4 节计算后选定唯一规格。
- TPU 防滑脚、端位缓冲和设备垫：打印件。

## 7. 参数化源文件边界

V10 源码拆分为：

- `mechanism.py`：纯运动学、受力投影、端位和弹簧需求计算。
- `parts.py`：底座、托盘、侧框、侧架、偏心套、缓冲块和轴承替代实体。
- `assembly.py`：三姿态装配、标签、零件位置和导出。
- `validation.py`：连接、间隙、碰撞、重心、打印尺寸和装配可达性检查。
- `export_printables.py`：STEP 主装配以及分件 STEP、STL、3MF 输出。

V1–V9 只可作为尺寸与辅助几何参考，不从其生成器导入运动刚体，避免旧拓扑继续渗入 V10。

## 8. 验收标准

### 8.1 数学与运动

- 至少 `401` 个连续行程样本满足交叉槽法向闭合误差 `< 0.01 mm`。
- 所有滚轮中心始终位于对应有效槽长内。
- 键盘和妙控板位移单调，无刚性杆伸缩或姿态插值伪运动。
- 虚功比例、槽法向传力投影和弹簧能量平衡明确输出，不把较大的输入力隐藏为“轻触”。

### 8.2 实体与连接

- 至少 `101` 个姿态执行实体碰撞检查；除轴承与槽壁、轴与轴承孔、弹簧与弹簧座等设计接触外，不得有非设计相交。
- 每个侧框必须为单一连通实体；每个移动侧架必须为单一连通实体。
- 底座定位榫与侧框、托盘定位榫与侧架具有正的装配重叠或明确的机械紧固界面。
- 所有固定结构之间最大非设计间隙为 `0 mm`；不得存在视觉悬空支撑。

### 8.3 可打印与可装配

- 每个打印件均为闭合正体积实体，无小于 `1.2 mm` 的孤立承力壁。
- 免支撑目标角度为相对打印平台不低于 `45°`；不可避免的支撑区域必须从外部可清理。
- 最大单件包络适配 H2D 成型空间。
- 轴承、肩轴、弹簧、紧固螺钉均具有装入路径和工具操作空间。
- 输出尺寸试片，先验证 4 mm 轴孔、MR84/604 轴承座、偏心套和 TPU 插槽。

### 8.4 稳定与使用

- 两台设备按给定质量装入后，两端位重心投影均满足 `15 mm` 防倾覆边距。
- 在左右弹簧 `±10%`、右侧 `0.6 mm` 浮动和最大打印间隙组合下，机构仍可完成全行程。
- 硬限位先于轴承撞槽端和弹簧压并发生。
- 交付物包括总装 STEP、键盘/中间/妙控板三姿态 STEP、全部打印件 STEP/STL/3MF、BOM、装配顺序、打印方向和实际运行过的验证报告。

## 9. 已知工程限制

CAD 验证能排除几何矛盾、明显碰撞、缺失连接和静态倾覆问题，但不能代替实物对层间强度、滚动阻力、噪声、弹簧手感和长期磨损的测试。首套打印件应视为工程样机；尺寸试片和一次空载装配是正式整机打印前的强制门槛。
