clChenLiang/keyboard-trackpad-cross-axis-redesign/outputs/cross-axis-slider-v12-usability-audit/VALIDATION.md

# V12 验证方法

- 运动学：401 点检查交叉约束闭合、单调性、左右镜像轨迹和槽端余量。
- 双侧并行：左侧为基准；右侧额外 1.00 mm 槽宽提供 ±0.50 mm 法向随动。独立模拟 0.10° 右框角误差时，最大法向偏差约 0.256 mm，余量约 0.244 mm。
- 滚轮预紧：仅左侧定位槽轻预紧。右侧固定轮名义间隙 0.50 mm；0.40 mm 偏心量可把可调轮最小间隙降至约 0.10 mm，但右侧不得调成第二个刚性基准。
- 同组硬件：三姿态单独检查肩轴头/偏心套、妙控板托盘螺钉/滑架，禁止任何大于 0.05 mm³ 的实体互穿。
- 碰撞：101 点覆盖 0–100% 行程。每点独立重建完整 BREP，并包含键盘、妙控板设备包络、底座、托盘、侧架、滚轮、肩轴、螺母、垫片、限位和 CFS 回位件。
- 近间隙：同一 101 点扫描同时测量 1.5 mm 邻域内的非接触对。最终最小名义间隙 1.395 mm；扣除 0.25 mm 校准后打印闭合误差，最坏间隙 1.145 mm，满足不小于 1.0 mm 的门槛。
- 设备净空：401 点最小名义值 1.600 mm；扣除上下托盘合计 0.50 mm 的 Z 向闭合误差后为 1.100 mm。
- 内存策略：OpenCascade 工作者串行隔离；超时、内核退出或无效 JSON 均按失败，不允许空结果冒充通过。
- 回位：按 CFS0.2 的 0.2 kgf/侧及 0/+15% 供应公差计算自动回位余量和用户按压力。
- 强度：20 N 静载一阶复合梁筛查；目标托盘中心挠度不大于 1.0 mm。
- 制造：检查每个打印件为单一有效实体、H2D 成型包络、六张打印盘边界与对象间距、肩轴堆栈和装配接触。

## 本轮权威结果

- 运动：401/401 点通过，最大交叉约束误差 `1.25e-14 mm`，单调，无死点。
- 碰撞：101/101 点通过，实体碰撞 0，近间隙候选检查 12,595 对。
- 双边随动：假设右框 0.10° 角误差时仍余 0.244 mm 法向随动量。
- 回位计算：最大用户按压力 5.69 N；两只 CFS0.2 在计算公差内可回位。
- 20 N 一阶强度：托盘中心挠度 0.948 mm；托盘/侧滑架安全系数约 8.78/3.00。
- 稳定性：最小重心投影边界余量 65.79 mm。
- STL：17 个分件经网格复检均为 watertight 且具有有效体积。

数字结果不替代首件的 12 N 防滑、8 N 偏心输入、45°C、10,000 次寿命和夹手风险验收。

权威数值见重新生成后的 `validation_report.json`。报告中的 `recorded_target_deviations` 是公开偏差，不等于碰撞或制造失败。
