clChenLiang/keyboard-trackpad-cross-axis-redesign/(commit log)

2026-07-18 Initial CAD design history
    [FIRST_ARTICLE_RESULTS.csv, base.step, base.stl, base_plate.3mf, base_plate.step, calibration_coupon.step, calibration_coupon.stl, carriages_plate.3mf]
2026-07-18 Integrate rack retention and torsion return
    [cylinder_return_section_exploded.step, keyboard_mode.step, mid_mode.step, trackpad_mode.step]
2026-07-18 Document open-frame base redesign
2026-07-18 Plan open-frame base implementation
2026-07-18 Add FDM open-frame base for V3
    [base_and_return_interface.step, keyboard_mode.step, mid_mode.step, trackpad_mode.step]
2026-07-20 Refine V4 flexible belt interfaces
2026-07-20 Add V4 reel cartridge kinematics
2026-07-20 Model serviceable V4 toothed belt interfaces
2026-07-20 Correct V4 belt centerline contract
2026-07-20 Fix V4 belt continuity and wedge insertion
2026-07-20 Conserve V4 belt tooth phase at tangent
2026-07-20 Harden V4 belt topology and service paths
2026-07-20 Clear V4 exploded reel from shaft collars
2026-07-20 Add rounded V4 base and screwless supports
2026-07-20 Fix V4 screwless mount contracts
2026-07-20 Add press-release V4 guide assemblies
2026-07-20 Clamp V4 slider at moving belt endpoint
2026-07-20 Allow zero-volume belt tooth drum contact
2026-07-20 Export and validate V4 STEP deliverables
    [keyboard_mode.step, mid_mode.step, reel_cartridge_section_exploded.step, screwless_guide_mount_detail.step, trackpad_mode.step]
